roboime/SSL-Mec/README.md

# SSL-Mec
Repositório para a mecânica da SSL
