roboime/SSL-Mec/Robo 2021/SSL/Robô/Conjunto Motriz/073-rb-dfr-444.pdf

## RB-Dfr-444

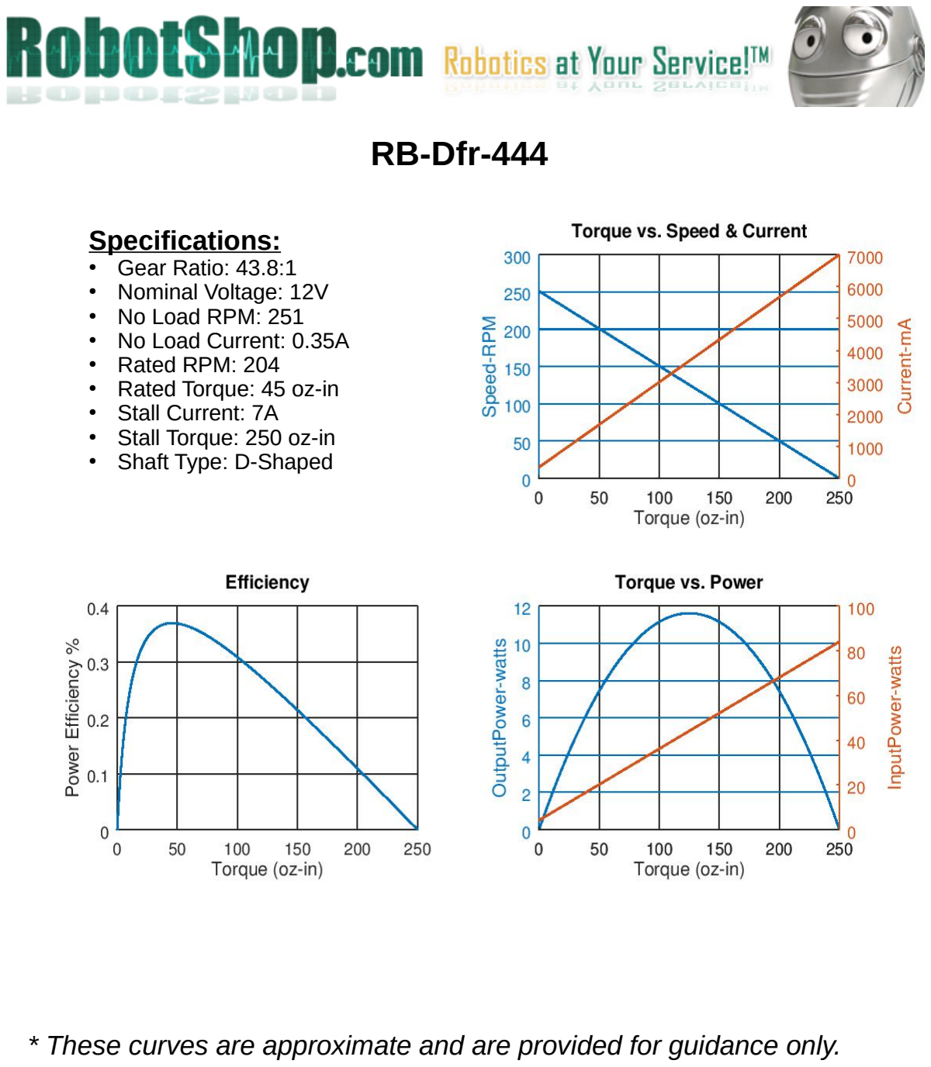
[picture p1: page 1]

* These curves are approximate and are provided for guidance only.

### Specifications:

- Gear Ratio: 43.8:1
- Nominal Voltage: 12V
- No Load RPM: 251
- No Load Current: 0.35A
- Rated RPM: 204
- Rated Torque: 45 oz-in
- Stall Current: 7A
- Stall Torque: 250 oz-in
- Shaft Type: D-Shaped
