roboime/SSL-Mec/Robo 2021/Patrono.pdf

Maria Quitéria de Jesus (27 de julho de 1792 – 21 de agosto de 1853) foi a primeira mulher a fazer parte do Exército Brasileiro. Considerada a heroína da I (https://brasilescola.uol.com.br/historiab/independencia-brasil.htm)ndependência, (https://brasilescola.uol.com.br/historiab/independencia-brasil.htm) a baiana fingiu ser homem para poder entrar nas Forças Armadas.
A jovem Maria Quitéria juntou-se às tropas que lutavam contra os portugueses em 1822. Ela utilizou o nome de seu cunhado, ficando conhecida como soldado Medeiros, já que somente homens faziam parte do Exército.

Semanas depois de entrar para o Exército, Maria Quitéria teve sua identidade revelada. No entanto, o major Silva e Castro não permitiu que ela saísse das tropas, já que era importante para a luta contra os portugueses por sua facilidade com o manejo de armas e sua disciplina em batalha.

Maria Quitéria tornou-se símbolo da emancipação feminina e exemplo para mulheres de todo o país.

A heroína da Independência foi condecorada patrona do Quadro Complementar de Oficiais do Exército Brasileiro. Em 1953, no aniversário de 100 anos de sua morte, o governo brasileiro decretou que seu retrato estivesse presente em todos as repartições e unidades do Exército.
