roboime/SSL-Mec/Robo 2021/SSL/Diversos/apostila-aco-inoxestampagem-28-728.jpg

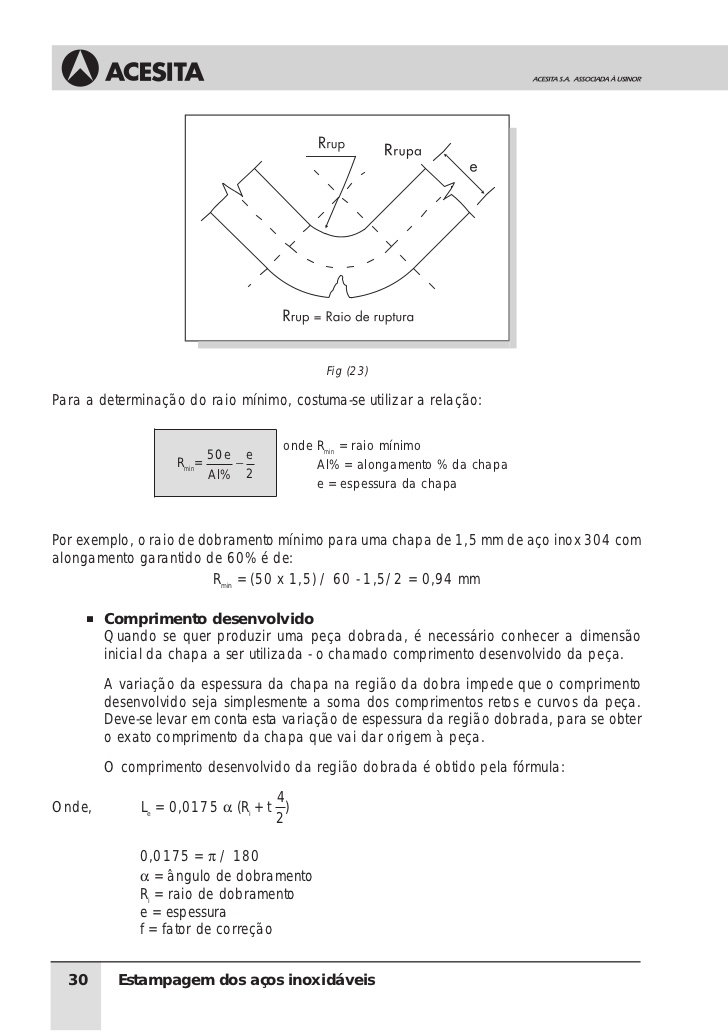
Robo 2021/SSL/Diversos/apostila-aco-inoxestampagem-28-728.jpg
