roboime/SSL-Mec/Project_2024/Sistema de chute/Acionador Chute Rasteiro.SLDASM

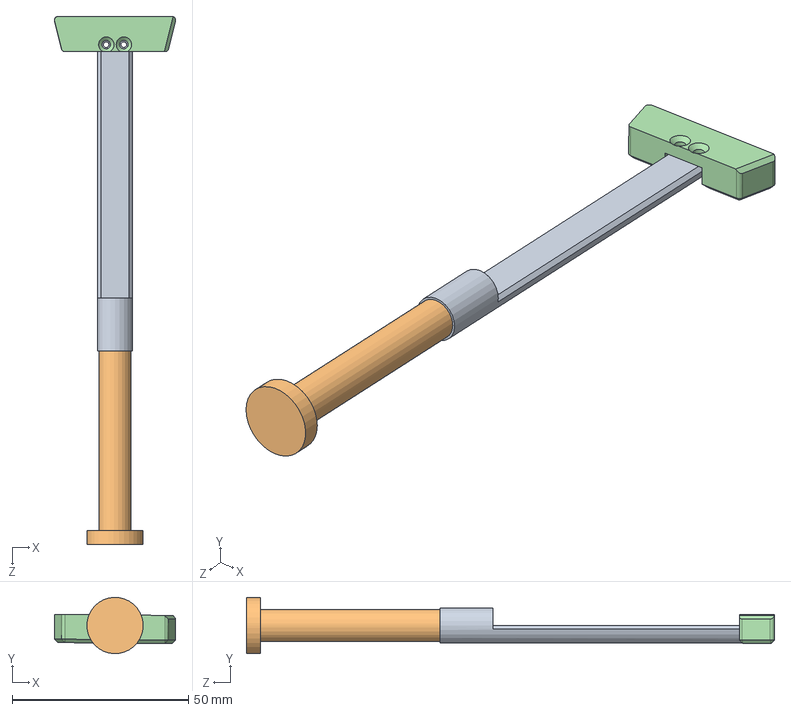
[picture p3: CAD file, 2024-02-03]
Project_2024/Sistema de chute/Acionador Chute Rasteiro.SLDASM
34.5 x 16.0 x 150.0 mm
Intermediário Chute-Alto
Pistão Chute Alto
Representação Eixo do Chute
Chute Rasteiro
