roboime/SSL-Mec/Project_2024/Sistema de chute/Driblador/Motor Driblador.SLDASM

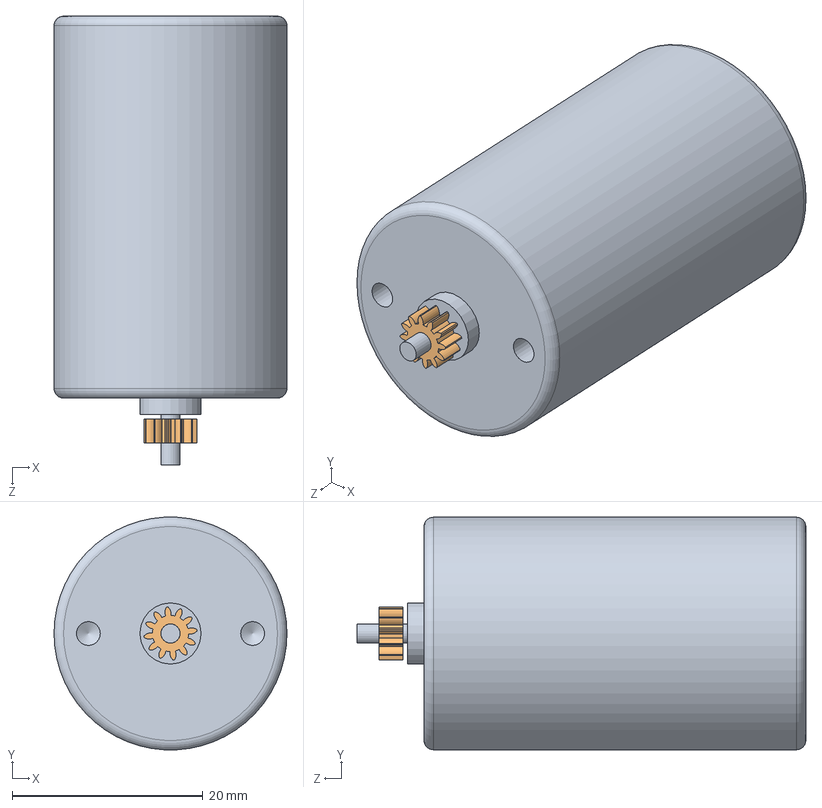
[picture p4: CAD file, 2024-02-03]
Project_2024/Sistema de chute/Driblador/Motor Driblador.SLDASM
24.4 x 24.4 x 47.0 mm
Mockup motor do driblador
Metric - Spur gear 0.4M 12T 20PA 2.5FW ---S12N75H50L2N
