roboime/SSL-Mec/Robo 2021/SSL/Robô/Conjunto Motriz/Conjunto Omni/45 mm/Montagem das peças a serem usinadas.SLDASM

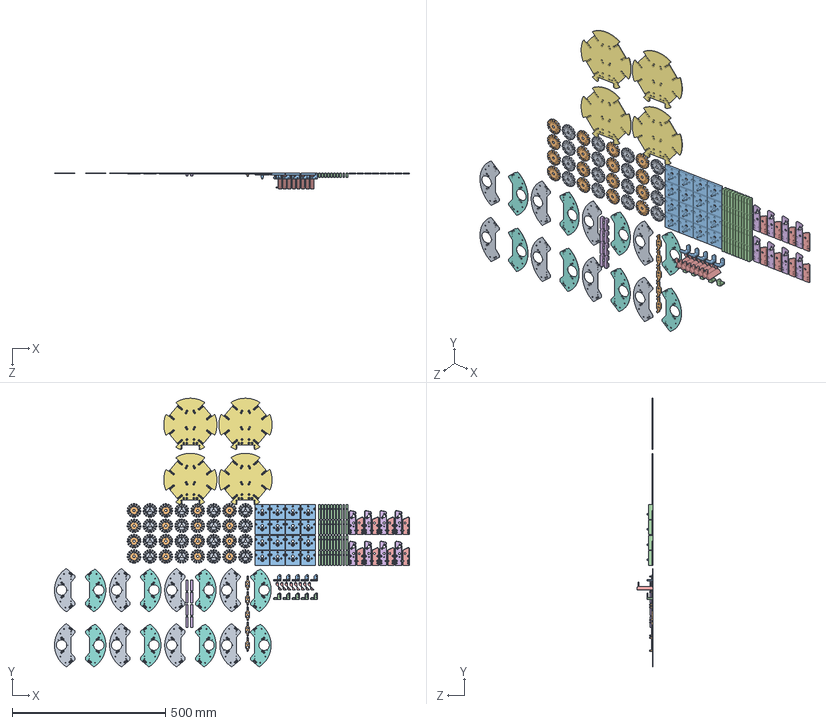
[picture p5: CAD file, 2021-10-12]
Robo 2021/SSL/Robô/Conjunto Motriz/Conjunto Omni/45 mm/Montagem das peças a serem usinadas.SLDASM
1159.9 x 877.7 x 53.0 mm
Corpo Interno x 16
Corpo Externo x 16
Suporte da roda x 16
Suporte Estrutura Aluminio x 40
Suporte esquerdo driblador x 8
Suporte direito driblador x 8
Assoalho x 4
2 Andar - Direito x 8
2 Andar - Esquerdo x 8
Apoio engrenagem x 5
Suporte Chute-Alto Esquerdo x 5
Suporte Chute-Alto Direito x 5
Chip - Chute Alto x 8
Chute rasteiro novo x 8
