roboime/SSL-Mec/Robo 2021/SSL/Robô/Conjunto Motriz/Motor e Suporte/Suporte montado.SLDASM

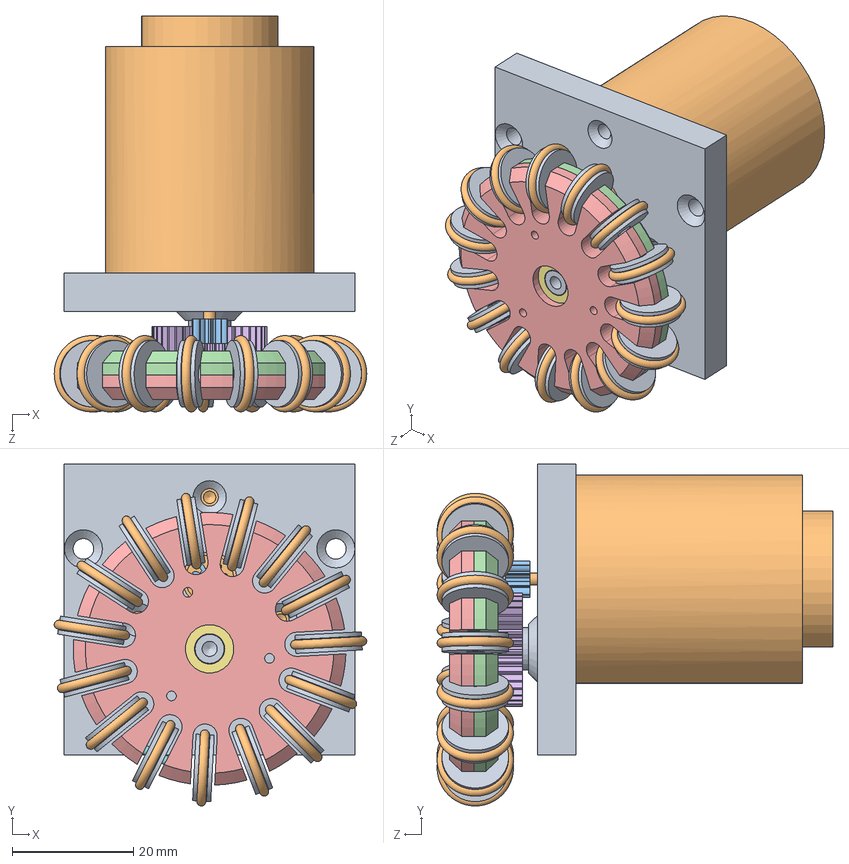
[picture p6: CAD file, 2021-10-12]
Robo 2021/SSL/Robô/Conjunto Motriz/Motor e Suporte/Suporte montado.SLDASM
51.6 x 56.4 x 65.3 mm
Suporte da roda
Mockup Motor
Metric - Spur gear 0.5M 10T 20PA 3,5FW
Corpo Interno
Corpo Externo
Metric - Spur gear 0.5M 36T 20PA
5x9x4
Arame
Rodilha x 15
O-Ring 10x7x1,5 mm x 15
