roboime/SSL-Mec/Robo 2021/SSL/Robô/engrenagens a Imprimir.SLDASM

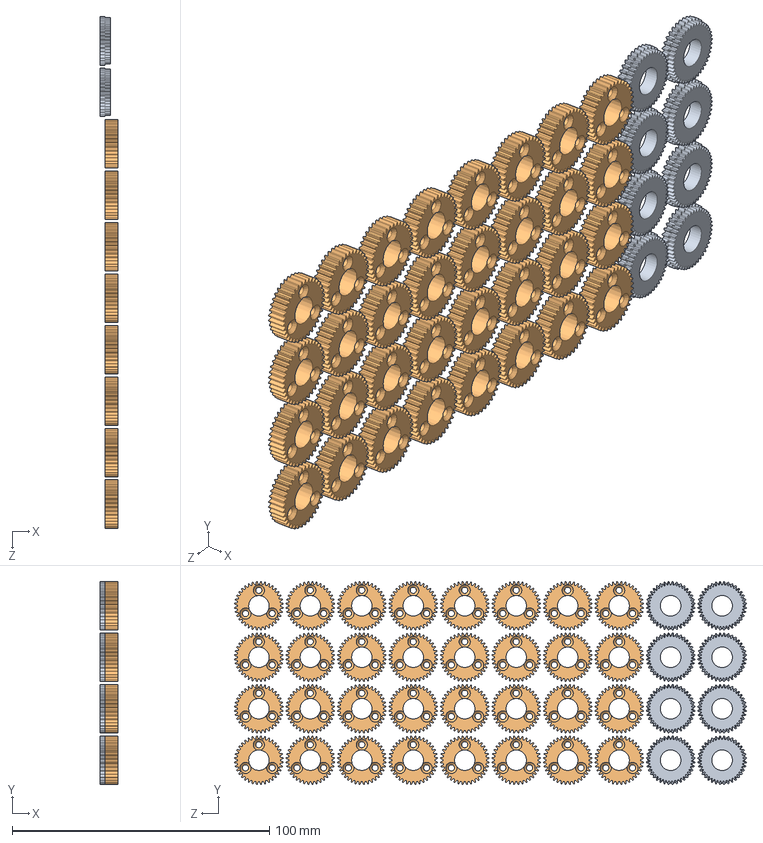
[picture p7: CAD file, 2021-10-12]
Robo 2021/SSL/Robô/engrenagens a Imprimir.SLDASM
7.00 x 79.0 x 199.0 mm
engrengens x 8
Metric - Spur gear 0.5M 36T 20PA x 32
