roboime/SSL-Mec/Robo 2021/SSL/Robô/Montagens/Montagem Segundo Andar- Esquerdo.SLDASM

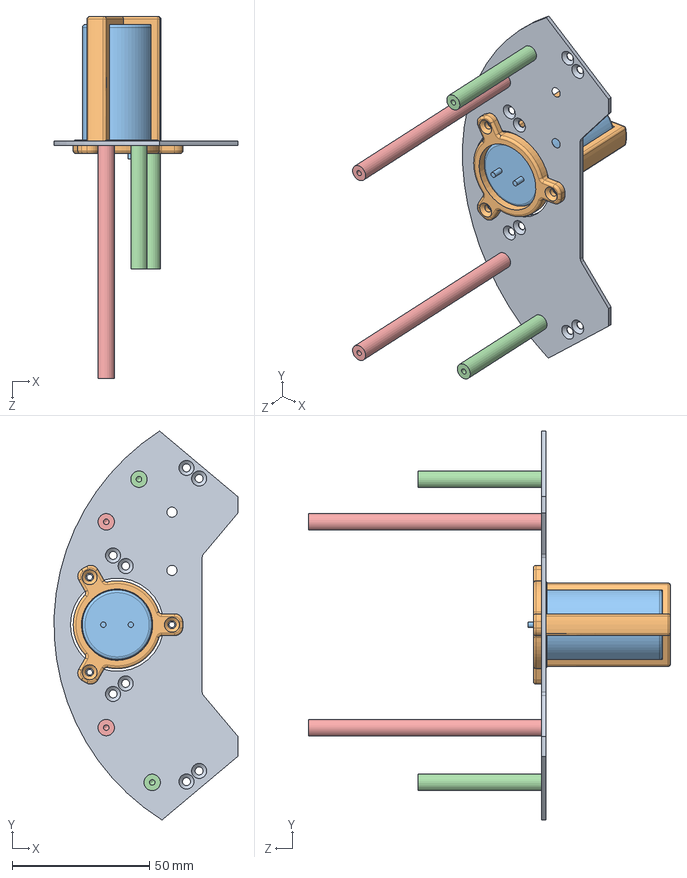
[picture p8: CAD file, 2021-10-12]
Robo 2021/SSL/Robô/Montagens/Montagem Segundo Andar- Esquerdo.SLDASM
66.9 x 141.8 x 132.0 mm
2 Andar - Esquerdo
Suporte do Capacitor
Mockup Capacitor
Suporte ELO x 2
Suporte Tampa x 2
