roboime/SSL-Mec/Robo 2021/SSL/Robô/Suportes da ELO/Mockup Mainboard.SLDPRT

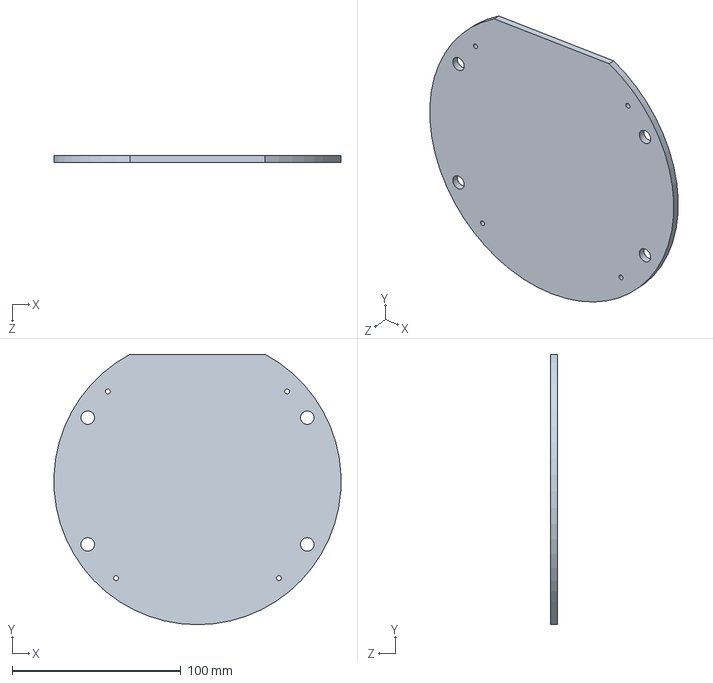
[picture p9: CAD file, 2021-10-04]
Robo 2021/SSL/Robô/Suportes da ELO/Mockup Mainboard.SLDPRT
169.8 x 160.0 x 4.00 mm
