roboime/SSL-Mec/Project_2024/Sistema de chute/Chip Alto - Montado.SLDASM

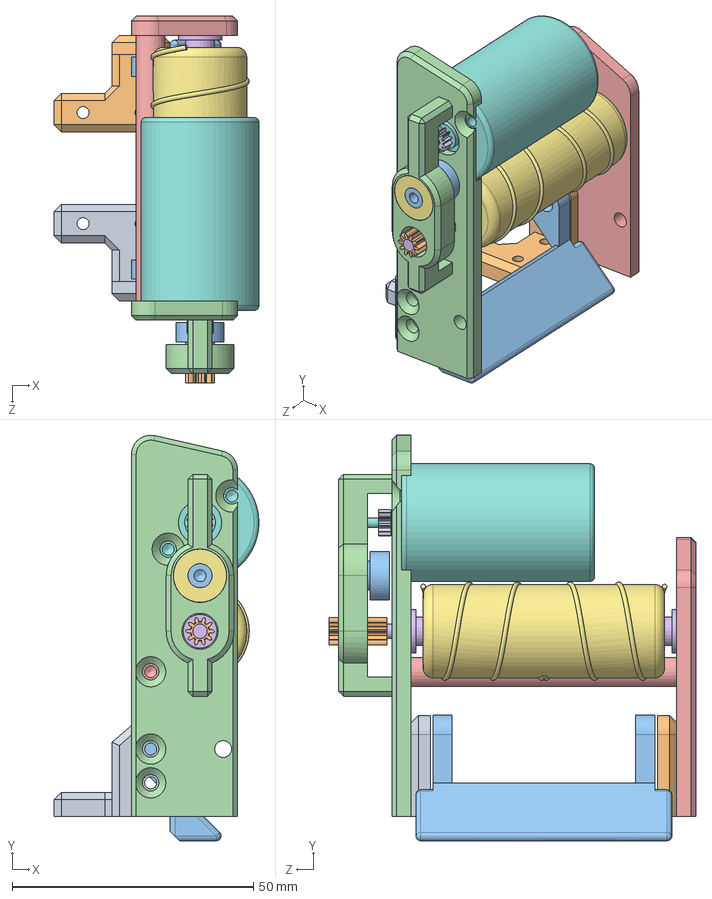
[picture p10: CAD file, 2024-02-03]
Project_2024/Sistema de chute/Chip Alto - Montado.SLDASM
42.4 x 84.0 x 76.0 mm
Suporte Chute-Alto Direito
Suporte Chute-Alto Esquerdo
Chip - Chute Alto
Suporte direito driblador
Suporte esquerdo driblador
Eixo Driblador
Rolete Driblador
Mockup motor do driblador
Metric - Spur gear 0.4M 12T 20PA 2.5FW ---S12N75H50L2N
Metric - Spur gear 0.5M 10T 20PA 12FW
Eixo engrenagem do drible
Apoio engrenagem
Estrutura transversal
Rolamento 4x9x4 x 2
5x9x4 do Chute
