roboime/SSL-Mec/Robo 2021/SSL/Diversos/Motor + Suporte + Caixa Redutora/SUPORTE+MOTOR LARC Opção B.SLDASM

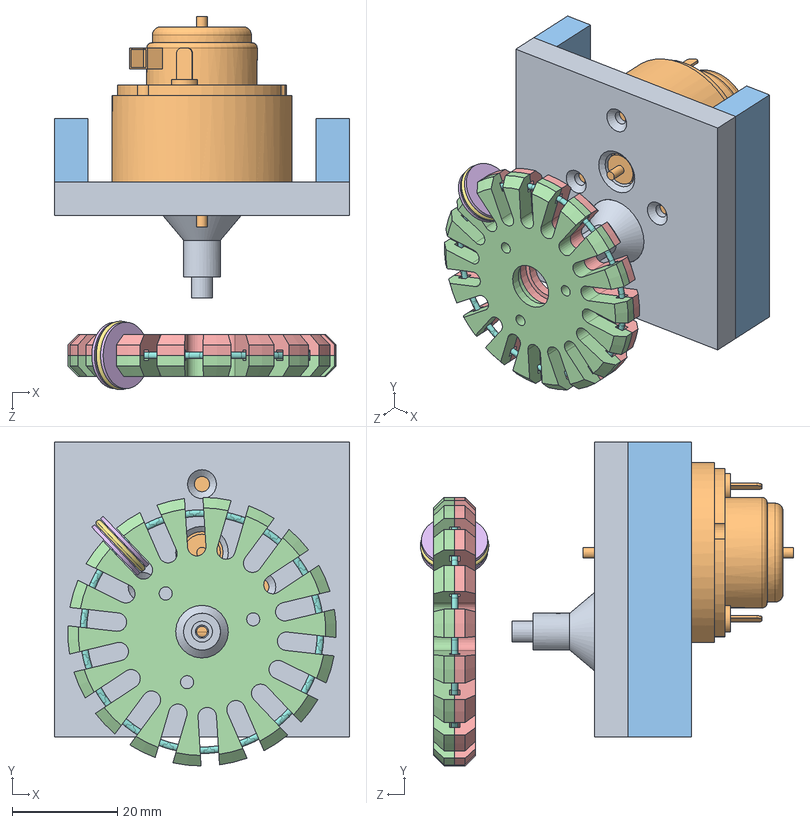
[picture p11: CAD file, 2021-10-04]
Robo 2021/SSL/Diversos/Motor + Suporte + Caixa Redutora/SUPORTE+MOTOR LARC Opção B.SLDASM
56.0 x 61.5 x 70.9 mm
SUPORTE_MOTOR LARC
Suporte Estrutura b x 2
Eixo
