roboime/SSL-Mec/Robo 2021/SSL/Diversos/Teste de posição.SLDASM

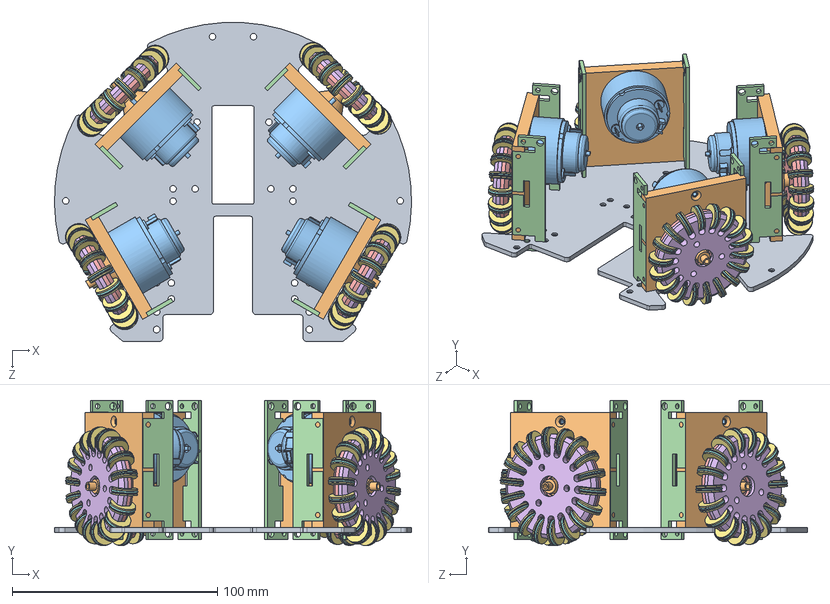
[picture p12: CAD file, 2021-10-04]
Robo 2021/SSL/Diversos/Teste de posição.SLDASM
174.0 x 70.8 x 155.4 mm
Assoalho
SUPORTE_MOTOR LARC x 4
Hsiang Neng Motor LARC x 4
Suporte Estrutura x 8
Corpo da Roda externo LARC x 4
Corpo da Roda interno LARC x 4
Rodilha LARC x 72
H-ring (meia manga) LARC x 72
Aro omni LARC x 4
