roboime/SSL-Mec/Robo 2021/SSL/Robô/Conjunto Motriz/Motor e Suporte/Motor.SLDASM

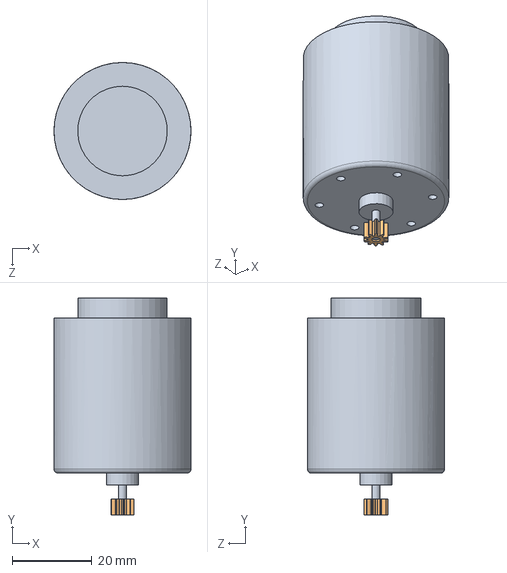
[picture p13: CAD file, 2021-10-12]
Robo 2021/SSL/Robô/Conjunto Motriz/Motor e Suporte/Motor.SLDASM
34.4 x 54.5 x 34.4 mm
Mockup Motor
Metric - Spur gear 0.5M 10T 20PA 3,5FW
