roboime/SSL-Mec/Robo 2021/SSL/Robô/Montagens/Montagem Acionadores dos Chutes.SLDASM

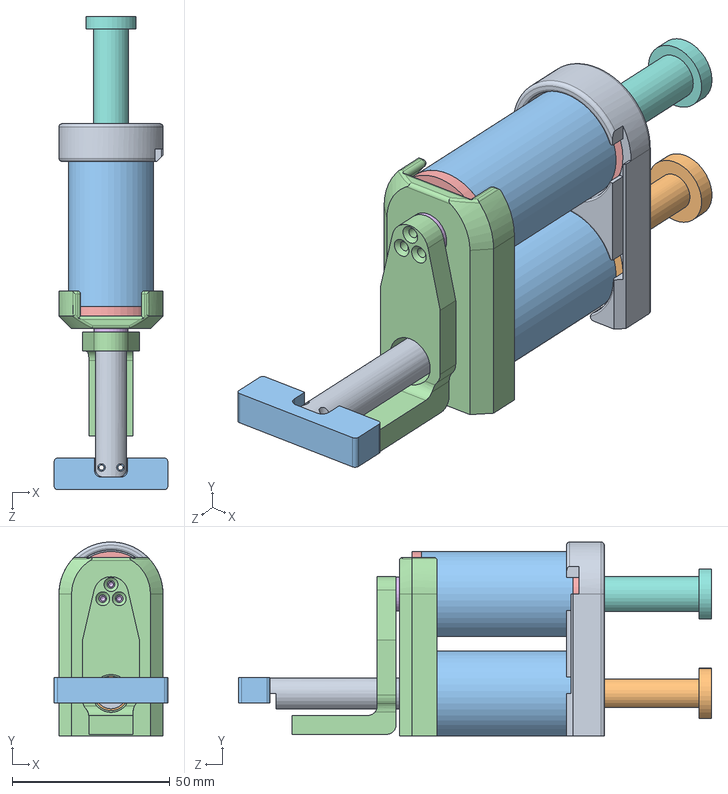
[picture p14: CAD file, 2021-10-12]
Robo 2021/SSL/Robô/Montagens/Montagem Acionadores dos Chutes.SLDASM
36.0 x 61.5 x 150.0 mm
Suporte traseiro
Carretel do Solenoide Alto
Representação Bobina de Cobre x 2
Suporte Frontal
Carretel do Solenoide
Intermediário Chute-Rasteiro
Representação Eixo do Chute x 2
Pistão
Intermediário Chute-Alto
Pistão Chute Alto
Chute rasteiro novo
Acionador Chute Alto 3
