roboime/SSL-Mec/Robo 2021/SSL/Robô/Sistema de chute/SSL-Motherboarda.step.SLDASM

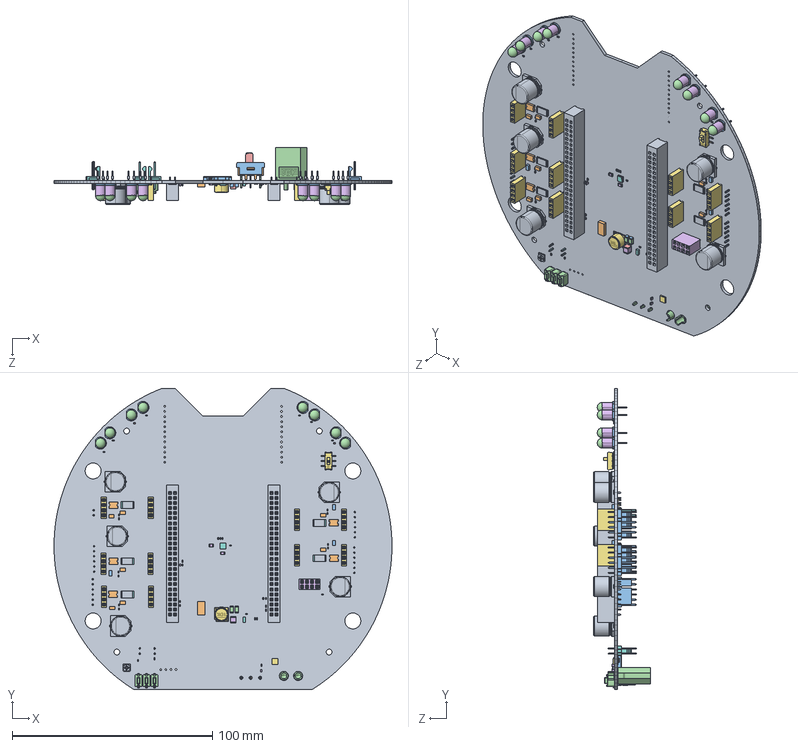
[picture p15: CAD file, 2021-10-12]
Robo 2021/SSL/Robô/Sistema de chute/SSL-Motherboarda.step.SLDASM
169.0 x 150.6 x 28.4 mm
_CS12ANW03-body.step
_CS12ANW03-top.step
_CS12ANW03-term.step
_CS12ANW03-slide.step
Extruded.step x 4
Extruded-0.step
SW3dPS-LEDd5C_Extruded3.step x 16
SW3dPS-LEDd5C_Extruded.step x 16
SW3dPS-LEDd5C_Extruded1.step x 8
SW3dPS-LEDd5C_Extruded4.step x 8
SW3dPS-LEDd5C_Sphere.step x 8
SW3dPS-LEDd5C_Extruded2.step x 8
SW3dPS-LEDd5C_Cylinder.step x 8
1.step
2.step
3.step
BOSCH_logo.step
4.step
95C04B.step x 3
Extruded-1.step x 4
Extruded-2.step x 2
Extruded-3.step x 32
Extruded-4.step x 16
BOUR-TC33X-2_2.step
Extruded-5.step x 2
Extruded-6.step x 3
Extruded-7.step x 16
Extruded-8.step x 11
Extruded-9.step x 6
js202011scqn.step
Extruded-10.step x 10
Extruded-11.step x 5
Extruded-12.step x 5
2908-05xx-xx-02.step
Extruded-13.step x 16
Extruded-14.step x 8
_____C042LFBN-RC_RGB8421504.step
_____C041LFBN-RC_RGB8421504.step x 10
SW3dPS-capg.step x 5
mf-msmf250_16x_RGB8421504.step x 5
Extruded-16.step x 4
Extruded-17.step x 2
Extruded-18.step x 2
Extruded-19.step
User_Library-Coil.step
Extruded-20.step
SFH11-P___C-D25-ST-___-M181.step x 2
Extruded-21.step
User_Library-XT60_male.step
