roboime/SSL-Mec/Robo 2021/SSL/Robô/Conjunto Motriz/Conjunto Omni/45 mm/Montagem da roda.SLDASM

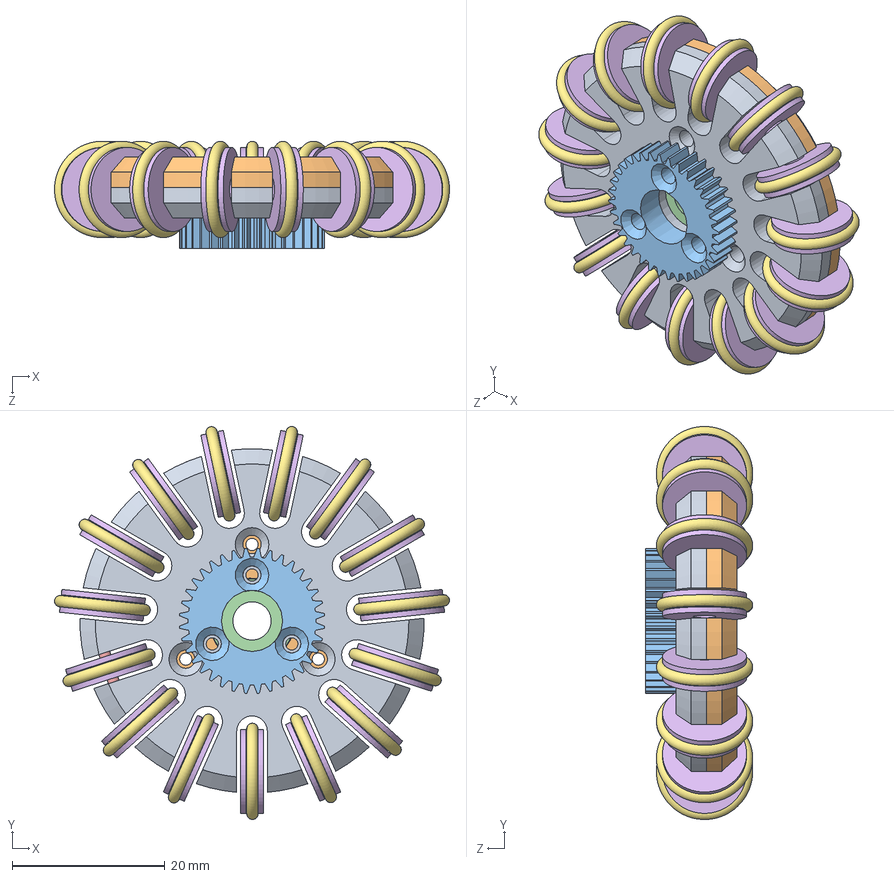
[picture p16: CAD file, 2021-10-12]
Robo 2021/SSL/Robô/Conjunto Motriz/Conjunto Omni/45 mm/Montagem da roda.SLDASM
51.6 x 51.4 x 14.0 mm
Corpo Interno
Corpo Externo
Metric - Spur gear 0.5M 36T 20PA
5x9x4
Arame
Rodilha x 15
O-Ring 10x7x1,5 mm x 15
