roboime/SSL-Mec/Robo 2021/SSL/Robô/Conjunto Motriz/Conjunto Omni/Conjunto Motriz(1).sldasm

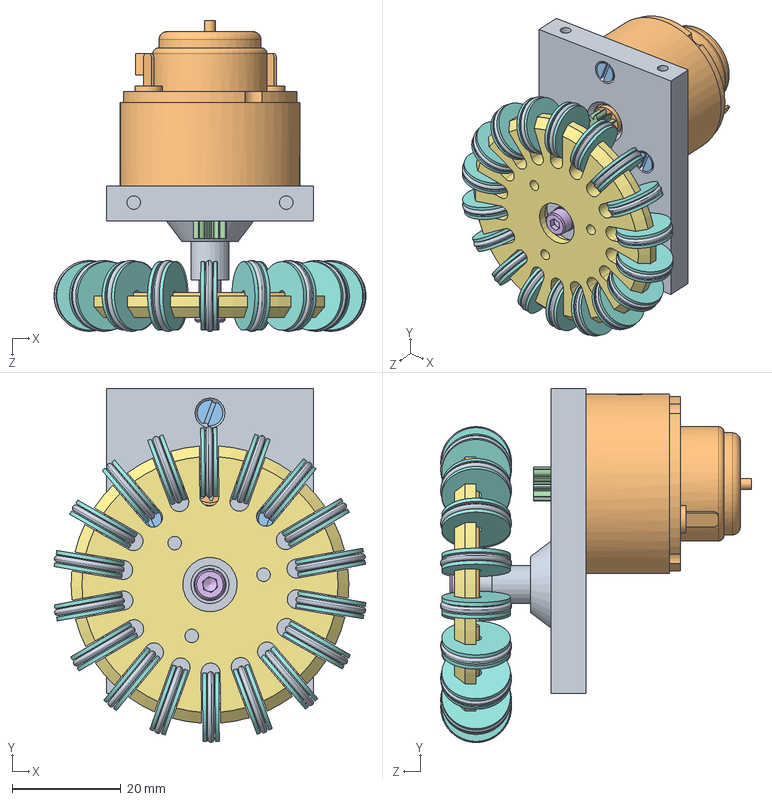
[picture p17: CAD file, 2021-10-04]
Robo 2021/SSL/Robô/Conjunto Motriz/Conjunto Omni/Conjunto Motriz(1).sldasm
57.3 x 65.0 x 57.0 mm
SUPORTE_MOTOR LARC
Hsiang Neng Motor LARC
M3x13 Escareada - Fenda x 3
Engrenagem do MotorC LARC
Arruela M3
M3x10 Cilindrica - Allien
Corpo da Roda externo LARC
Rodilha LARC x 18
H-ring (meia manga) LARC x 18
Aro omni LARC
