roboime/SSL-Mec/Robo 2021/SSL/Robô/Conjunto Motriz/Conjunto Omni/Rodilha Com O-Ring/Rodilha Com O Ring.SLDASM

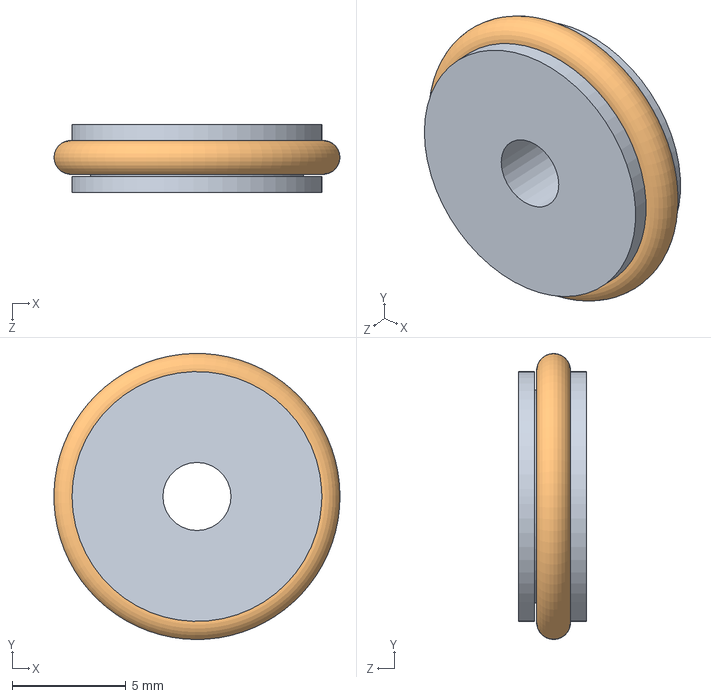
[picture p18: CAD file, 2021-10-04]
Robo 2021/SSL/Robô/Conjunto Motriz/Conjunto Omni/Rodilha Com O-Ring/Rodilha Com O Ring.SLDASM
12.6 x 12.6 x 3.00 mm
Rodilha
O-Ring 10x7x1,5 mm
