roboime/SSL-Mec/Robo 2021/SSL/Robô/Conjunto Motriz/Motor e Suporte/Motor/Mockup Motor.SLDASM

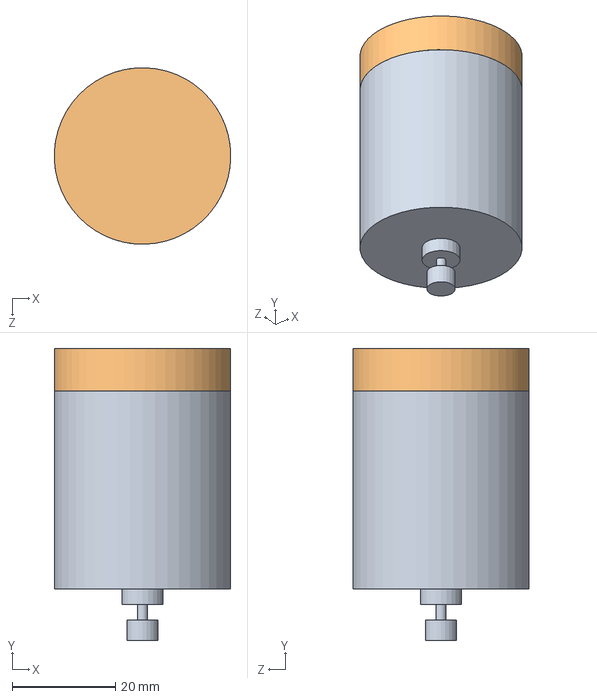
[picture p19: CAD file, 2021-10-04]
Robo 2021/SSL/Robô/Conjunto Motriz/Motor e Suporte/Motor/Mockup Motor.SLDASM
34.2 x 56.5 x 34.2 mm
motor
Tampa preta motor
