roboime/SSL-Mec/Robo 2021/SSL/Robô/Montagens/Montagem Motriz 1.SLDASM

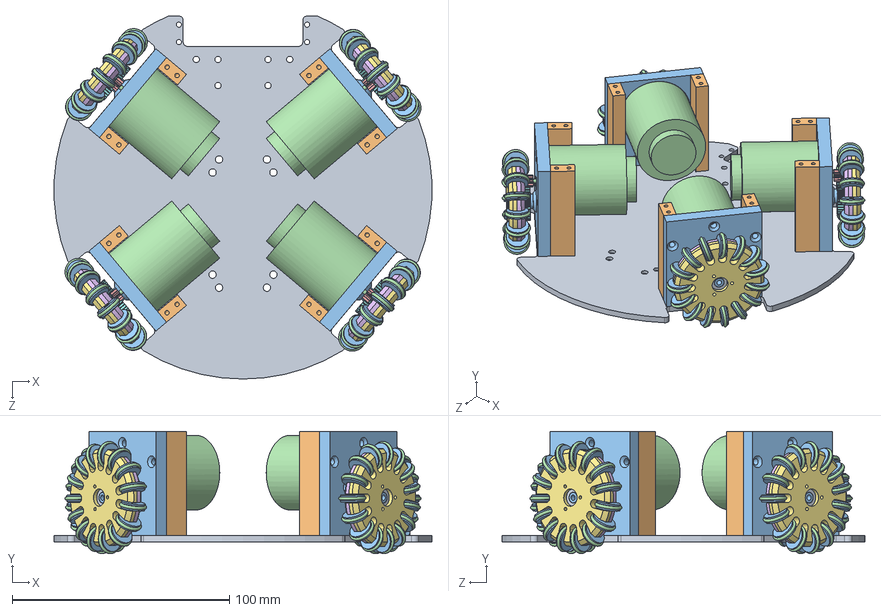
[picture p20: CAD file, 2021-10-12]
Robo 2021/SSL/Robô/Montagens/Montagem Motriz 1.SLDASM
173.7 x 56.3 x 167.0 mm
Assoalho
Suporte Estrutura Aluminio x 8
Suporte da roda x 4
Mockup Motor x 4
Metric - Spur gear 0.5M 10T 20PA 3,5FW x 4
Corpo Interno x 4
Corpo Externo x 4
Metric - Spur gear 0.5M 36T 20PA x 4
5x9x4 x 4
Arame x 4
Rodilha x 60
O-Ring 10x7x1,5 mm x 60
