roboime/SSL-Mec/Project_2024/Sistema de chute/Acionador Chute Alto 2.SLDASM

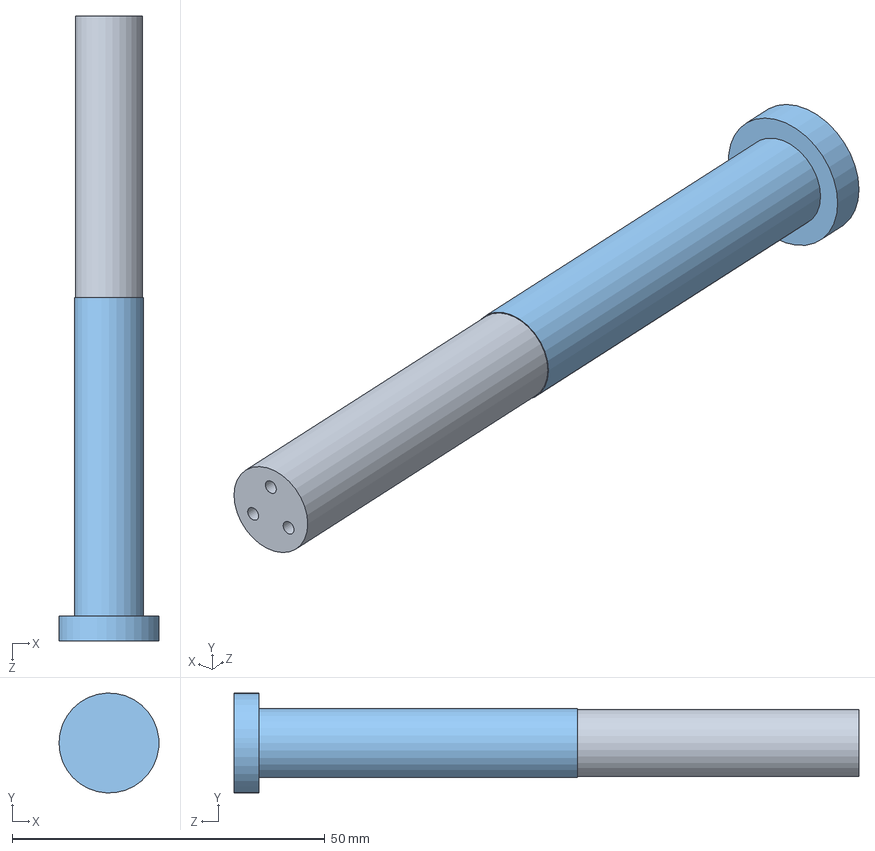
[picture p21: CAD file, 2024-02-03]
Project_2024/Sistema de chute/Acionador Chute Alto 2.SLDASM
16.0 x 16.0 x 100.0 mm
Intermediário Chute-Rasteiro
Representação Eixo do Chute
Pistão
