roboime/SSL-Mec/Robo 2021/SSL/Diversos/Teste de posição 2.SLDASM

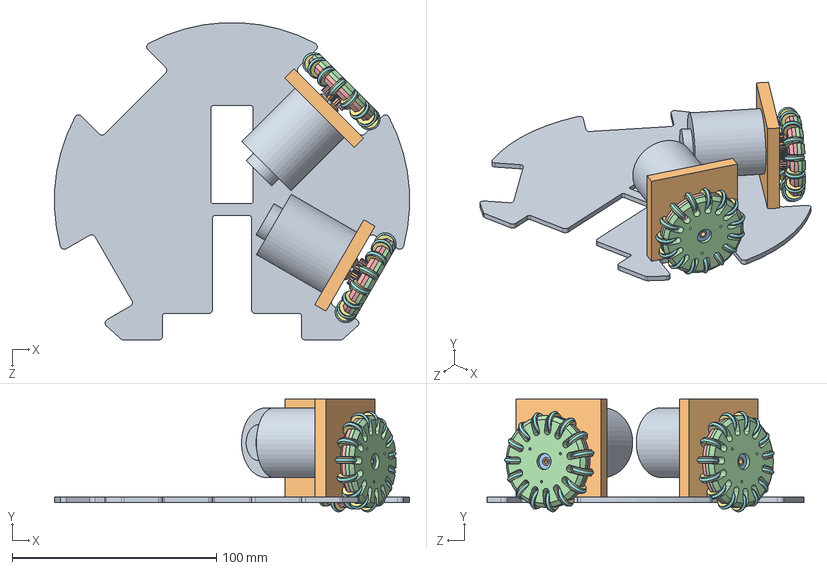
[picture p22: CAD file, 2021-10-04]
Robo 2021/SSL/Diversos/Teste de posição 2.SLDASM
173.8 x 55.2 x 155.4 mm
Assoalho - Copia
Suporte da roda x 2
Rep Rolamento 4x9x4mm x 2
Corpo Externo de 30 x 2
Interna de 30 dentes x 2
Aro de Rodilha x 2
Rodilha x 30
O-Ring 10,5x7,5x1,5 mm x 30
Mockup Motor x 2
Engrenagem do Motor x 2
