roboime/SSL-Mec/Robo 2021/SSL/Robô/Conjunto Motriz/Conjunto Omni/45 mm/Montagem das peças a serem usinadas - torno.SLDASM

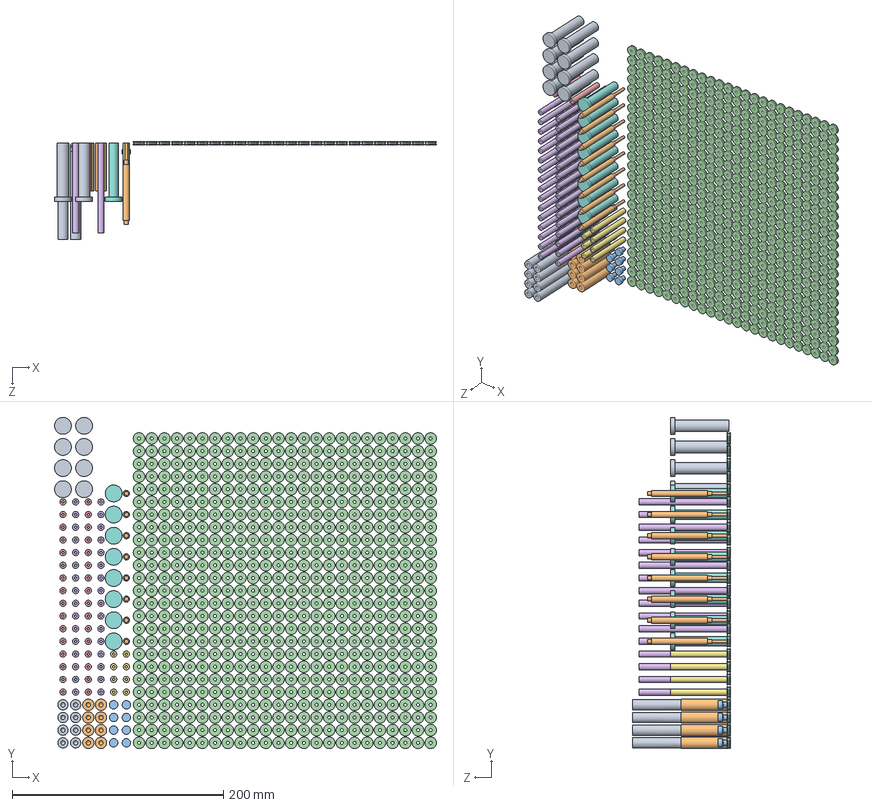
[picture p23: CAD file, 2021-10-12]
Robo 2021/SSL/Robô/Conjunto Motriz/Conjunto Omni/45 mm/Montagem das peças a serem usinadas - torno.SLDASM
361.5 x 313.5 x 92.5 mm
Intermediário Chute-Alto x 8
Intermediário Chute-Rasteiro x 8
Eixo engrenagem do drible x 8
Rodilha x 600
Suporte ELO x 32
Suporte Tampa x 32
Estrutura transversal x 8
Pistão Chute Alto x 8
Pistão x 8
Eixo Driblador x 8
