roboime/SSL-Mec/Robo 2021/SSL/Robô/Suportes da ELO/Suporte com Capacitor.SLDASM

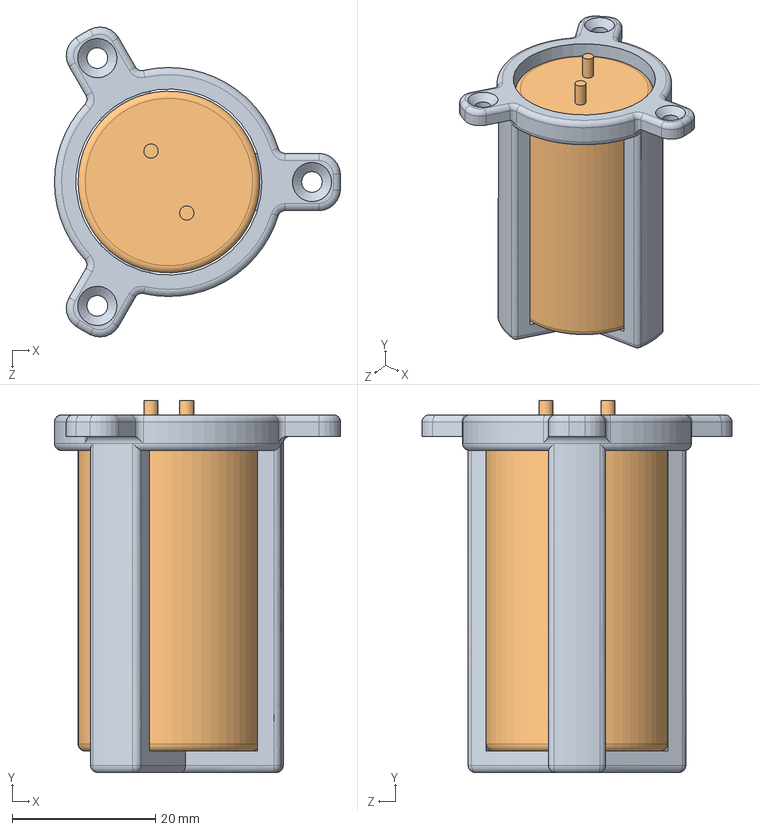
[picture p24: CAD file, 2021-10-04]
Robo 2021/SSL/Robô/Suportes da ELO/Suporte com Capacitor.SLDASM
40.0 x 52.0 x 43.3 mm
Suporte do Capacitor
Mockup Capacitor
