roboime/SSL-Mec/Robo 2021/SSL/Diversos/Motor + Suporte + Caixa Redutora/SUPORTE+MOTOR LARC.SLDASM

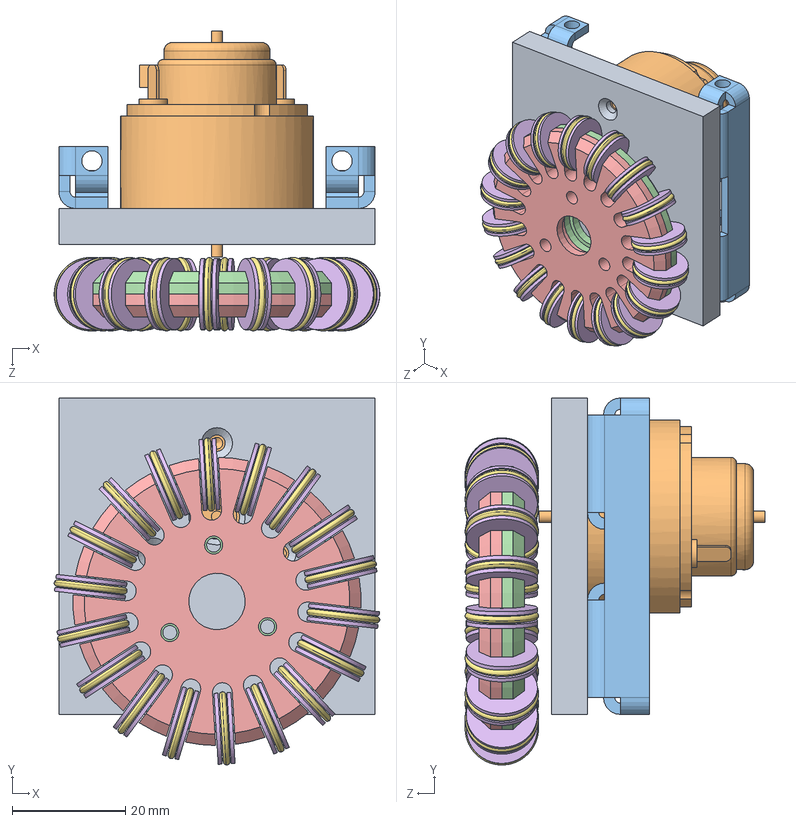
[picture p25: CAD file, 2021-10-04]
Robo 2021/SSL/Diversos/Motor + Suporte + Caixa Redutora/SUPORTE+MOTOR LARC.SLDASM
57.6 x 64.9 x 53.1 mm
SUPORTE_MOTOR LARC
Hsiang Neng Motor LARC
Suporte Estrutura x 2
Corpo da Roda externo LARC
Corpo da Roda interno LARC
Rodilha LARC x 18
H-ring (meia manga) LARC x 18
Aro omni LARC
