roboime/SSL-Mec/Robo 2021/SSL/Robô/Montagens/Montagem 2 Andar.SLDASM

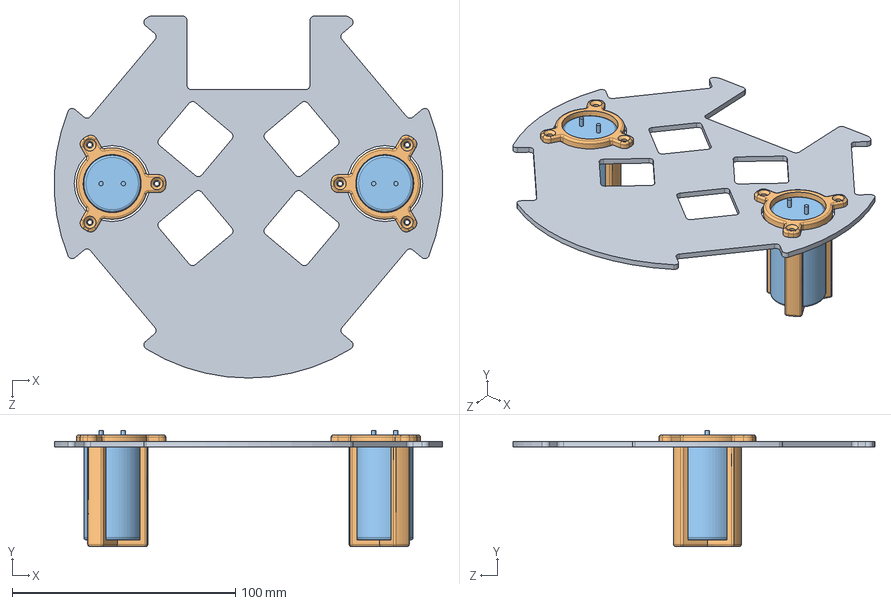
[picture p26: CAD file, 2021-10-04]
Robo 2021/SSL/Robô/Montagens/Montagem 2 Andar.SLDASM
173.7 x 52.0 x 162.0 mm
2 Andar
Suporte do Capacitor x 2
Mockup Capacitor x 2
