roboime/SSL-Mec/Robo 2021/SSL/Robô/Sistema de chute/Driblador/engrengens.SLDASM

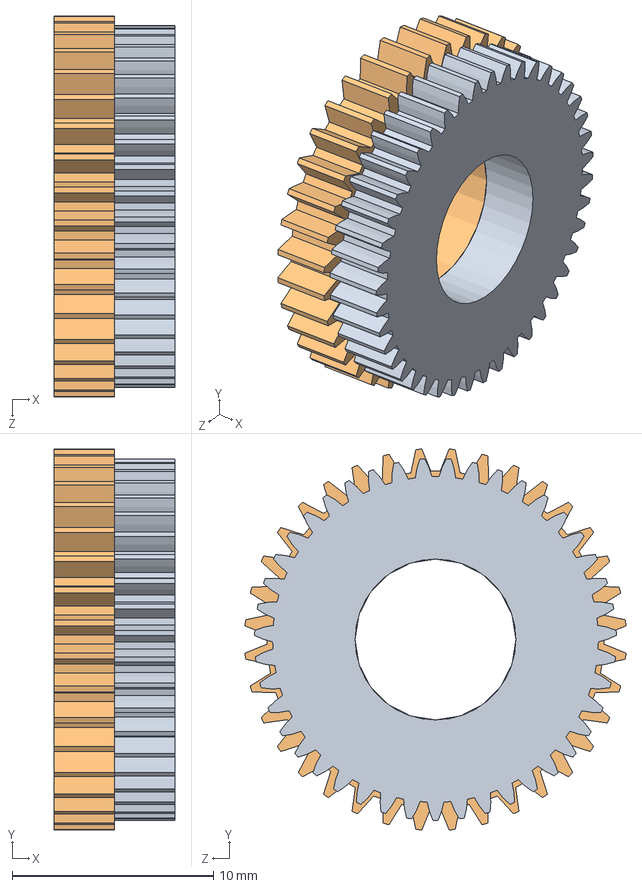
[picture p27: CAD file, 2021-10-12]
Robo 2021/SSL/Robô/Sistema de chute/Driblador/engrengens.SLDASM
6.00 x 19.0 x 19.0 mm
Metric - Spur gear 0.4M 43T 20PA 3FW ---S43N75H50L8N
Metric - Spur gear 0.5M 36T 20PA
