roboime/SSL-Mec/Project_2024/Sistema de chute/Suporte com solenoides.SLDASM

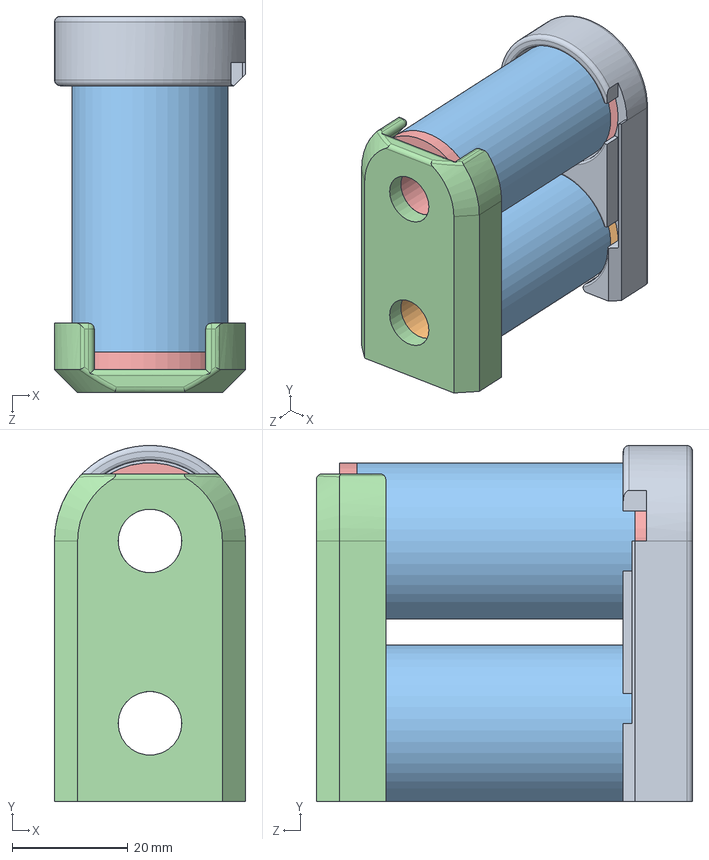
[picture p28: CAD file, 2021-10-04]
Project_2024/Sistema de chute/Suporte com solenoides.SLDASM
33.0 x 61.5 x 65.0 mm
Suporte traseiro
Carretel do Solenoide Alto
Representação Bobina de Cobre x 2
Suporte Frontal
Carretel do Solenoide
