roboime/SSL-Mec/Robo 2021/SSL/Robô/Conjunto Motriz/Conjunto Omni/45 mm/Montagem da Roda 30 dentes.SLDASM

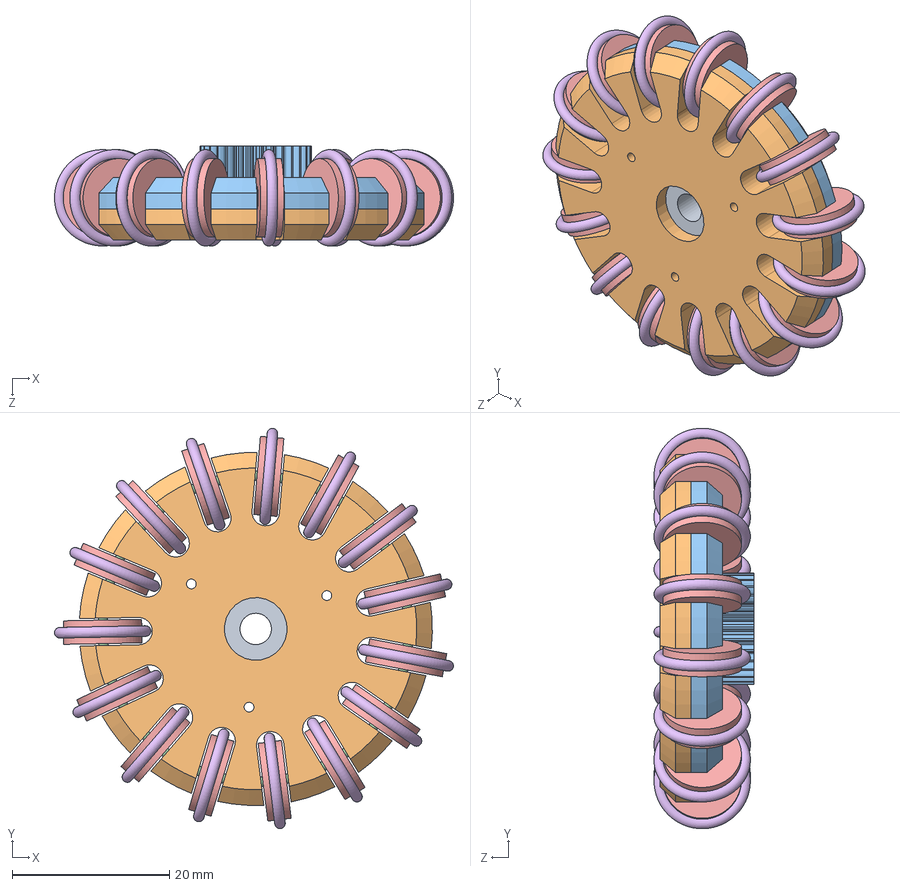
[picture p29: CAD file, 2021-10-04]
Robo 2021/SSL/Robô/Conjunto Motriz/Conjunto Omni/45 mm/Montagem da Roda 30 dentes.SLDASM
50.8 x 51.0 x 12.7 mm
Rep Rolamento 4x9x4mm
Corpo Externo de 30
Interna de 30 dentes
Aro de Rodilha
Rodilha x 15
O-Ring 10x7x1,5 mm x 15
