roboime/SSL-Mec/Project_2024/Sistema de chute/Representação Solenoide com Bobina.SLDASM

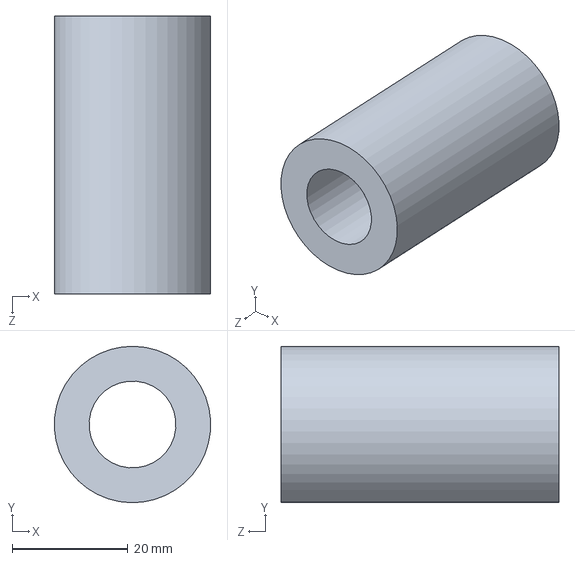
[picture p30: CAD file, 2021-10-04]
Project_2024/Sistema de chute/Representação Solenoide com Bobina.SLDASM
27.0 x 27.0 x 48.0 mm
