roboime/SSL-Mec/Project_2024/Sistema de chute/driblador.SLDASM

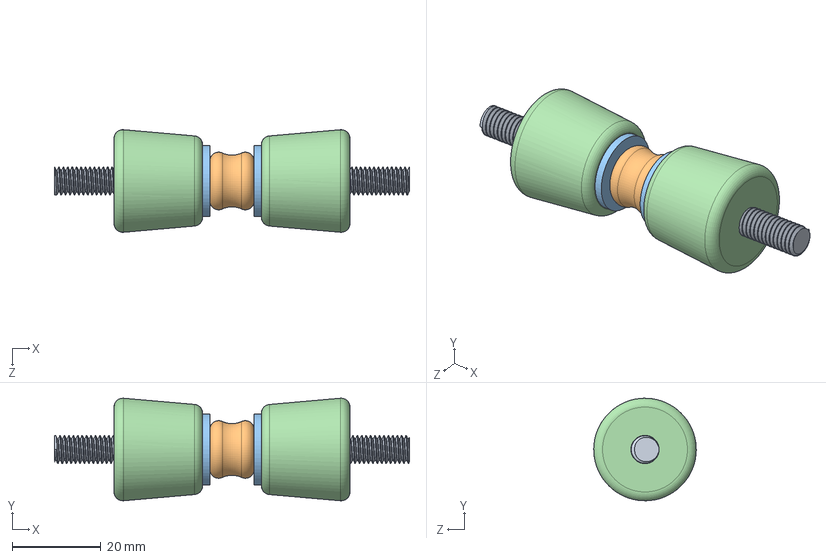
[picture p31: CAD file, 2021-10-04]
Project_2024/Sistema de chute/driblador.SLDASM
80.0 x 23.1 x 23.1 mm
eixo
polia
plain washer 10669 type nl_iso x 2
rolete x 2
