roboime/SSL-Mec/Project_2024/Peças e Montagens/Roda.SLDASM

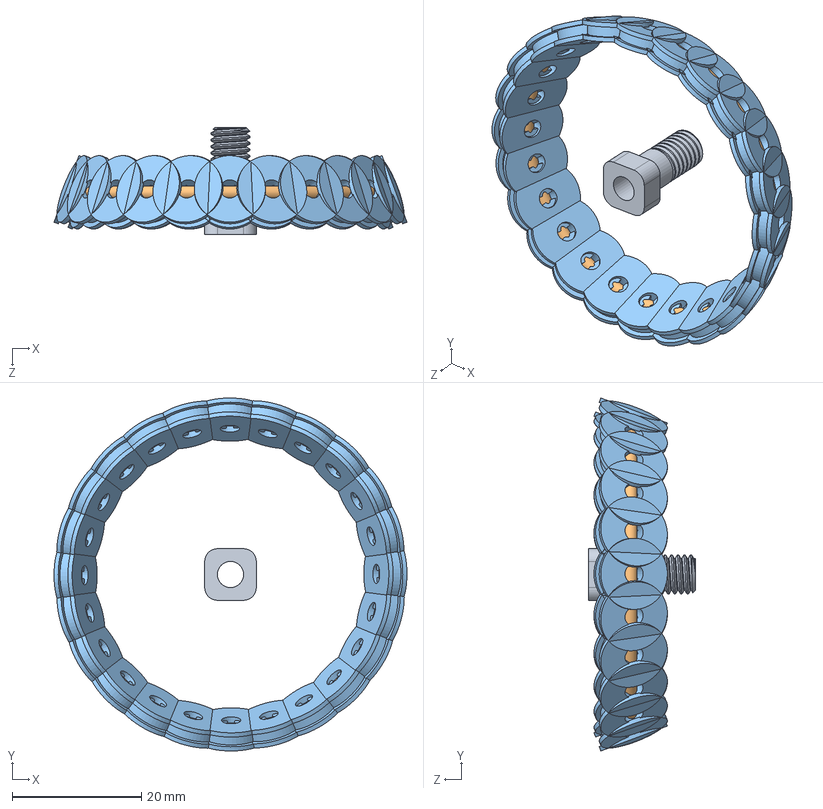
[picture p32: CAD file, 2024-02-03]
Project_2024/Peças e Montagens/Roda.SLDASM
54.6 x 54.6 x 16.5 mm
Rodilha x 24
Eixo da rodilha x 24
Transmissor de torque da roda
