roboime/SSL-Mec/Project_2024/Peças e Montagens/Roda explodida.SLDASM

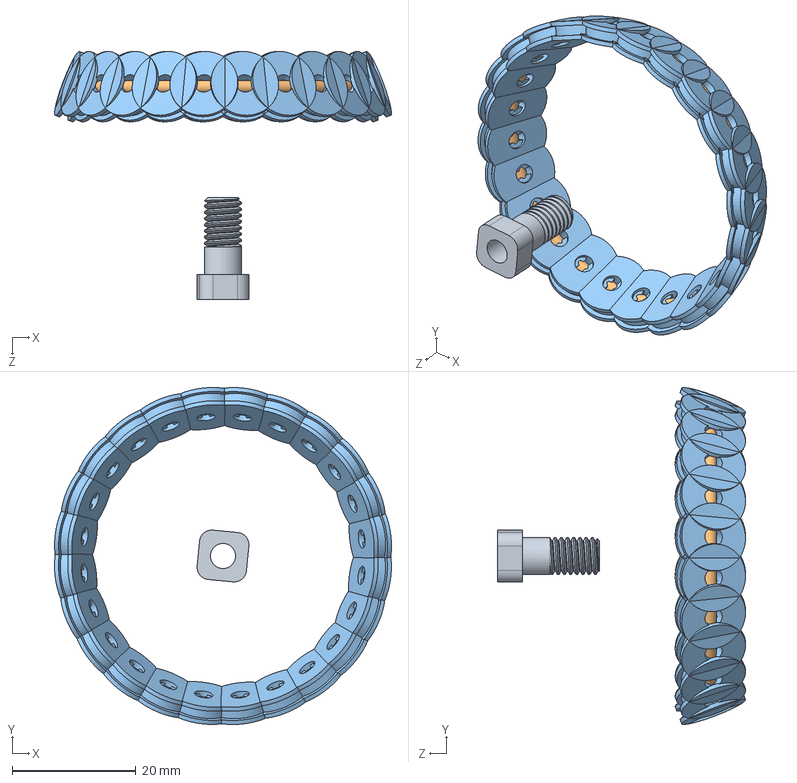
[picture p33: CAD file, 2024-02-03]
Project_2024/Peças e Montagens/Roda explodida.SLDASM
54.4 x 54.4 x 40.0 mm
Rodilha x 24
Eixo da rodilha x 24
Transmissor de torque da roda
