roboime/SSL-Mec/Project_2024/Arquivos .STEP para Usinagem/Pistão chute rasteiro.SLDPRT

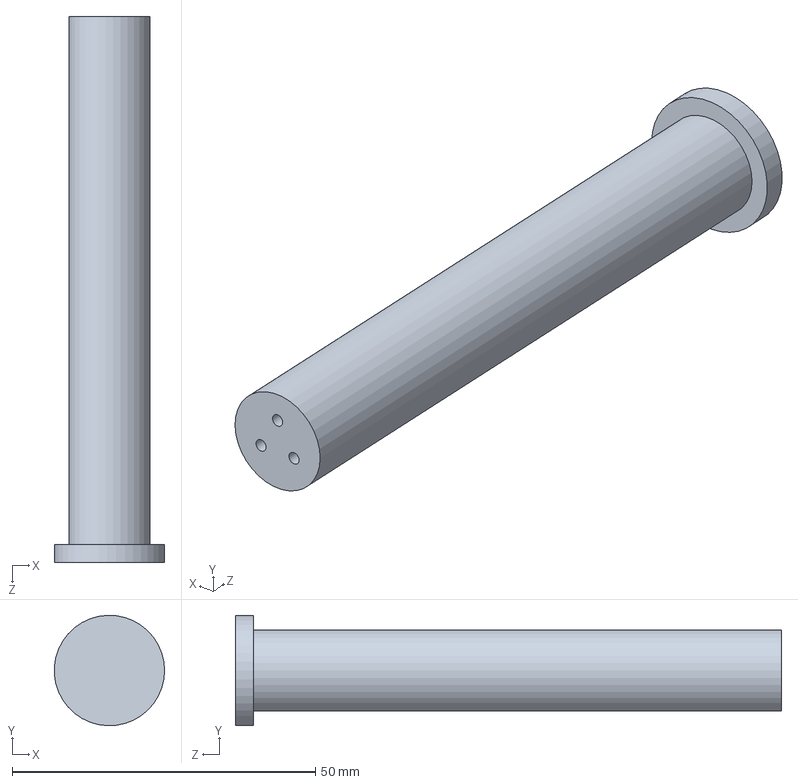
[picture p34: CAD file, 2024-02-03]
Project_2024/Arquivos .STEP para Usinagem/Pistão chute rasteiro.SLDPRT
18.2 x 18.2 x 90.0 mm
