roboime/SSL-Mec/Project_2024/Peças .stl/Suporte chute alto esquerdo.STL

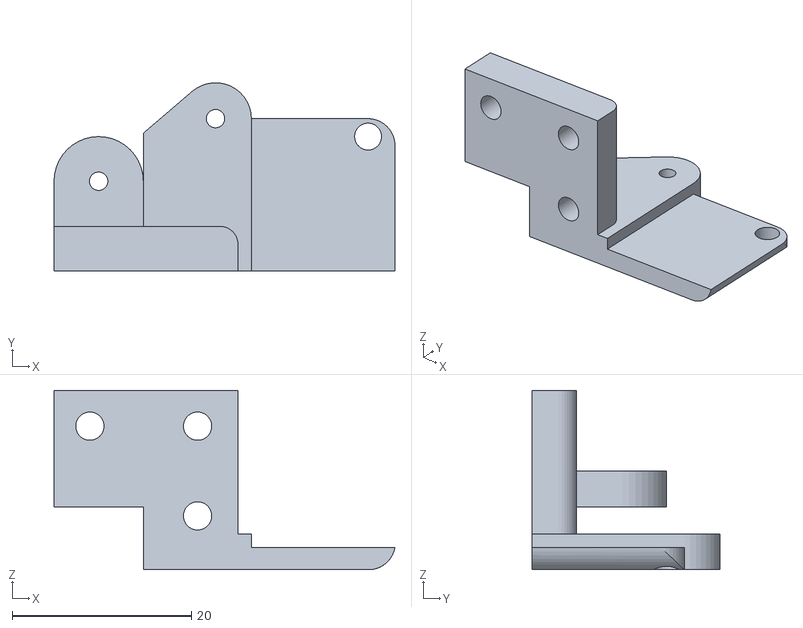
[picture p35: CAD file, 2024-02-03]
Project_2024/Peças .stl/Suporte chute alto esquerdo.STL
38.0 x 21.0 x 20.0
