roboime/SSL-Mec/Project_2024/Peças e Montagens/Suporte Chip Chute Alto Direito.SLDPRT

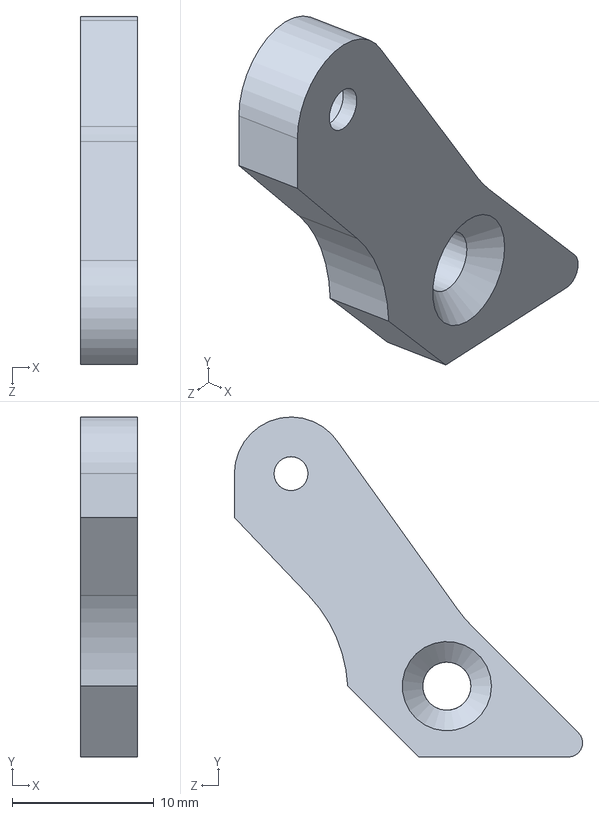
[picture p36: CAD file, 2024-02-03]
Project_2024/Peças e Montagens/Suporte Chip Chute Alto Direito.SLDPRT
4.00 x 24.0 x 24.6 mm
