roboime/SSL-Mec/Robo 2021/SSL/Diversos/Motor + Suporte + Caixa Redutora/Engrenagem do MotorC LARC.SLDPRT

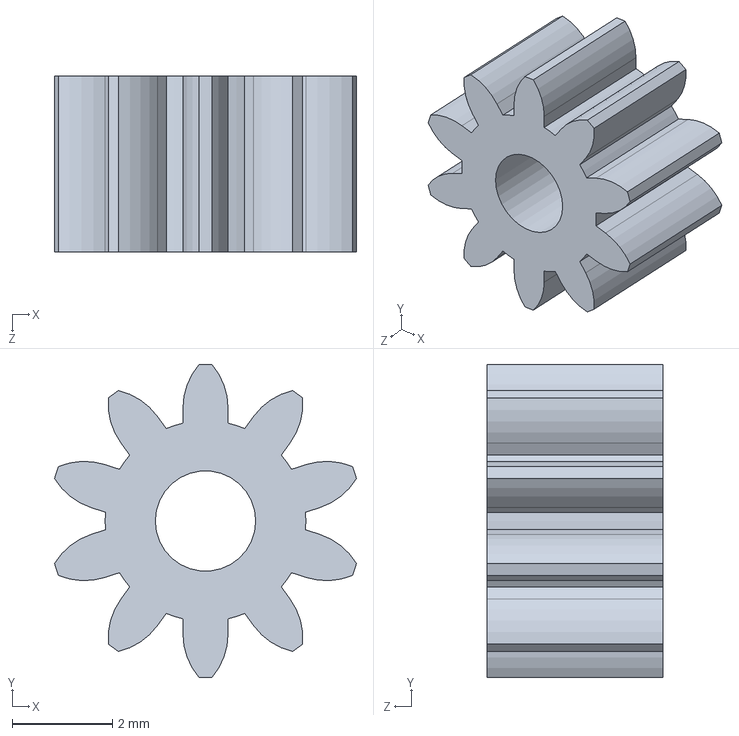
[picture p37: CAD file, 2021-10-04]
Robo 2021/SSL/Diversos/Motor + Suporte + Caixa Redutora/Engrenagem do MotorC LARC.SLDPRT
6.02 x 6.24 x 3.50 mm
