roboime/SSL-Mec/Robo 2021/SSL/Diversos/Sistema de chute Antigo/Espaçador Drible1.4mm.sldprt

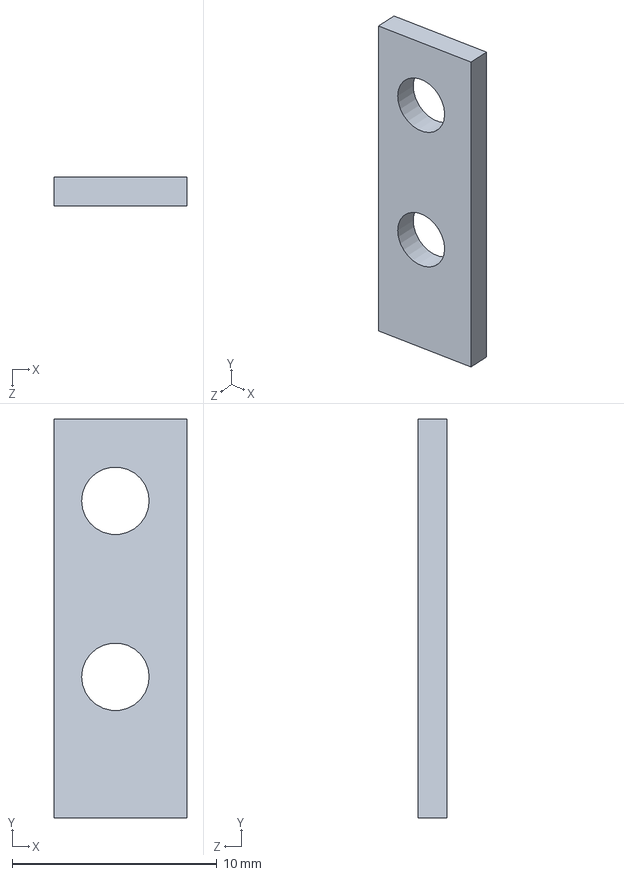
[picture p38: CAD file, 2021-10-04]
Robo 2021/SSL/Diversos/Sistema de chute Antigo/Espaçador Drible1.4mm.sldprt
6.50 x 19.5 x 1.40 mm
