roboime/SSL-Mec/Robo 2021/SSL/Robô/Carenagem/Frontal.SLDPRT

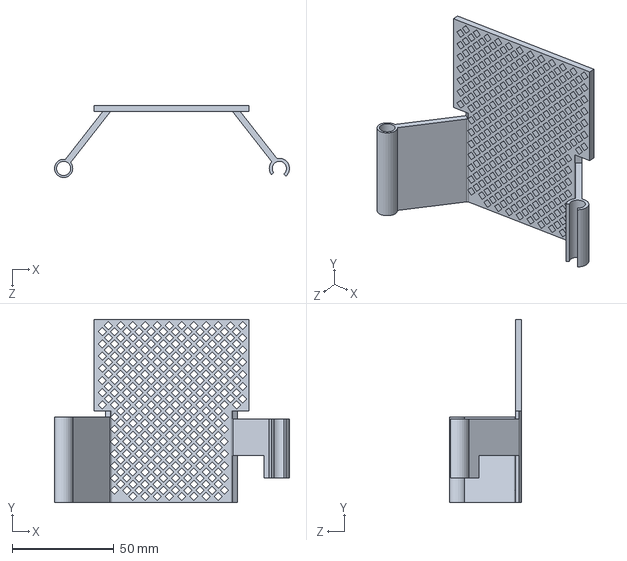
[picture p39: CAD file, 2021-10-04]
Robo 2021/SSL/Robô/Carenagem/Frontal.SLDPRT
115.5 x 90.0 x 35.5 mm
