roboime/SSL-Mec/Robo 2021/SSL/Robô/Conjunto Motriz/Conjunto Omni/Espaçador da Engrenagem.SLDPRT

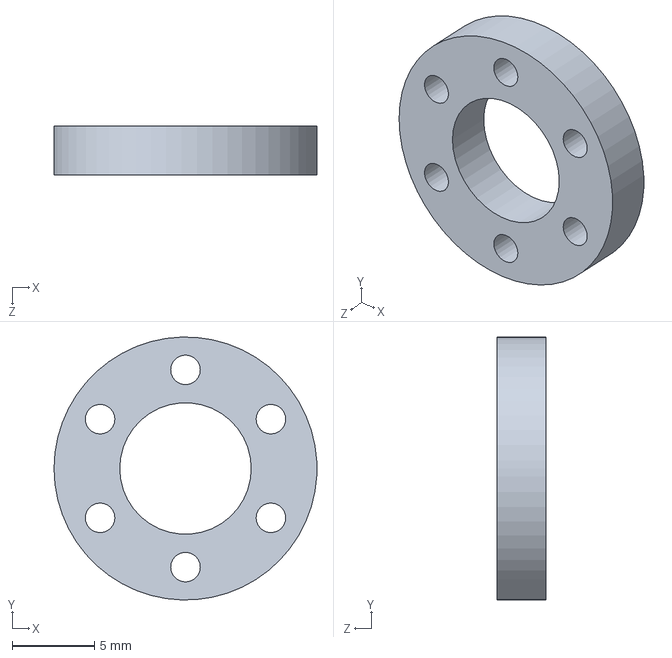
[picture p40: CAD file, 2021-10-04]
Robo 2021/SSL/Robô/Conjunto Motriz/Conjunto Omni/Espaçador da Engrenagem.SLDPRT
16.0 x 16.0 x 3.00 mm
