roboime/SSL-Mec/Robo 2021/SSL/Robô/Conjunto Motriz/Conjunto Omni/Rodilha Com O-Ring/Rodilha.SLDPRT

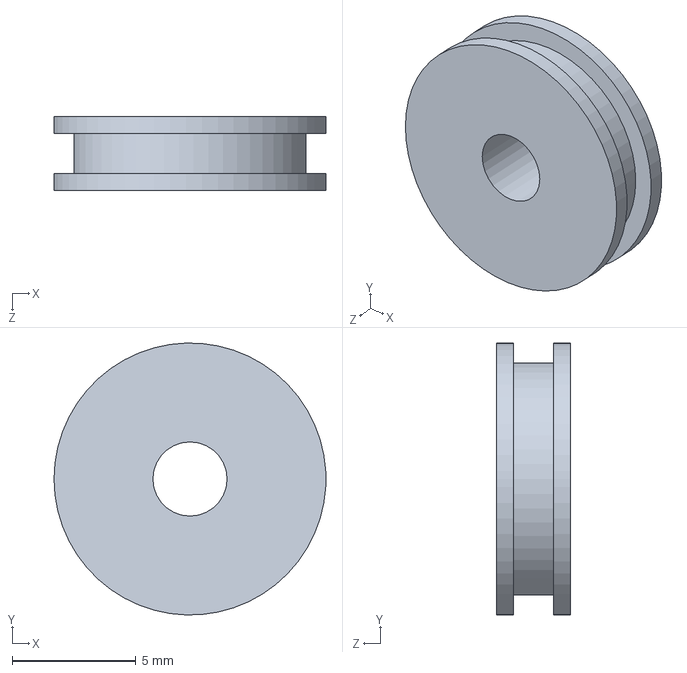
[picture p41: CAD file, 2021-10-04]
Robo 2021/SSL/Robô/Conjunto Motriz/Conjunto Omni/Rodilha Com O-Ring/Rodilha.SLDPRT
11.0 x 11.0 x 3.00 mm
