roboime/SSL-Mec/Robo 2021/SSL/Robô/Conjunto Motriz/Motor e Suporte/Motor/Tampa preta motor.SLDPRT

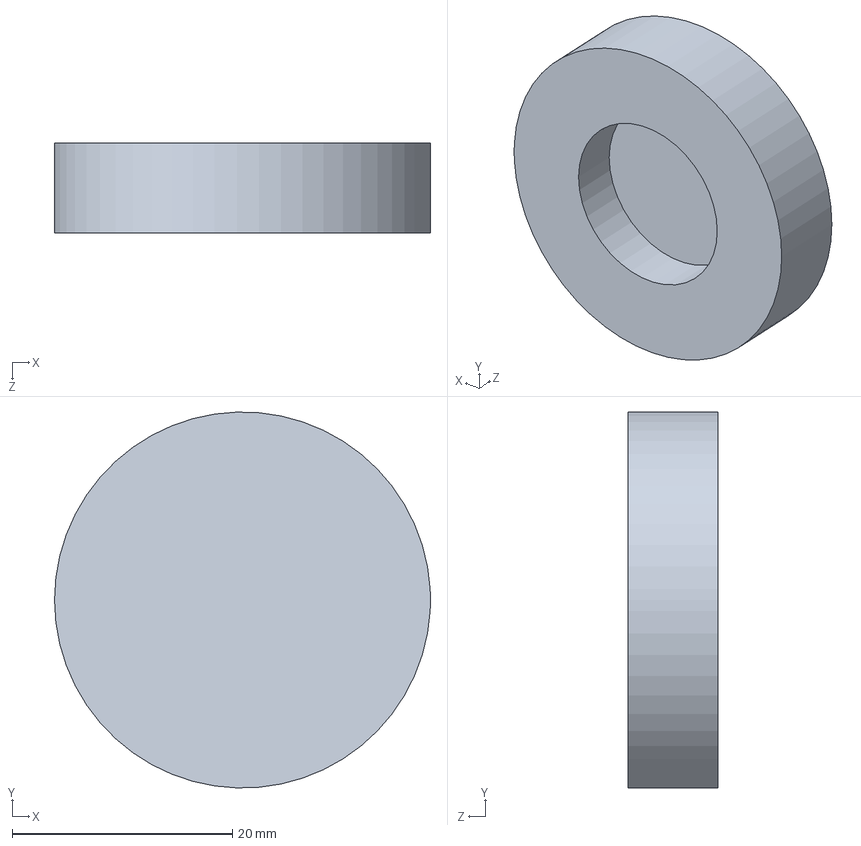
[picture p42: CAD file, 2021-10-04]
Robo 2021/SSL/Robô/Conjunto Motriz/Motor e Suporte/Motor/Tampa preta motor.SLDPRT
34.2 x 34.1 x 8.20 mm
