roboime/SSL-Mec/Robo 2021/SSL/Robô/Elétricos/Mockup Capacitor.SLDPRT

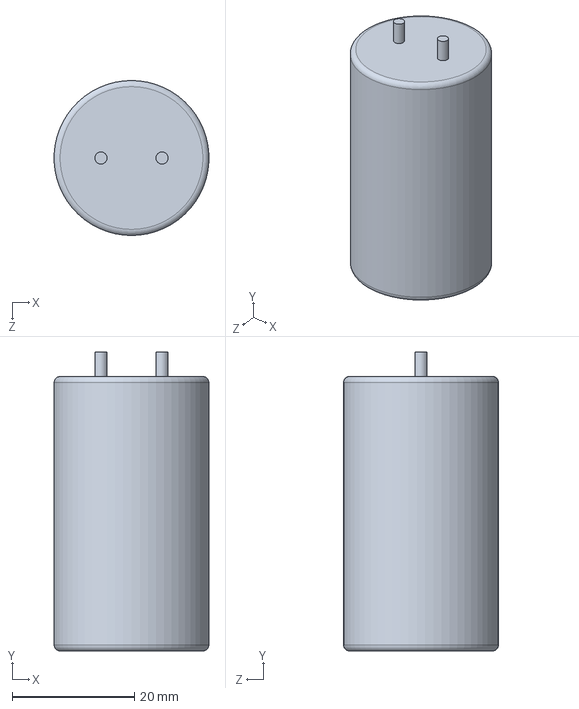
[picture p43: CAD file, 2021-10-04]
Robo 2021/SSL/Robô/Elétricos/Mockup Capacitor.SLDPRT
25.4 x 49.0 x 25.4 mm
