roboime/SSL-Mec/Robo 2021/SSL/Robô/Estrutura Fisica/2 Andar - Direito.SLDPRT

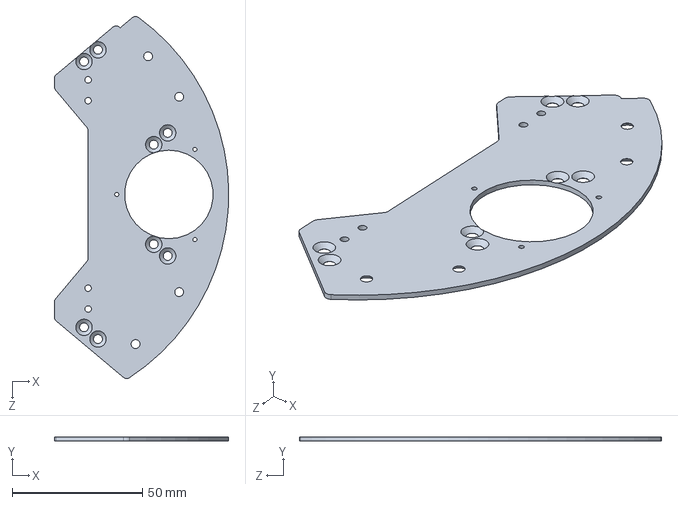
[picture p44: CAD file, 2021-10-12]
Robo 2021/SSL/Robô/Estrutura Fisica/2 Andar - Direito.SLDPRT
67.0 x 1.50 x 139.0 mm
