roboime/SSL-Mec/Robo 2021/SSL/Robô/Sistema de chute/Acionador Chute Alto 3.SLDPRT

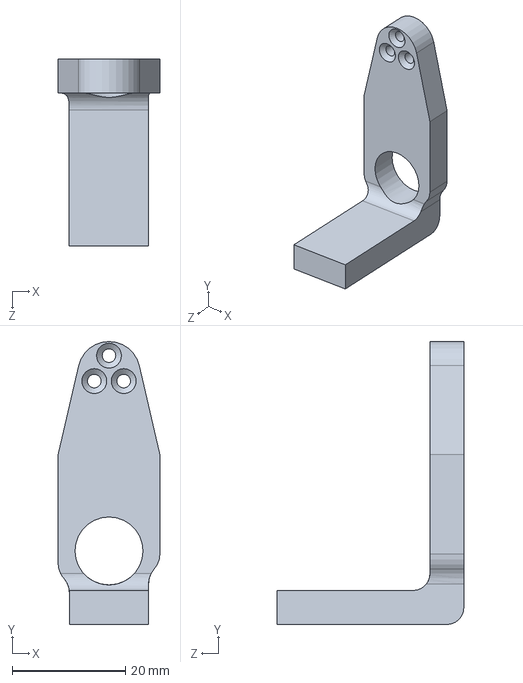
[picture p45: CAD file, 2021-10-12]
Robo 2021/SSL/Robô/Sistema de chute/Acionador Chute Alto 3.SLDPRT
18.0 x 50.0 x 33.0 mm
