roboime/SSL-Mec/Robo 2021/SSL/Robô/Sistema de chute/Driblador/Eixo Driblador.SLDPRT

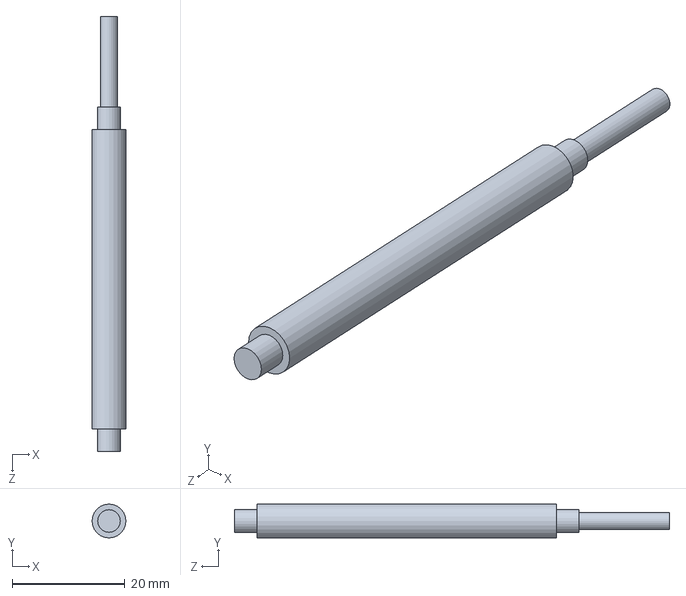
[picture p46: CAD file, 2021-10-12]
Robo 2021/SSL/Robô/Sistema de chute/Driblador/Eixo Driblador.SLDPRT
6.00 x 6.00 x 77.0 mm
