roboime/SSL-Mec/Robo 2021/SSL/Toolbox/Metric - Spur gear 0.5M 10T 20PA 3,5FW.SLDPRT

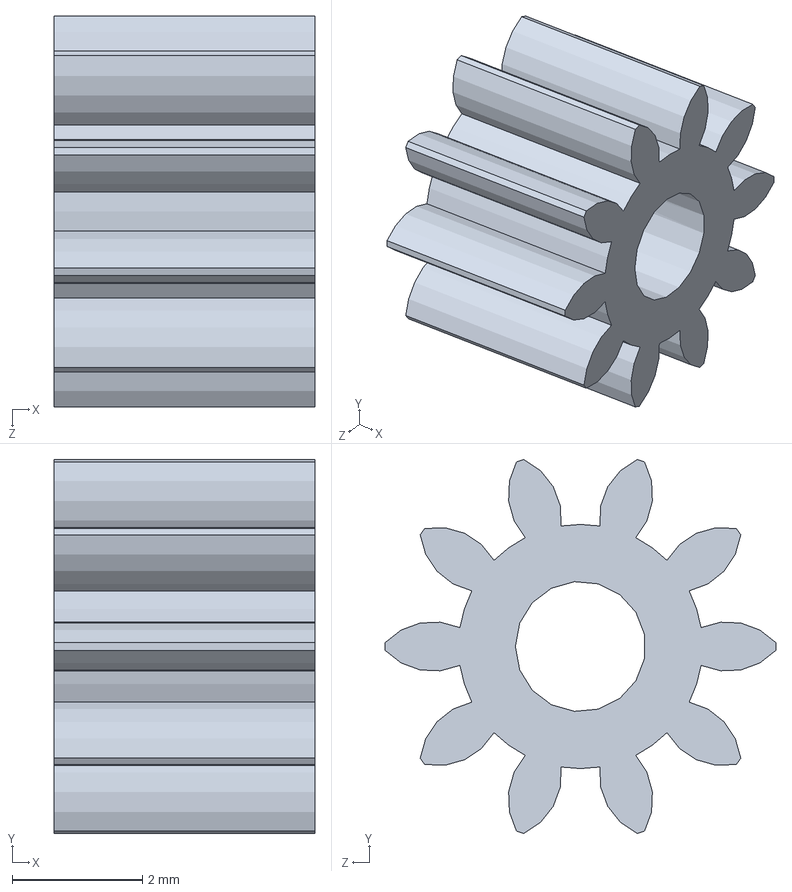
[picture p47: CAD file, 2021-10-12]
Robo 2021/SSL/Toolbox/Metric - Spur gear 0.5M 10T 20PA 3,5FW.SLDPRT
4.00 x 5.74 x 6.00 mm
