roboime/SSL-Mec/Project_2024/Arquivos .STEP para Usinagem/Transmissor de torque da roda.SLDPRT

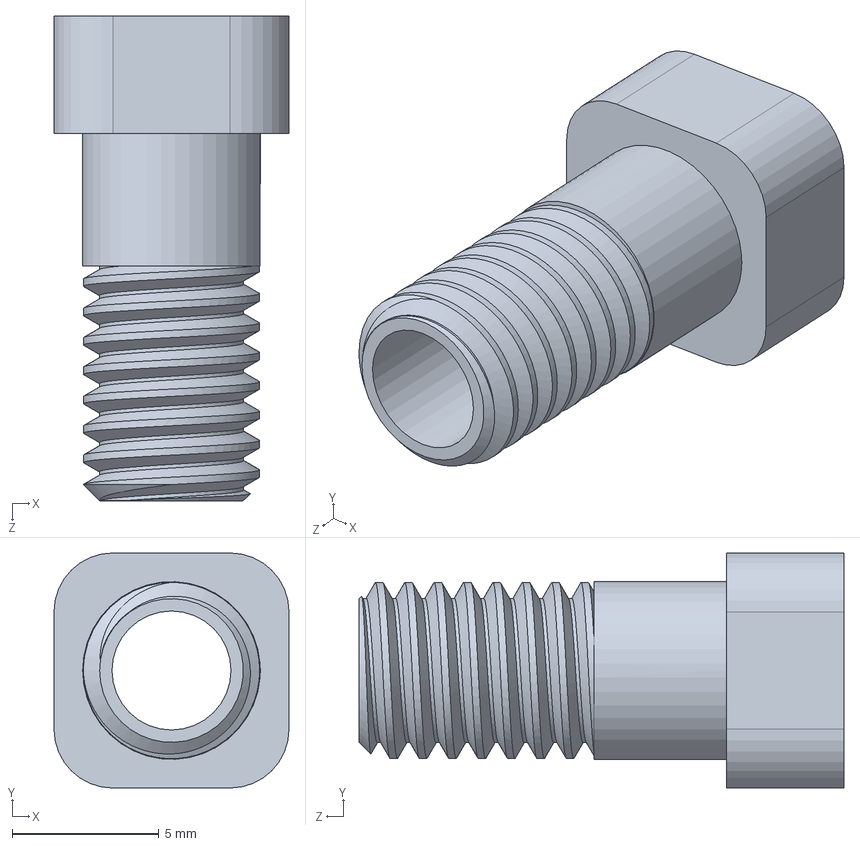
[picture p48: CAD file, 2024-02-03]
Project_2024/Arquivos .STEP para Usinagem/Transmissor de torque da roda.SLDPRT
8.00 x 8.00 x 16.5 mm
