roboime/SSL-Mec/Project_2024/Peças .stl/Carretel chute rasteiro.STL

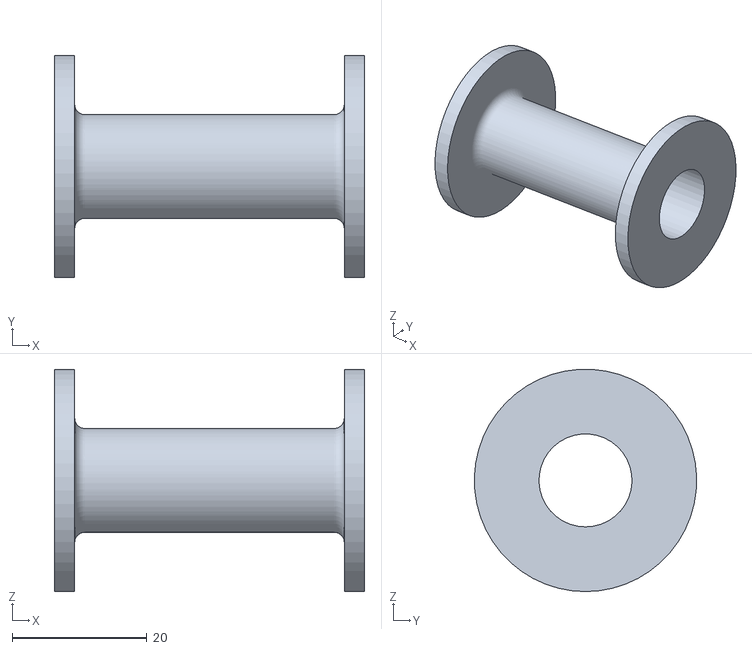
[picture p49: CAD file, 2024-02-03]
Project_2024/Peças .stl/Carretel chute rasteiro.STL
46.0 x 33.0 x 33.0
