roboime/SSL-Mec/Project_2024/Peças e Montagens/Suporte Chip Chute Alto Esquerdo.SLDPRT

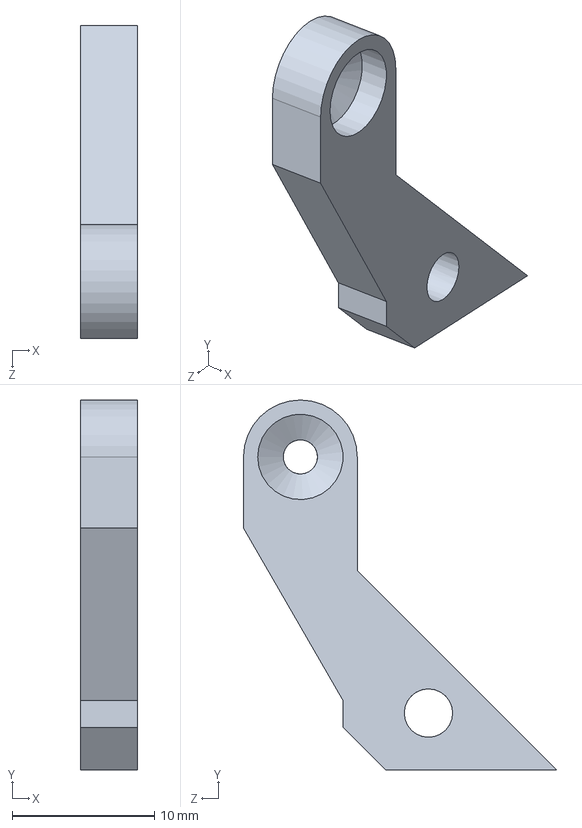
[picture p50: CAD file, 2024-02-03]
Project_2024/Peças e Montagens/Suporte Chip Chute Alto Esquerdo.SLDPRT
4.00 x 26.0 x 22.0 mm
