roboime/SSL-Mec/Project_2024/Sistema de chute/Driblador/Apoio engrenagem.SLDPRT

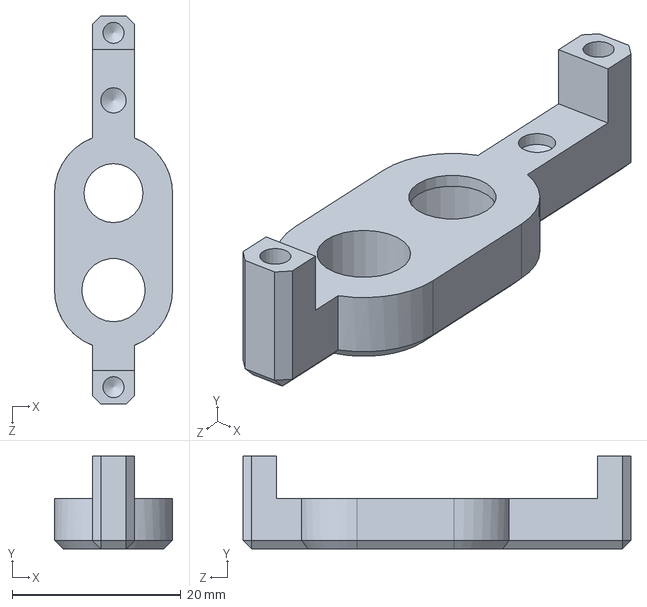
[picture p51: CAD file, 2024-02-03]
Project_2024/Sistema de chute/Driblador/Apoio engrenagem.SLDPRT
14.0 x 11.0 x 46.0 mm
