roboime/SSL-Mec/Robo 2021/SSL/Robô/Carenagem/Teste de  taamanho.SLDPRT

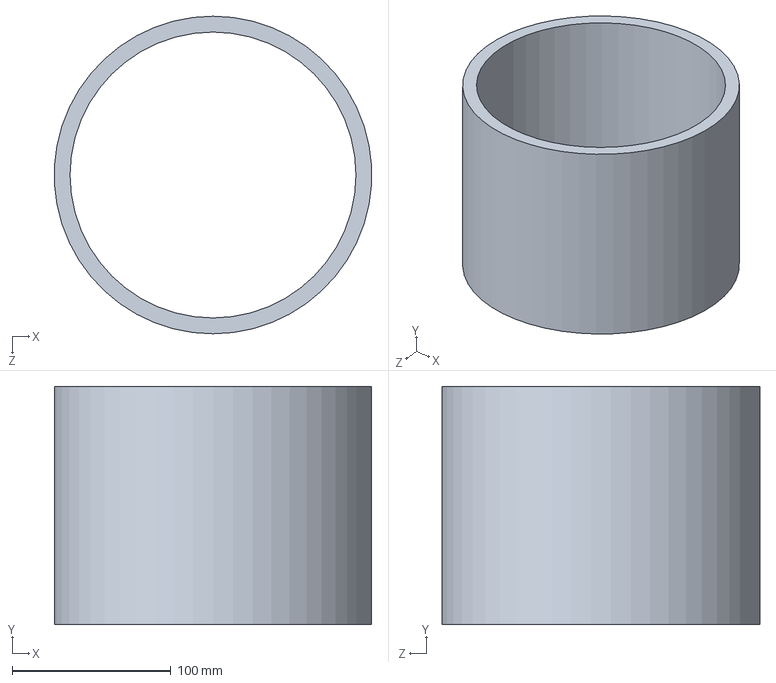
[picture p52: CAD file, 2021-10-04]
Robo 2021/SSL/Robô/Carenagem/Teste de taamanho.SLDPRT
199.6 x 150.0 x 200.0 mm
