roboime/SSL-Mec/Robo 2021/SSL/Robô/Conjunto Motriz/Conjunto Omni/45 mm/Corpo Externo.SLDPRT

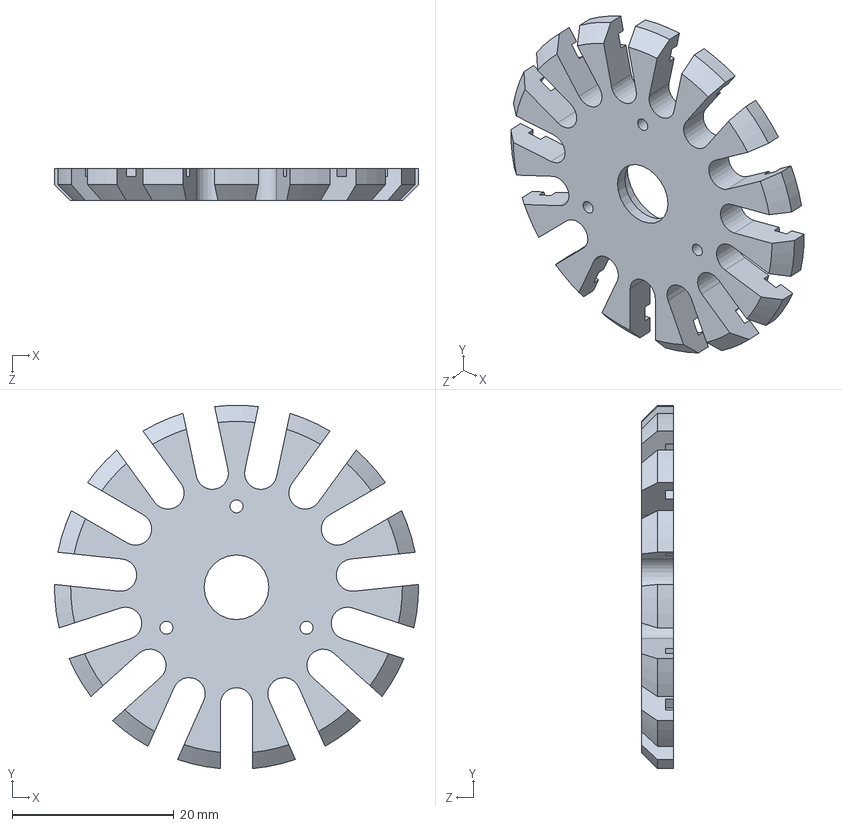
[picture p53: CAD file, 2021-10-12]
Robo 2021/SSL/Robô/Conjunto Motriz/Conjunto Omni/45 mm/Corpo Externo.SLDPRT
45.0 x 44.9 x 4.00 mm
