roboime/SSL-Mec/Robo 2021/SSL/Robô/Conjunto Motriz/Conjunto Omni/Rep Rolamento 4x9x4mm .SLDPRT

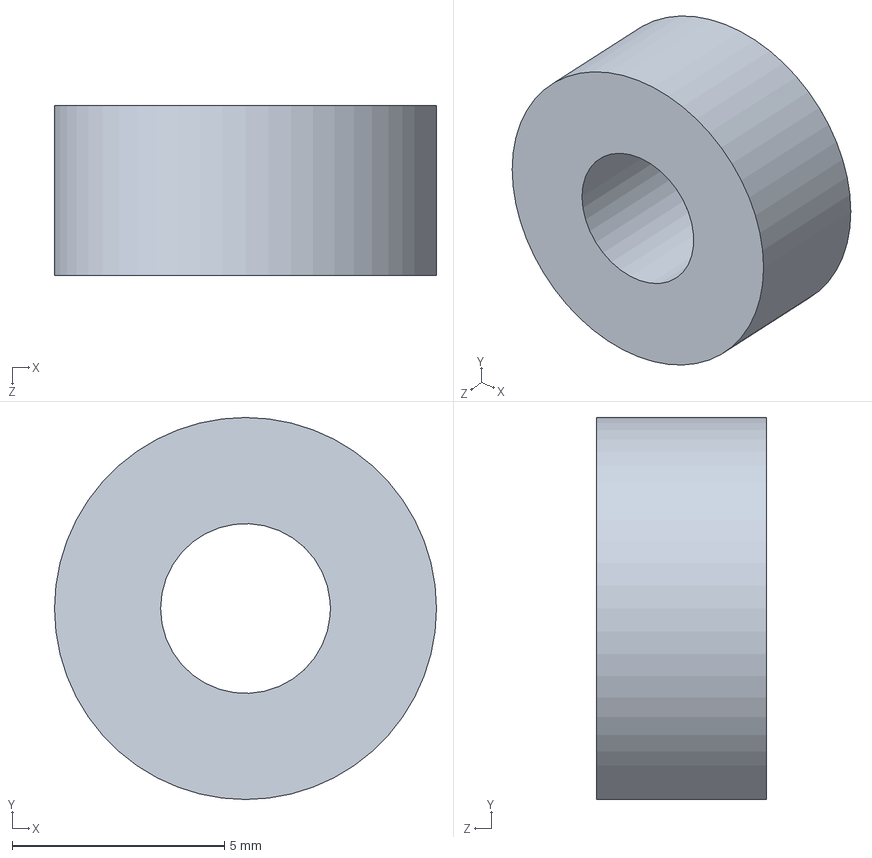
[picture p54: CAD file, 2021-10-04]
Robo 2021/SSL/Robô/Conjunto Motriz/Conjunto Omni/Rep Rolamento 4x9x4mm .SLDPRT
9.00 x 9.00 x 4.00 mm
