roboime/SSL-Mec/Robo 2021/SSL/Robô/Conjunto Motriz/Conjunto Omni/Rodilha Com O-Ring/O-Ring 10x7x1,5 mm.SLDPRT

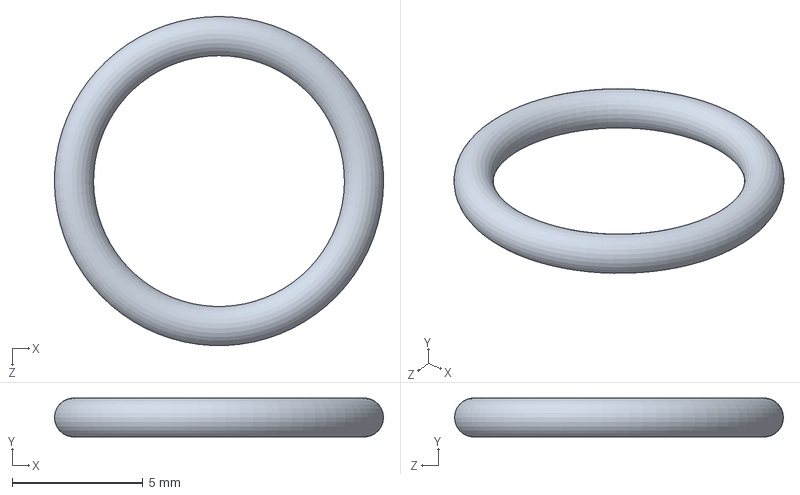
[picture p55: CAD file, 2021-10-04]
Robo 2021/SSL/Robô/Conjunto Motriz/Conjunto Omni/Rodilha Com O-Ring/O-Ring 10x7x1,5 mm.SLDPRT
12.6 x 1.49 x 12.6 mm
