roboime/SSL-Mec/Robo 2021/SSL/Robô/Conjunto Motriz/Motor e Suporte/Motor/motor.SLDPRT

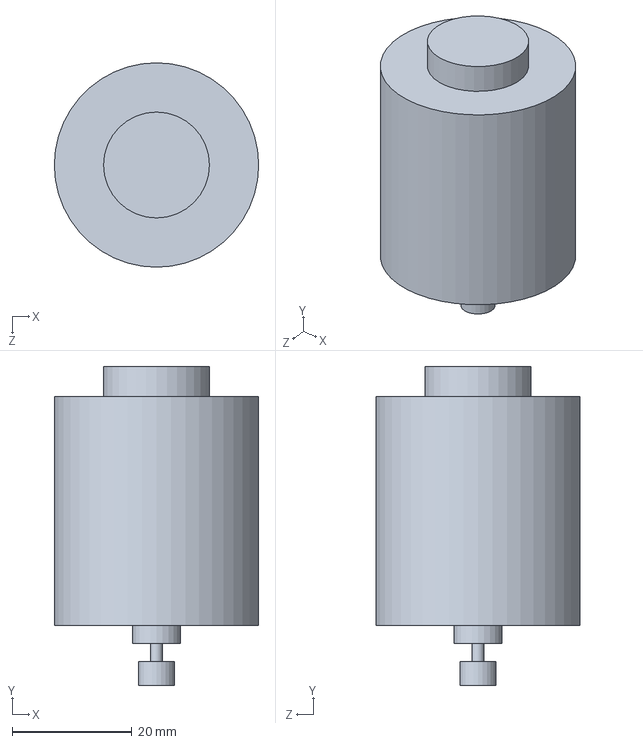
[picture p56: CAD file, 2021-10-04]
Robo 2021/SSL/Robô/Conjunto Motriz/Motor e Suporte/Motor/motor.SLDPRT
34.2 x 53.3 x 34.2 mm
