roboime/SSL-Mec/Robo 2021/SSL/Robô/Elétricos/Bateria.SLDPRT

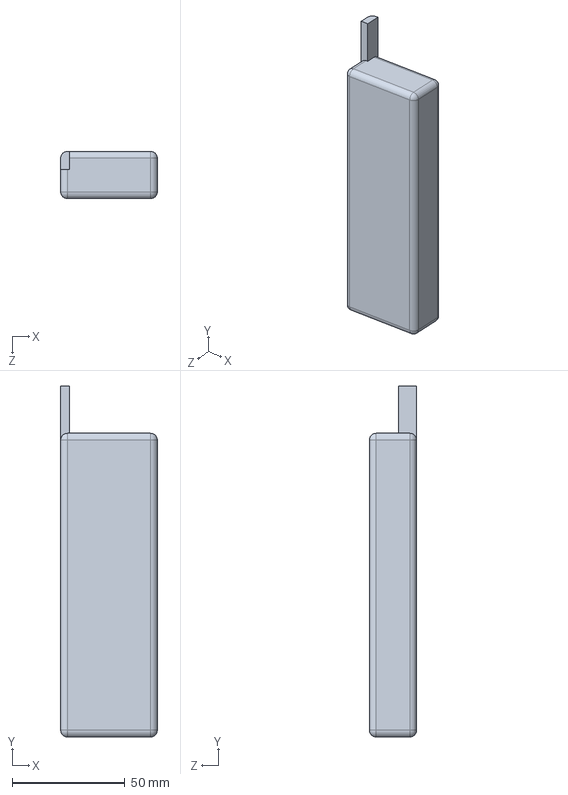
[picture p57: CAD file, 2021-10-04]
Robo 2021/SSL/Robô/Elétricos/Bateria.SLDPRT
43.0 x 156.0 x 21.0 mm
