roboime/SSL-Mec/Robo 2021/SSL/Robô/Piso.SLDPRT

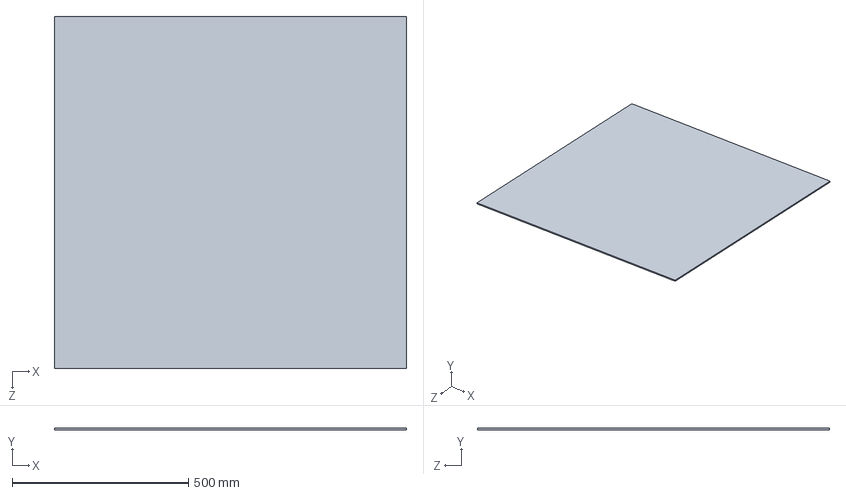
[picture p58: CAD file, 2021-10-04]
Robo 2021/SSL/Robô/Piso.SLDPRT
1000.0 x 5.00 x 1000.0 mm
