roboime/SSL-Mec/Robo 2021/SSL/Robô/Sistema de chute/Driblador/Metric - Spur gear 0.5M 36T 20PA.SLDPRT

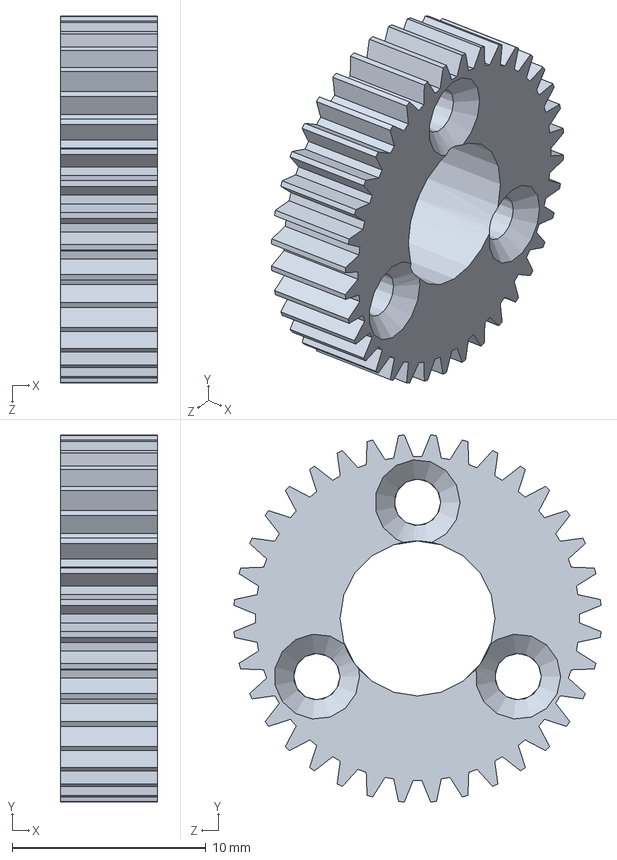
[picture p59: CAD file, 2021-10-12]
Robo 2021/SSL/Robô/Sistema de chute/Driblador/Metric - Spur gear 0.5M 36T 20PA.SLDPRT
5.00 x 19.0 x 19.0 mm
