roboime/SSL-Mec/Robo 2021/SSL/Robô/Suportes da ELO/O-Ring 8x1,5 mm.SLDPRT

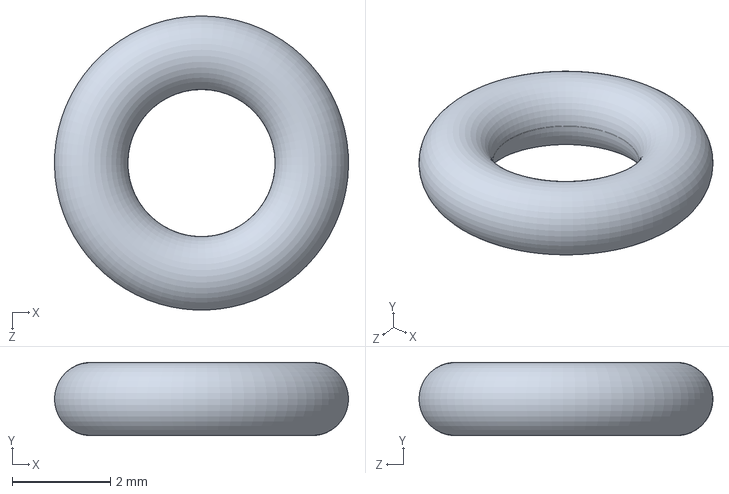
[picture p60: CAD file, 2021-10-04]
Robo 2021/SSL/Robô/Suportes da ELO/O-Ring 8x1,5 mm.SLDPRT
6.00 x 1.49 x 6.00 mm
