roboime/SSL-Mec/Robo 2021/SSL/Toolbox/Metric - Spur gear 0.5M 10T 20PA 12FW.SLDPRT

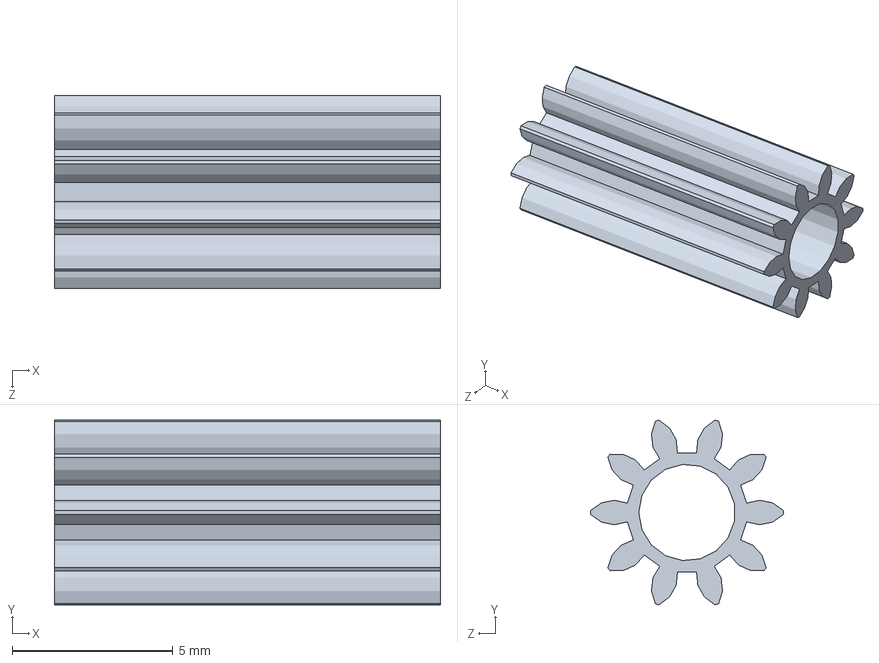
[picture p61: CAD file, 2021-10-12]
Robo 2021/SSL/Toolbox/Metric - Spur gear 0.5M 10T 20PA 12FW.SLDPRT
12.0 x 5.74 x 6.00 mm
