roboime/SSL-Mec/Project_2024/Arquivos .STEP para Usinagem/Base 2.SLDPRT

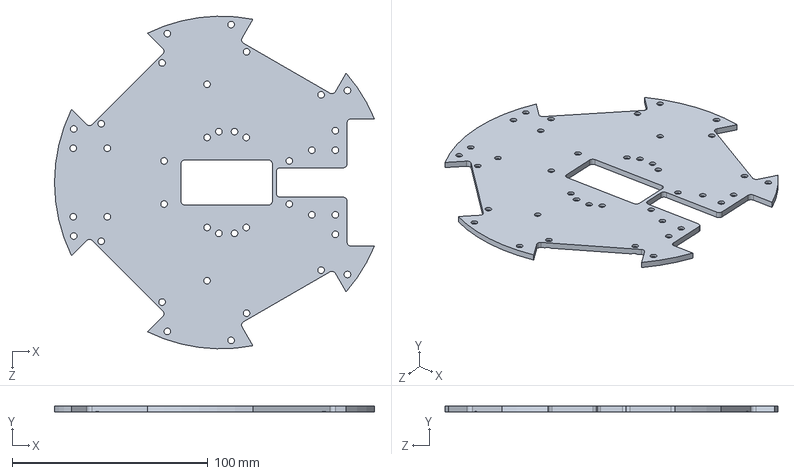
[picture p62: CAD file, 2024-02-03]
Project_2024/Arquivos .STEP para Usinagem/Base 2.SLDPRT
163.5 x 3.00 x 170.0 mm
