roboime/SSL-Mec/Project_2024/Peças .stl/Suporte capacitor.STL

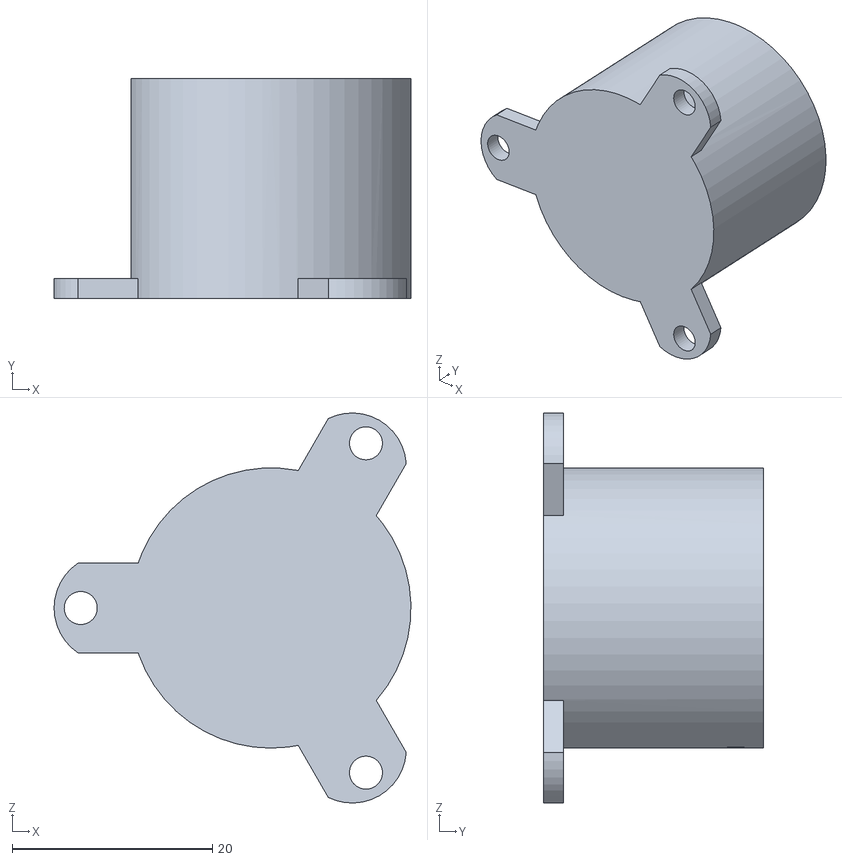
[picture p63: CAD file, 2024-02-03]
Project_2024/Peças .stl/Suporte capacitor.STL
35.7 x 22.0 x 39.0
