roboime/SSL-Mec/Project_2024/Peças e Montagens/Eixo da rodilha.SLDPRT

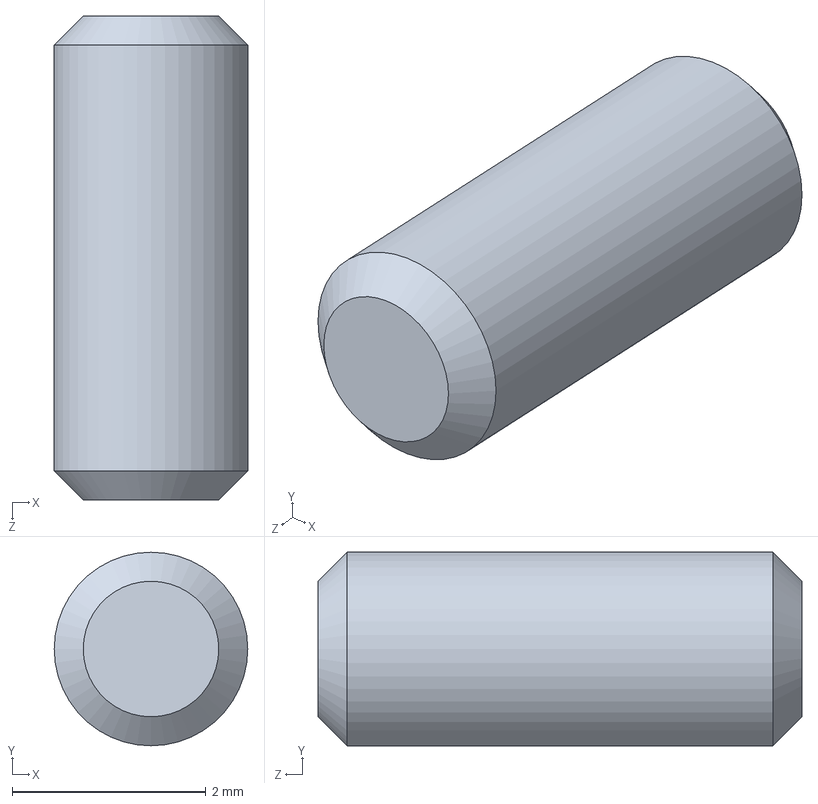
[picture p64: CAD file, 2024-02-03]
Project_2024/Peças e Montagens/Eixo da rodilha.SLDPRT
2.00 x 2.00 x 5.00 mm
