roboime/SSL-Mec/Project_2024/Sistema de chute/Driblador/Metric - Spur gear 0.4M 12T 20PA 2.5FW ---S12N75H50L2N.SLDPRT

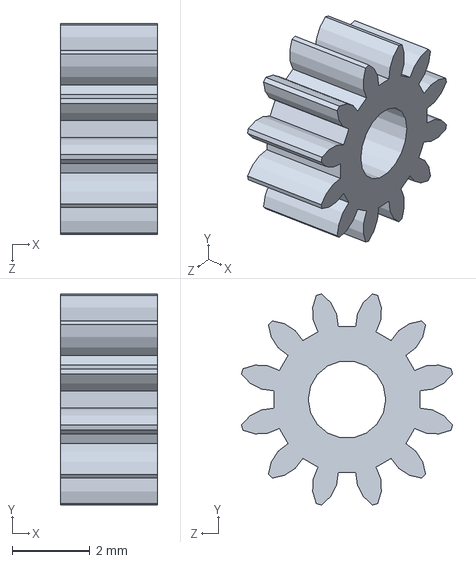
[picture p65: CAD file, 2024-02-03]
Project_2024/Sistema de chute/Driblador/Metric - Spur gear 0.4M 12T 20PA 2.5FW ---S12N75H50L2N.SLDPRT
2.50 x 5.44 x 5.44 mm
