roboime/SSL-Mec/Project_2024/Sistema de chute/Suporte direito driblador.SLDPRT

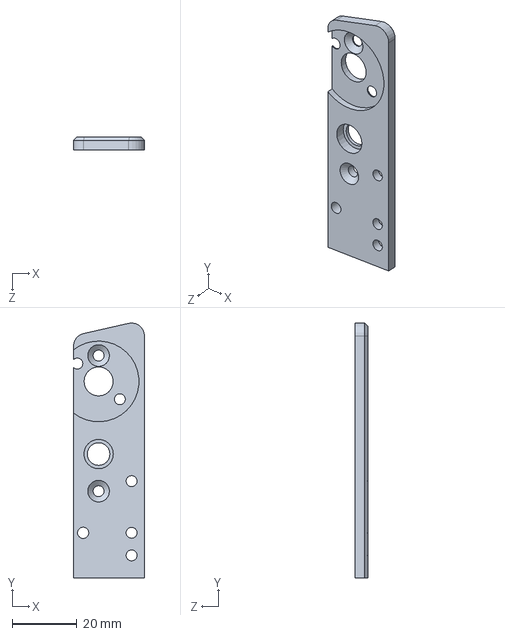
[picture p66: CAD file, 2024-02-03]
Project_2024/Sistema de chute/Suporte direito driblador.SLDPRT
22.0 x 79.0 x 4.00 mm
