roboime/SSL-Mec/Robo 2021/SSL/Diversos/Assoalho.SLDPRT

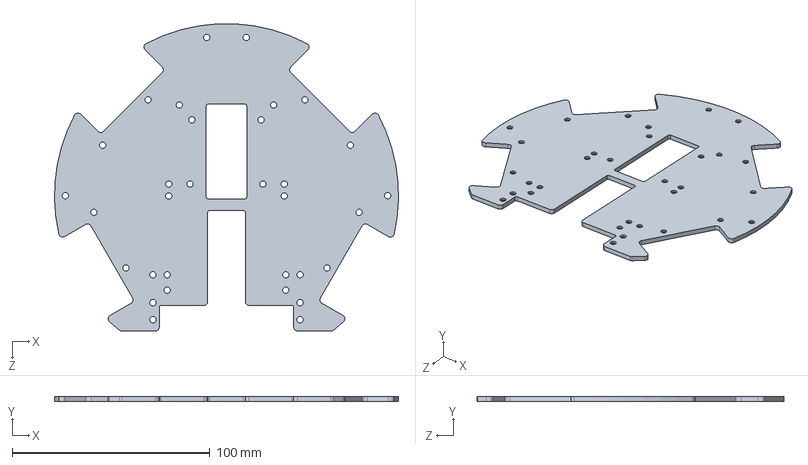
[picture p67: CAD file, 2021-10-04]
Robo 2021/SSL/Diversos/Assoalho.SLDPRT
174.0 x 2.50 x 155.4 mm
