roboime/SSL-Mec/Robo 2021/SSL/Diversos/Motor + Suporte + Caixa Redutora/Eixo.SLDPRT

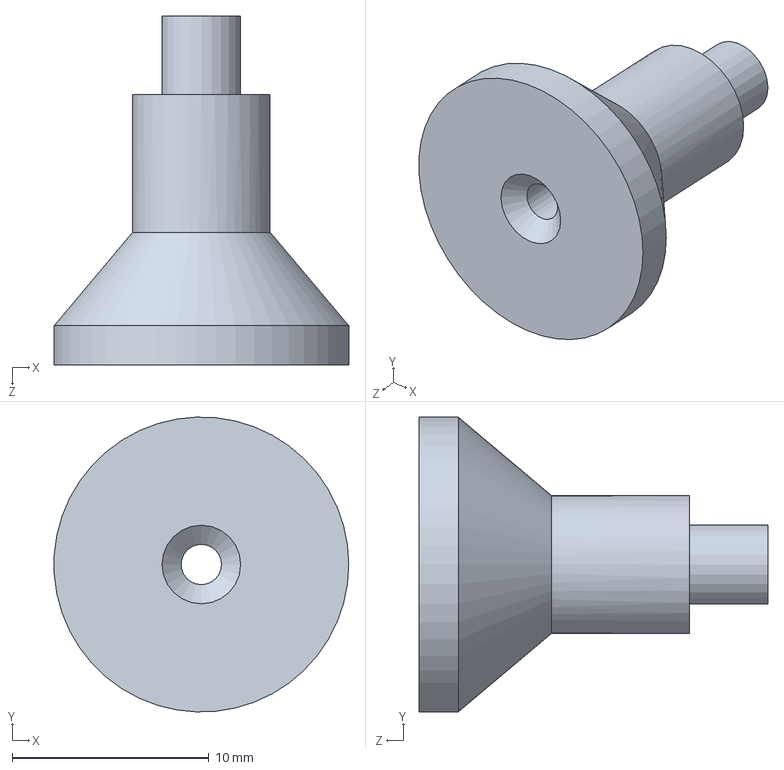
[picture p68: CAD file, 2021-10-04]
Robo 2021/SSL/Diversos/Motor + Suporte + Caixa Redutora/Eixo.SLDPRT
15.0 x 15.0 x 17.8 mm
