roboime/SSL-Mec/Robo 2021/SSL/Diversos/Sistema de chute Antigo/Solenoide11mm.STL

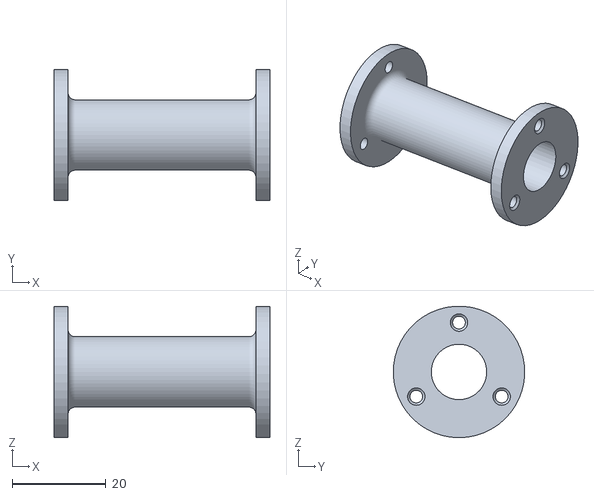
[picture p69: CAD file, 2021-10-04]
Robo 2021/SSL/Diversos/Sistema de chute Antigo/Solenoide11mm.STL
46.0 x 28.0 x 28.0
