roboime/SSL-Mec/Robo 2021/SSL/Robô/Carenagem/Carenagem.SLDPRT

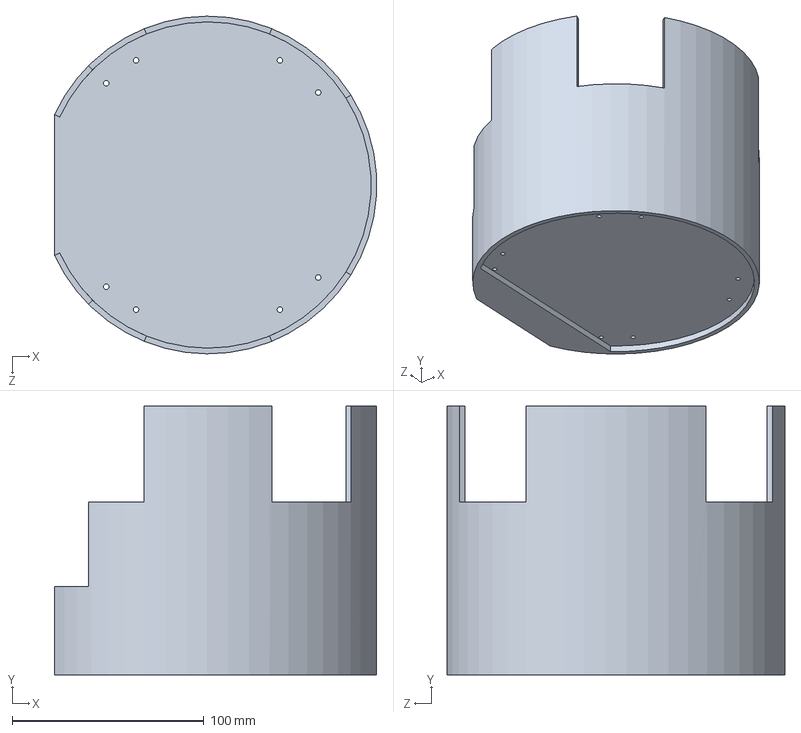
[picture p70: CAD file, 2021-10-04]
Robo 2021/SSL/Robô/Carenagem/Carenagem.SLDPRT
167.8 x 140.0 x 176.0 mm
