roboime/SSL-Mec/Robo 2021/SSL/Robô/Conjunto Motriz/Motor e Suporte/Suporte da roda.SLDPRT

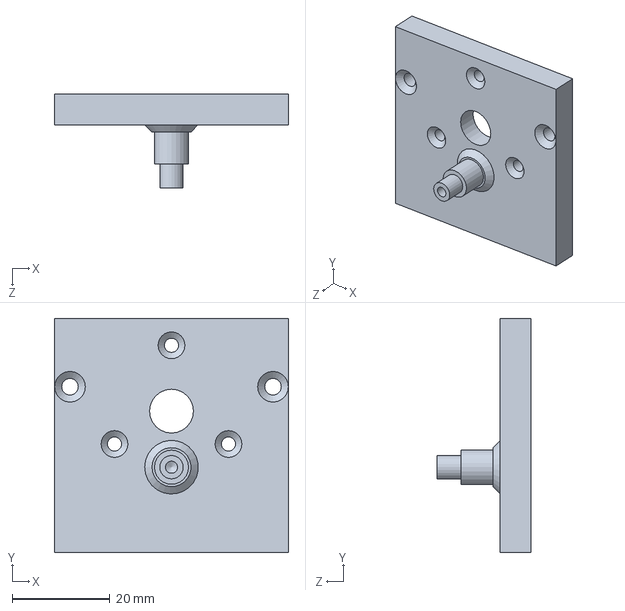
[picture p71: CAD file, 2021-10-12]
Robo 2021/SSL/Robô/Conjunto Motriz/Motor e Suporte/Suporte da roda.SLDPRT
48.0 x 48.0 x 19.4 mm
