roboime/SSL-Mec/Robo 2021/SSL/Robô/Elétricos/OLED 128x64.STP

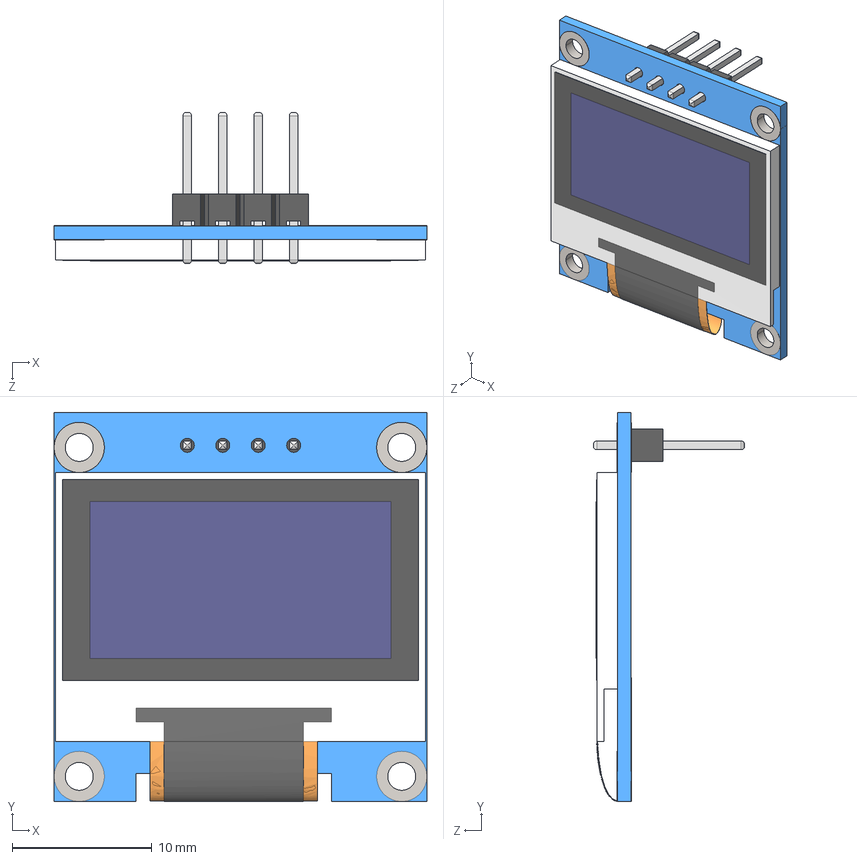
[picture p72: CAD file, 2021-10-04]
Robo 2021/SSL/Robô/Elétricos/OLED 128x64.STP
26.7 x 27.9 x 10.8 mm
