roboime/SSL-Mec/Robo 2021/SSL/Robô/Estrutura Fisica/Suporte Estrutura Aluminio.SLDPRT

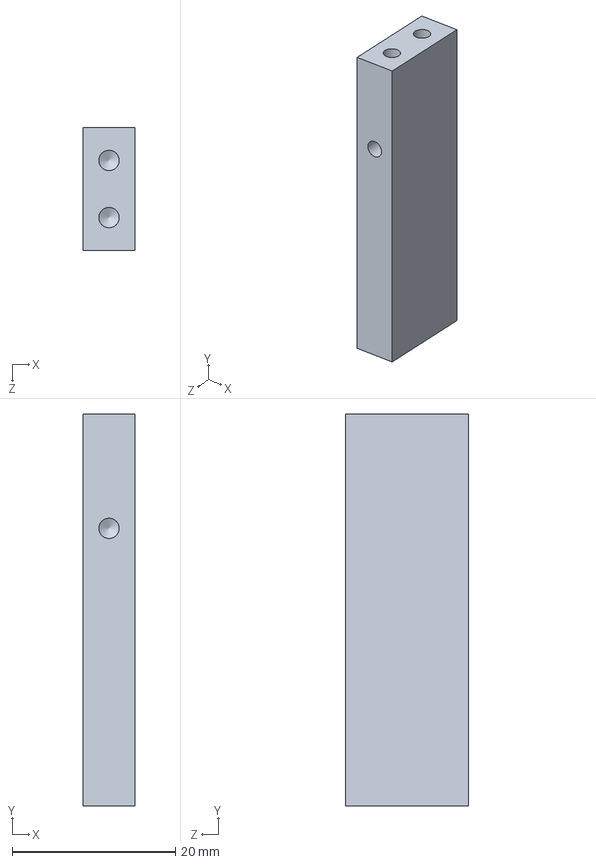
[picture p73: CAD file, 2021-10-04]
Robo 2021/SSL/Robô/Estrutura Fisica/Suporte Estrutura Aluminio.SLDPRT
6.35 x 48.0 x 15.0 mm
