roboime/SSL-Mec/Robo 2021/SSL/Robô/Sistema de chute/Chute rasteiro novo.SLDPRT

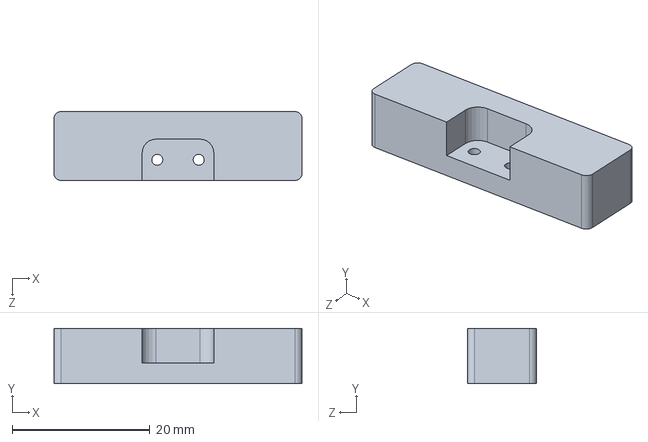
[picture p74: CAD file, 2021-10-11]
Robo 2021/SSL/Robô/Sistema de chute/Chute rasteiro novo.SLDPRT
36.0 x 8.00 x 10.0 mm
