roboime/SSL-Mec/Robo 2021/SSL/Robô/Suportes da ELO/Suporte do Capacitor.SLDPRT

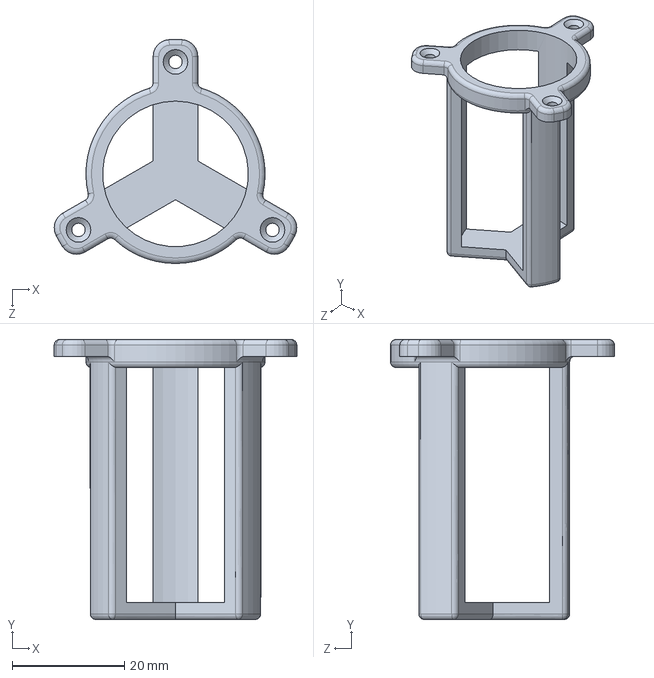
[picture p75: CAD file, 2021-10-04]
Robo 2021/SSL/Robô/Suportes da ELO/Suporte do Capacitor.SLDPRT
43.3 x 50.0 x 40.0 mm
