roboime/SSL-Mec/Robo 2021/SSL/Toolbox/Metric - Spur gear 0.5M 36T 20PA.SLDPRT

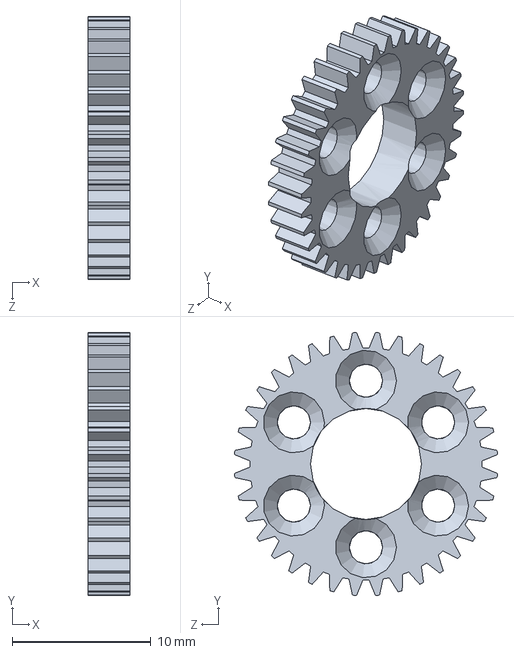
[picture p76: CAD file, 2021-10-12]
Robo 2021/SSL/Toolbox/Metric - Spur gear 0.5M 36T 20PA.SLDPRT
3.00 x 19.0 x 19.0 mm
