roboime/SSL-Mec/Project_2024/Arquivos .STEP para Usinagem/Intermediario do acionador rasteiro.SLDPRT

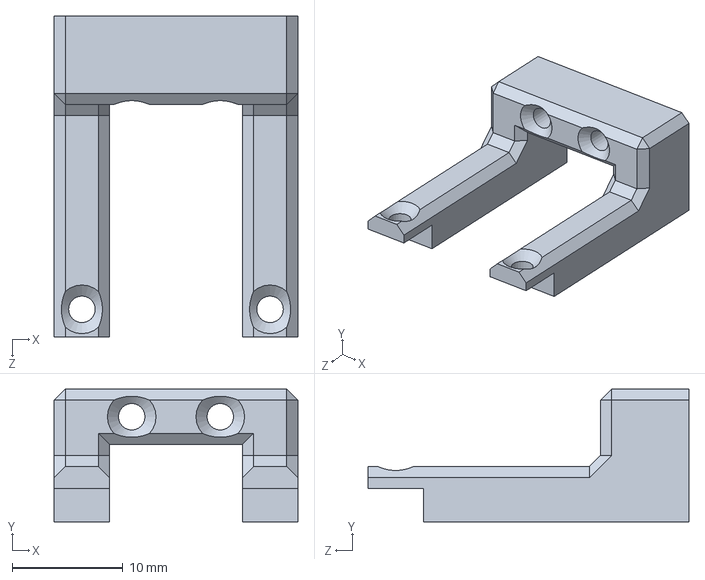
[picture p77: CAD file, 2024-02-03]
Project_2024/Arquivos .STEP para Usinagem/Intermediario do acionador rasteiro.SLDPRT
22.0 x 12.0 x 29.0 mm
