roboime/SSL-Mec/Project_2024/Peças .stl/Pistão chute rasteiro.STL

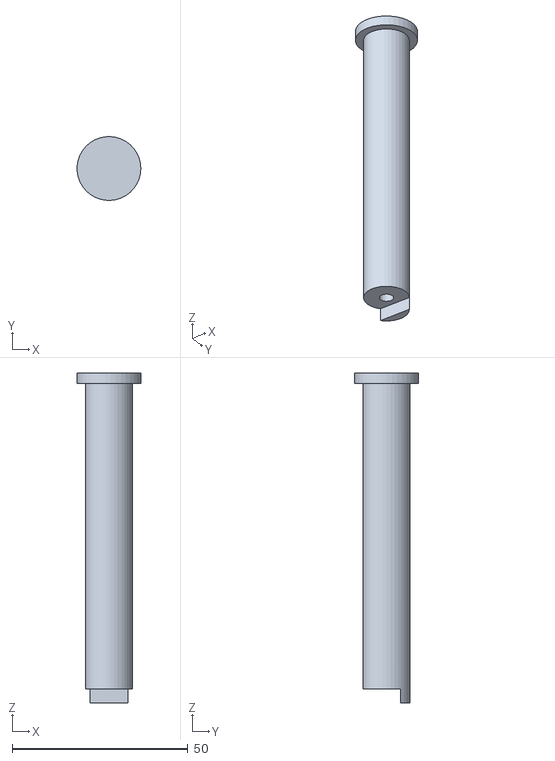
[picture p78: CAD file, 2024-02-03]
Project_2024/Peças .stl/Pistão chute rasteiro.STL
18.2 x 18.2 x 94.0
