roboime/SSL-Mec/Project_2024/Peças e Montagens/Suporte capacitor.SLDPRT

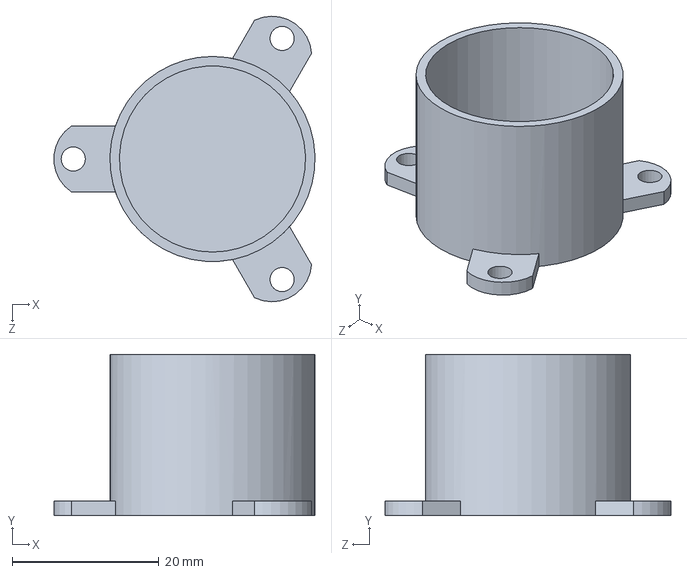
[picture p79: CAD file, 2024-02-03]
Project_2024/Peças e Montagens/Suporte capacitor.SLDPRT
35.6 x 22.0 x 39.0 mm
