roboime/SSL-Mec/Project_2024/Sistema de chute/Driblador/Eixo engrenagem do drible.SLDPRT

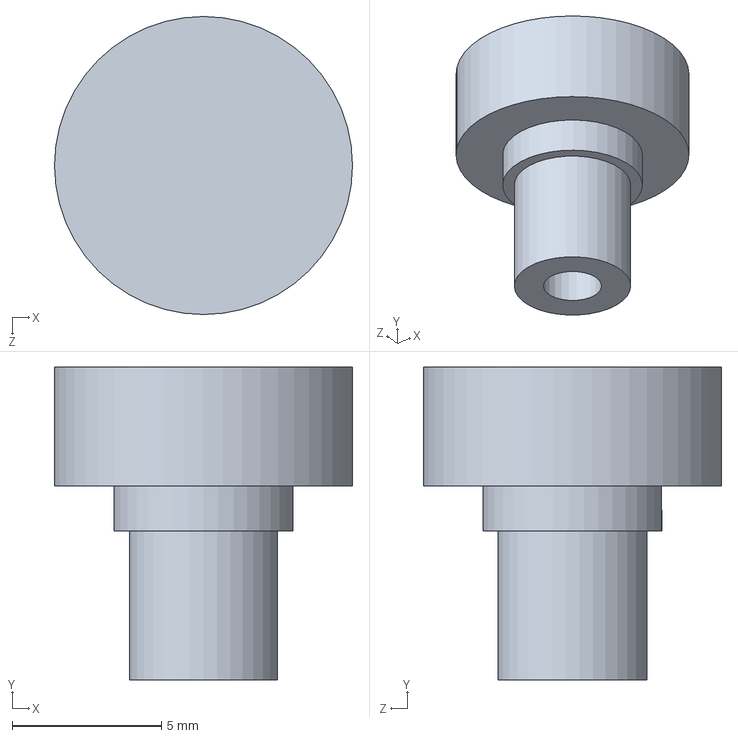
[picture p80: CAD file, 2024-02-03]
Project_2024/Sistema de chute/Driblador/Eixo engrenagem do drible.SLDPRT
10.0 x 10.5 x 10.0 mm
