roboime/SSL-Mec/Robo 2021/SSL/Diversos/Motor + Suporte + Caixa Redutora/Hsiang Neng Motor LARC.SLDPRT

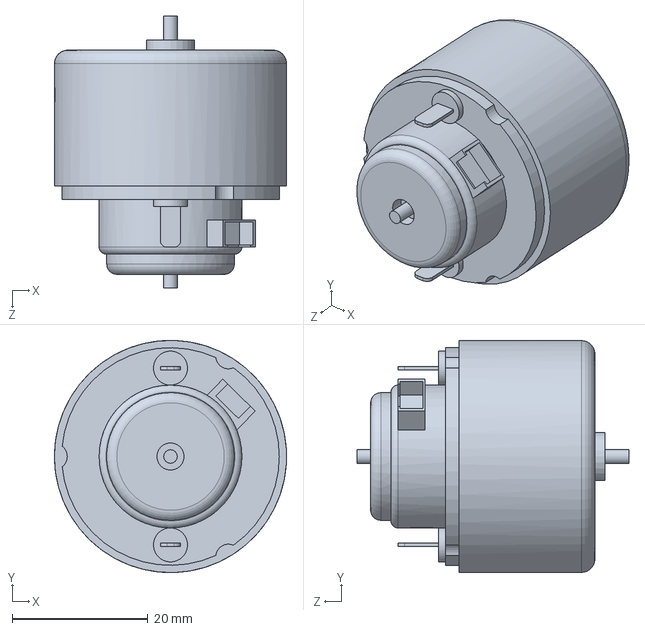
[picture p81: CAD file, 2021-10-04]
Robo 2021/SSL/Diversos/Motor + Suporte + Caixa Redutora/Hsiang Neng Motor LARC.SLDPRT
34.2 x 34.1 x 40.0 mm
