roboime/SSL-Mec/Robo 2021/SSL/Diversos/Sistema de chute Antigo/Mola Conica.SLDPRT

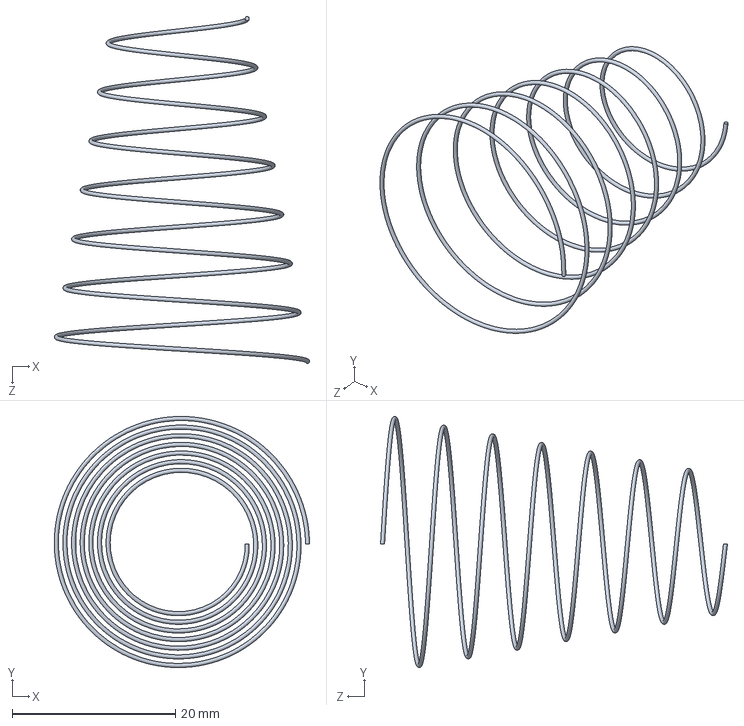
[picture p82: CAD file, 2021-10-04]
Robo 2021/SSL/Diversos/Sistema de chute Antigo/Mola Conica.SLDPRT
31.3 x 30.8 x 42.5 mm
