roboime/SSL-Mec/Robo 2021/SSL/Robô/Conjunto Motriz/Conjunto Omni/Aro omni.SLDPRT

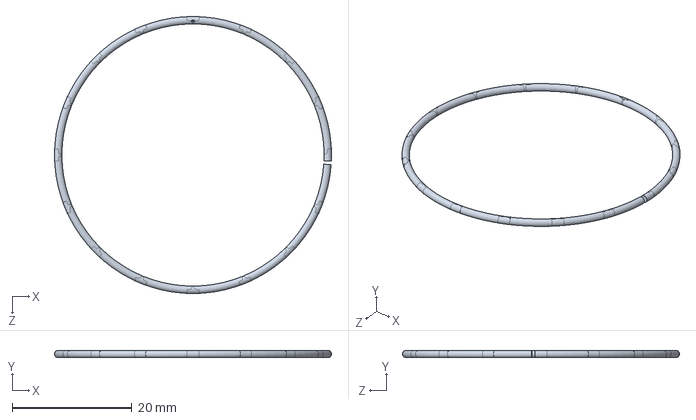
[picture p83: CAD file, 2021-10-04]
Robo 2021/SSL/Robô/Conjunto Motriz/Conjunto Omni/Aro omni.SLDPRT
46.2 x 1.24 x 46.2 mm
