roboime/SSL-Mec/Robo 2021/SSL/Robô/Conjunto Motriz/Motor e Suporte/Mockup Motor.SLDPRT

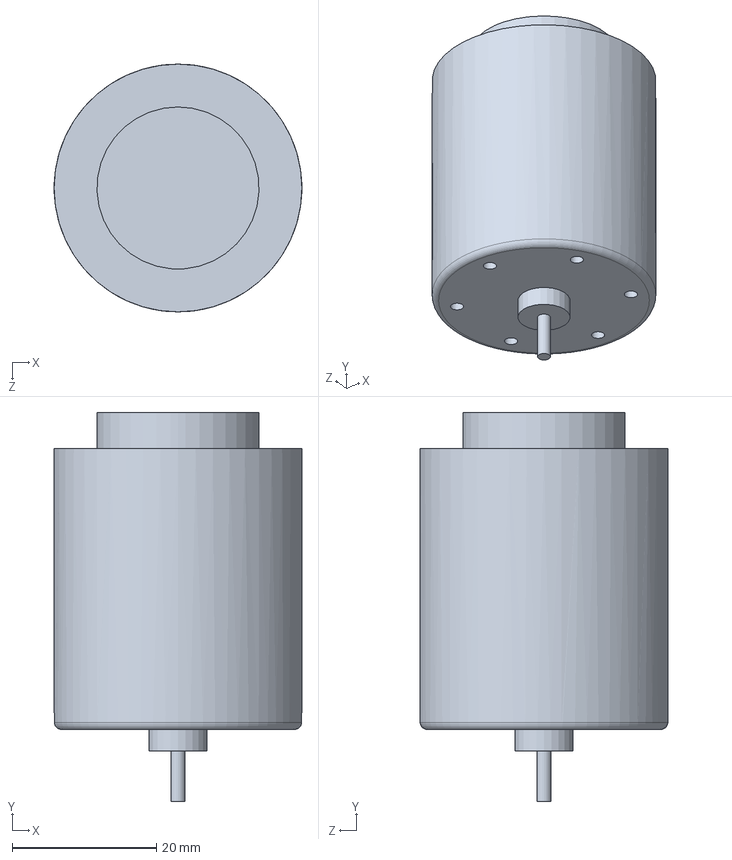
[picture p84: CAD file, 2021-10-04]
Robo 2021/SSL/Robô/Conjunto Motriz/Motor e Suporte/Mockup Motor.SLDPRT
34.4 x 54.0 x 34.4 mm
