roboime/SSL-Mec/Robo 2021/SSL/Robô/Elétricos/Suporte Bateria Esquerda.SLDPRT

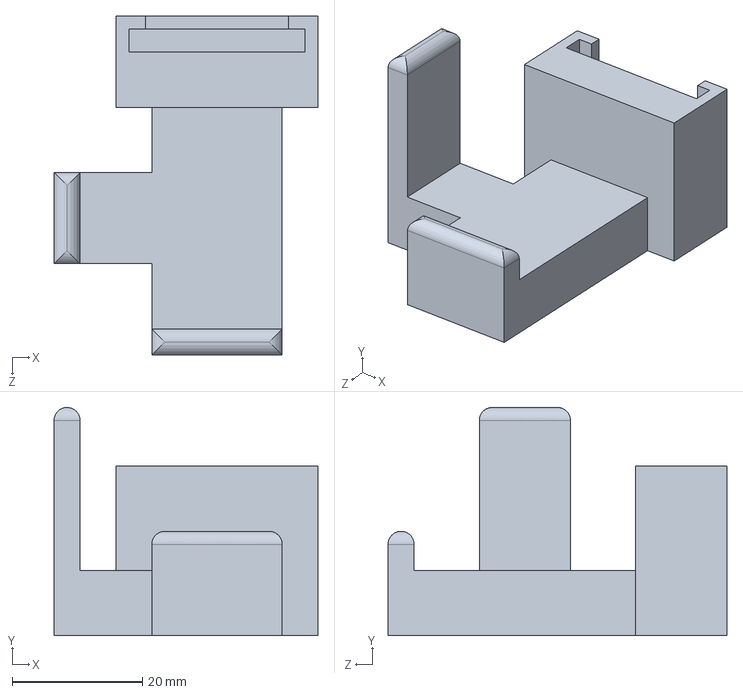
[picture p85: CAD file, 2021-10-04]
Robo 2021/SSL/Robô/Elétricos/Suporte Bateria Esquerda.SLDPRT
40.5 x 35.0 x 52.0 mm
