roboime/SSL-Mec/Robo 2021/SSL/Robô/Estrutura Fisica/Suporte Tampa.SLDPRT

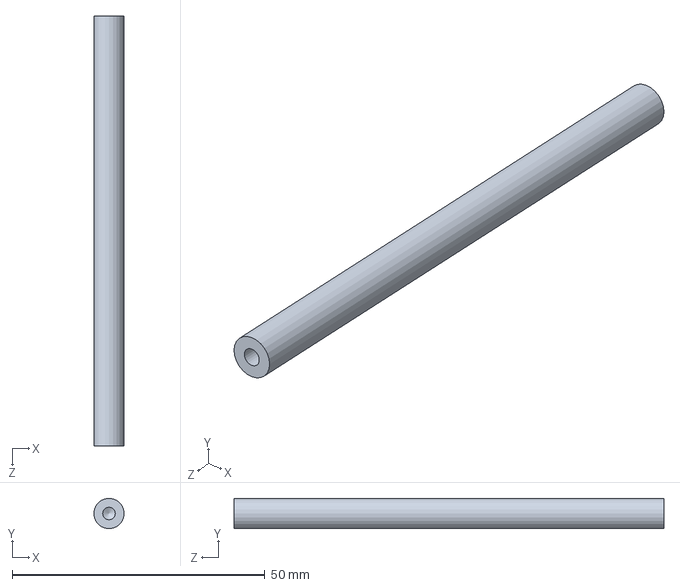
[picture p86: CAD file, 2021-10-04]
Robo 2021/SSL/Robô/Estrutura Fisica/Suporte Tampa.SLDPRT
6.00 x 6.00 x 85.0 mm
