roboime/SSL-Mec/Robo 2021/SSL/Toolbox/Metric - Spur gear 0.4M 43T 20PA 3FW ---S43N75H50L8N.SLDPRT

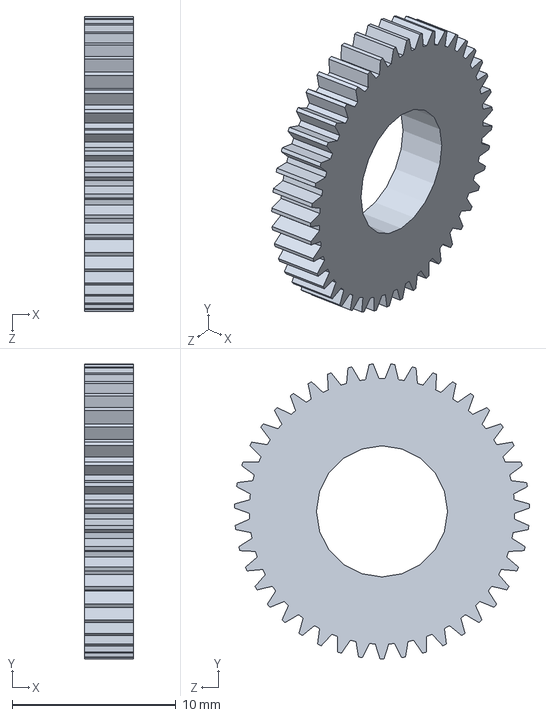
[picture p87: CAD file, 2021-10-04]
Robo 2021/SSL/Toolbox/Metric - Spur gear 0.4M 43T 20PA 3FW ---S43N75H50L8N.SLDPRT
3.00 x 18.0 x 18.0 mm
