roboime/SSL-Mec/Project_2024/Arquivos .STEP para Usinagem/Haste andar de baixo.SLDPRT

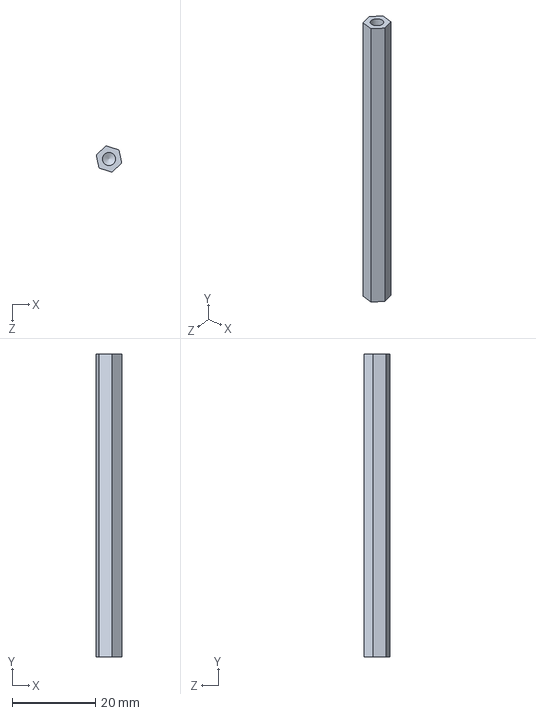
[picture p88: CAD file, 2024-02-03]
Project_2024/Arquivos .STEP para Usinagem/Haste andar de baixo.SLDPRT
6.18 x 73.0 x 6.36 mm
