roboime/SSL-Mec/Project_2024/Peças .stl/Suporte traseiro chute 2.STL

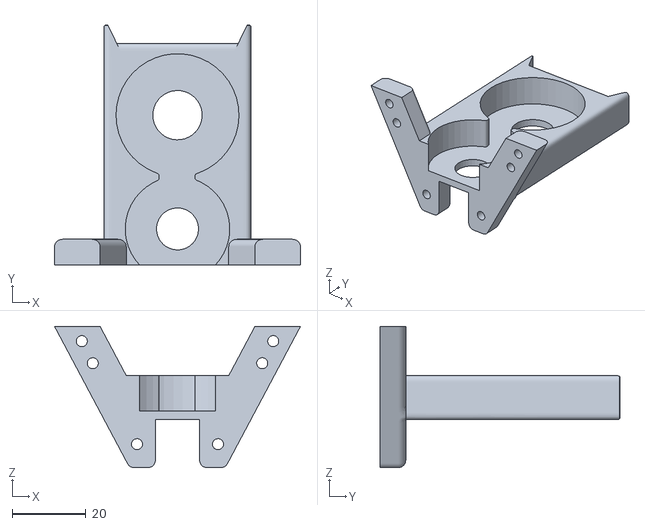
[picture p89: CAD file, 2024-02-03]
Project_2024/Peças .stl/Suporte traseiro chute 2.STL
66.8 x 65.2 x 38.4
