roboime/SSL-Mec/Project_2024/Peças e Montagens/Base 2.SLDPRT

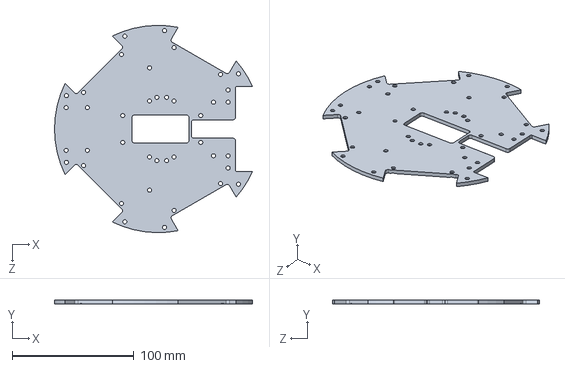
[picture p90: CAD file, 2024-02-03]
Project_2024/Peças e Montagens/Base 2.SLDPRT
162.5 x 3.00 x 170.0 mm
