roboime/SSL-Mec/Project_2024/Sistema de chute/Driblador/Mockup motor do driblador.SLDPRT

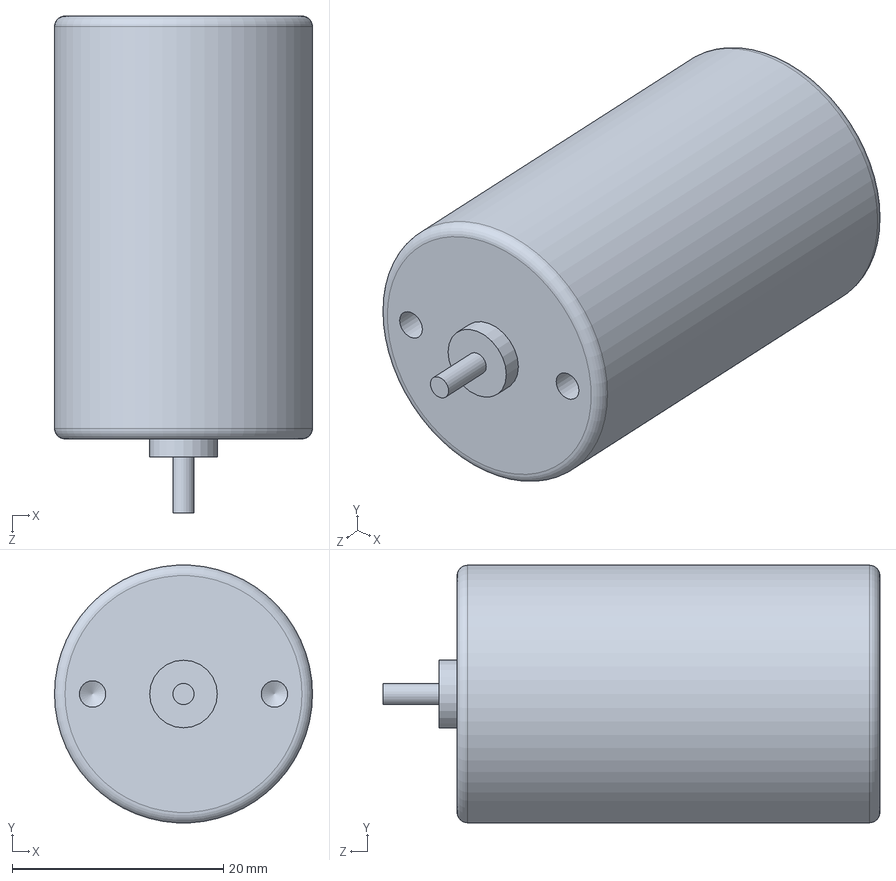
[picture p91: CAD file, 2021-10-04]
Project_2024/Sistema de chute/Driblador/Mockup motor do driblador.SLDPRT
24.4 x 24.4 x 47.0 mm
