roboime/SSL-Mec/Project_2024/Sistema de chute/Intermediário Chute-Rasteiro.SLDPRT

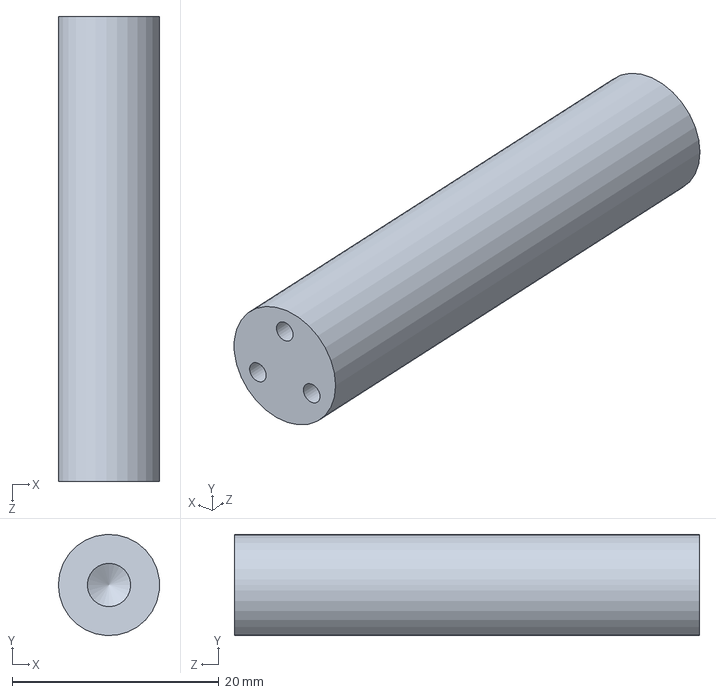
[picture p92: CAD file, 2024-02-03]
Project_2024/Sistema de chute/Intermediário Chute-Rasteiro.SLDPRT
9.80 x 9.79 x 45.0 mm
