roboime/SSL-Mec/Robo 2021/SSL/Diversos/Sistema de chute Antigo/Eixo CHUTE alto1.SLDPRT

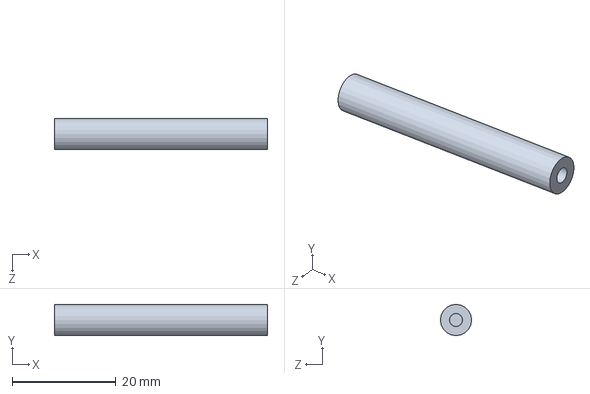
[picture p93: CAD file, 2021-10-04]
Robo 2021/SSL/Diversos/Sistema de chute Antigo/Eixo CHUTE alto1.SLDPRT
41.0 x 6.00 x 6.00 mm
