roboime/SSL-Mec/Robo 2021/SSL/Robô/Elétricos/Mockup Bateria.SLDPRT

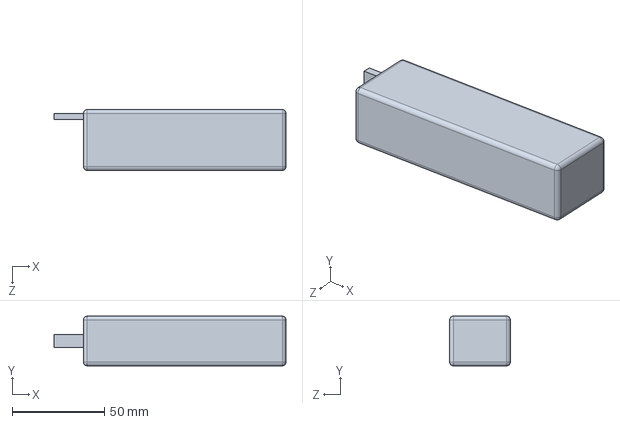
[picture p94: CAD file, 2021-10-04]
Robo 2021/SSL/Robô/Elétricos/Mockup Bateria.SLDPRT
126.0 x 27.0 x 33.0 mm
