roboime/SSL-Mec/Robo 2021/SSL/Robô/Estrutura Fisica/Suporte ELO.SLDPRT

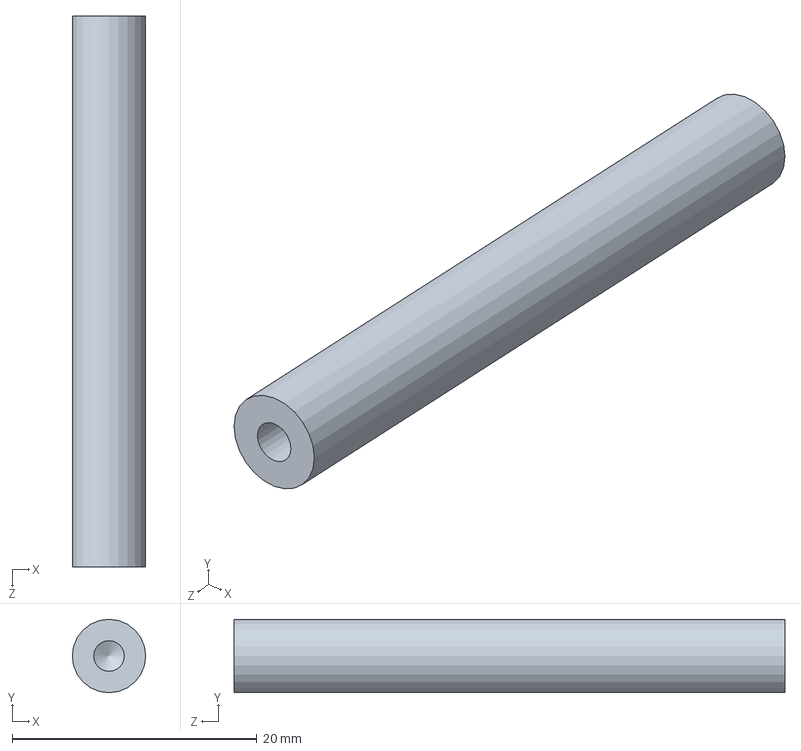
[picture p95: CAD file, 2021-10-04]
Robo 2021/SSL/Robô/Estrutura Fisica/Suporte ELO.SLDPRT
6.00 x 6.00 x 45.0 mm
