roboime/SSL-Mec/Robo 2021/SSL/Toolbox/Metric - Spur gear 0.5M 20T 20PA.SLDPRT

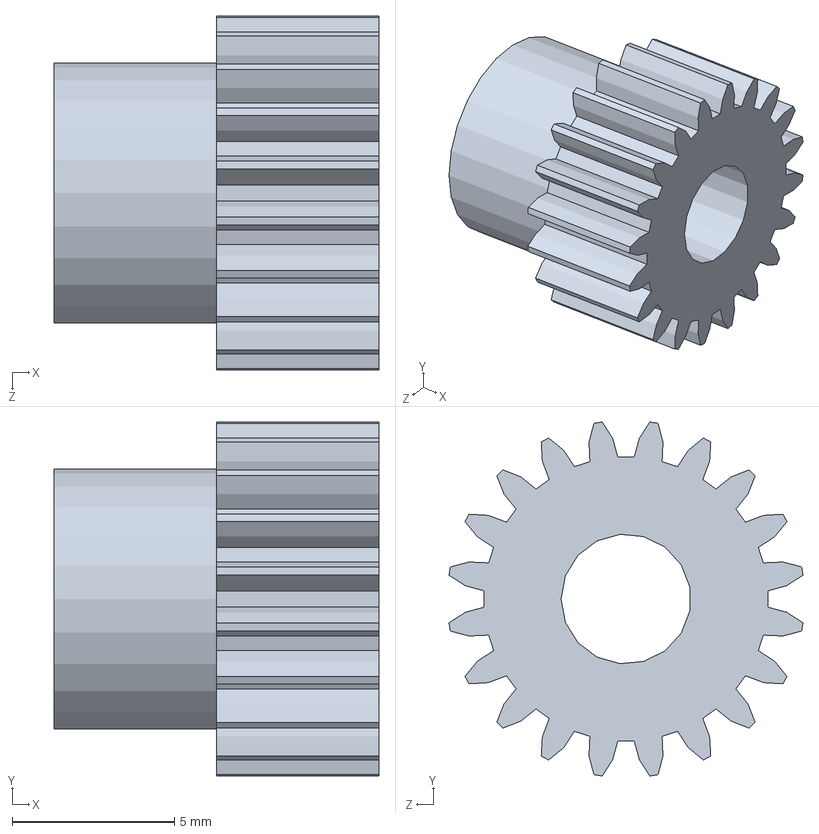
[picture p96: CAD file, 2021-10-04]
Robo 2021/SSL/Toolbox/Metric - Spur gear 0.5M 20T 20PA.SLDPRT
10.0 x 10.9 x 10.9 mm
