roboime/SSL-Mec/Project_2024/Arquivos .STEP para Usinagem/Chute rasteiro.SLDPRT

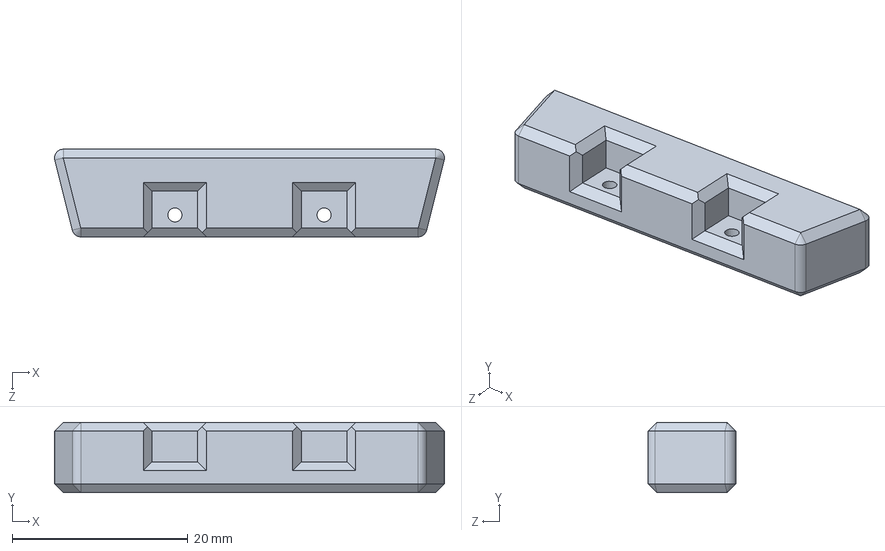
[picture p97: CAD file, 2024-02-03]
Project_2024/Arquivos .STEP para Usinagem/Chute rasteiro.SLDPRT
44.4 x 8.00 x 10.0 mm
