roboime/SSL-Mec/Project_2024/Peças e Montagens/150.SLDPRT

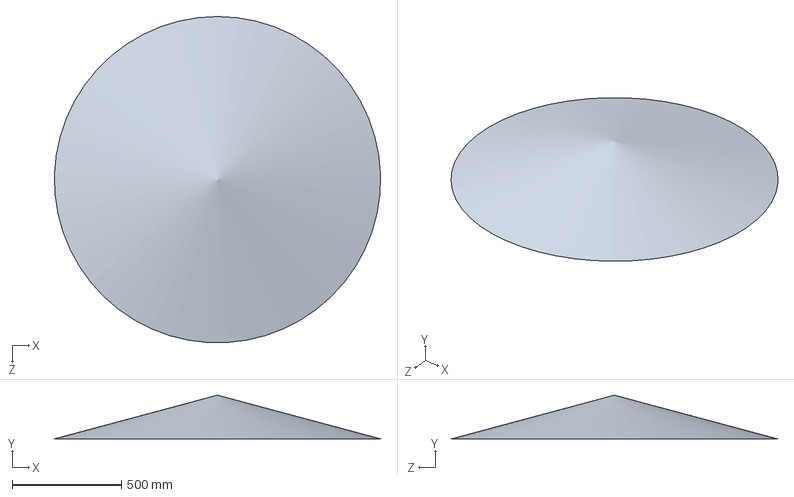
[picture p98: CAD file, 2024-02-03]
Project_2024/Peças e Montagens/150.SLDPRT
1492.2 x 200.0 x 1491.5 mm
