roboime/SSL-Mec/Project_2024/Sistema de chute/Acionador Chute Alto novo.SLDPRT

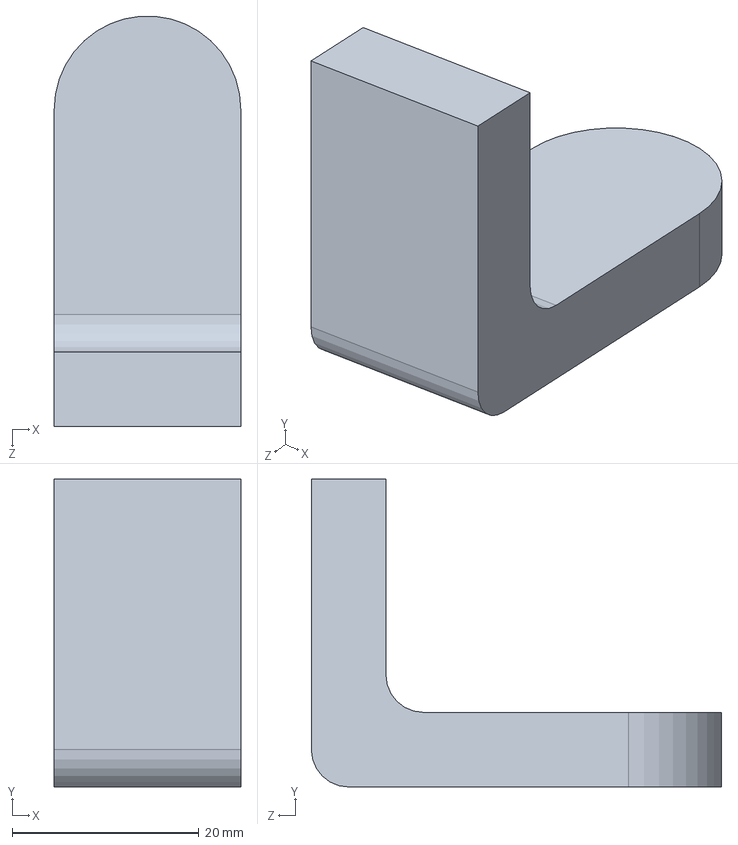
[picture p99: CAD file, 2024-02-03]
Project_2024/Sistema de chute/Acionador Chute Alto novo.SLDPRT
20.0 x 33.0 x 44.0 mm
