roboime/SSL-Mec/Robo 2021/SSL/Diversos/Motor + Suporte + Caixa Redutora/Eixo da Roda.SLDPRT

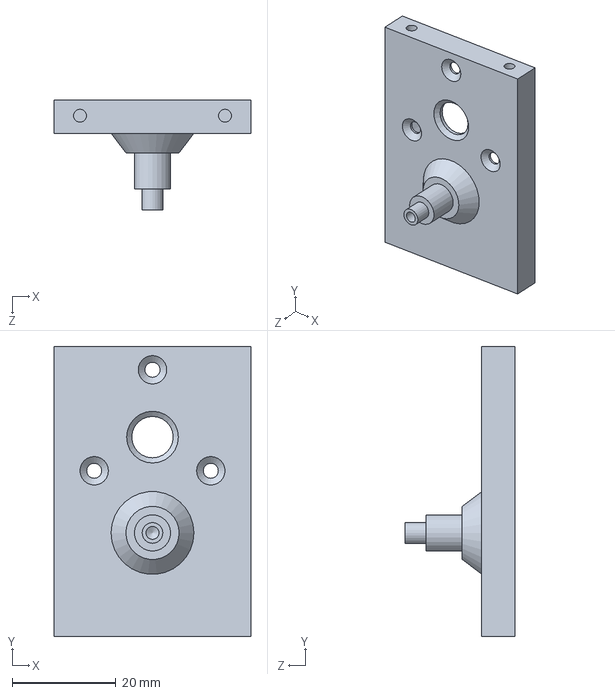
[picture p100: CAD file, 2021-10-04]
Robo 2021/SSL/Diversos/Motor + Suporte + Caixa Redutora/Eixo da Roda.SLDPRT
38.0 x 56.0 x 21.2 mm
