roboime/SSL-Mec/Robo 2021/SSL/Diversos/Sistema de chute Antigo/Carrete_solenoide_2018.SLDPRT

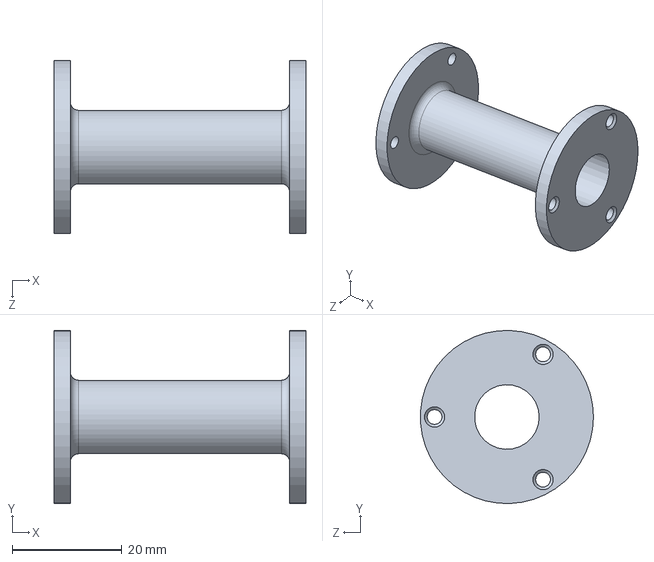
[picture p101: CAD file, 2021-10-04]
Robo 2021/SSL/Diversos/Sistema de chute Antigo/Carrete_solenoide_2018.SLDPRT
46.0 x 31.6 x 31.6 mm
