roboime/SSL-Mec/Robo 2021/SSL/Robô/Conjunto Motriz/Conjunto Omni/45 mm/5x9x4.SLDPRT

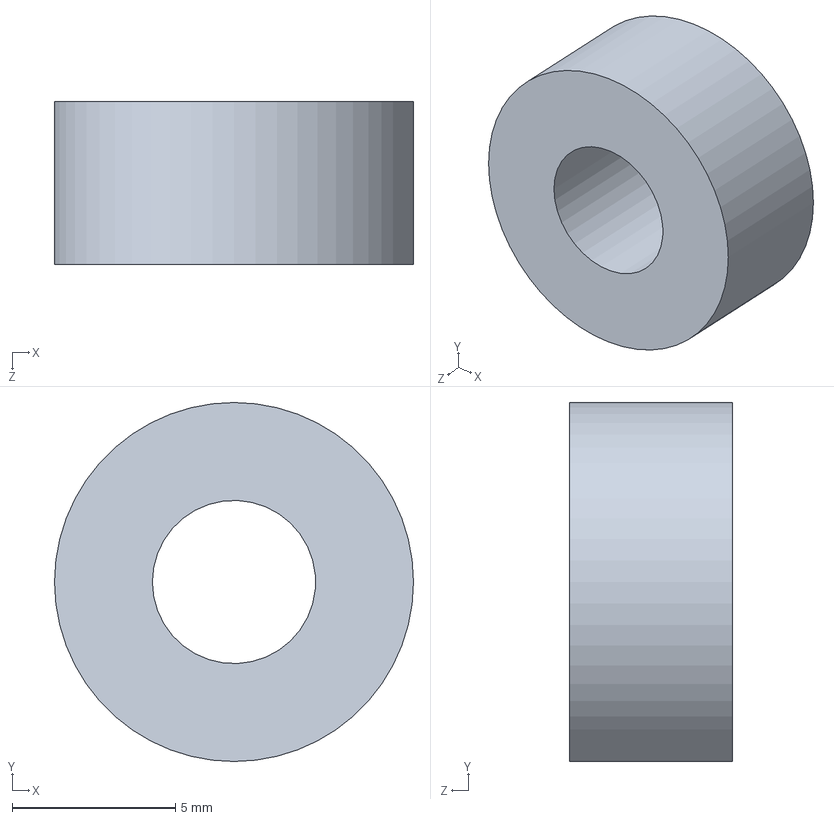
[picture p102: CAD file, 2021-10-04]
Robo 2021/SSL/Robô/Conjunto Motriz/Conjunto Omni/45 mm/5x9x4.SLDPRT
11.0 x 11.0 x 5.00 mm
