roboime/SSL-Mec/Robo 2021/SSL/Robô/Conjunto Motriz/Motor e Suporte/Engrenagem do Motor.SLDPRT

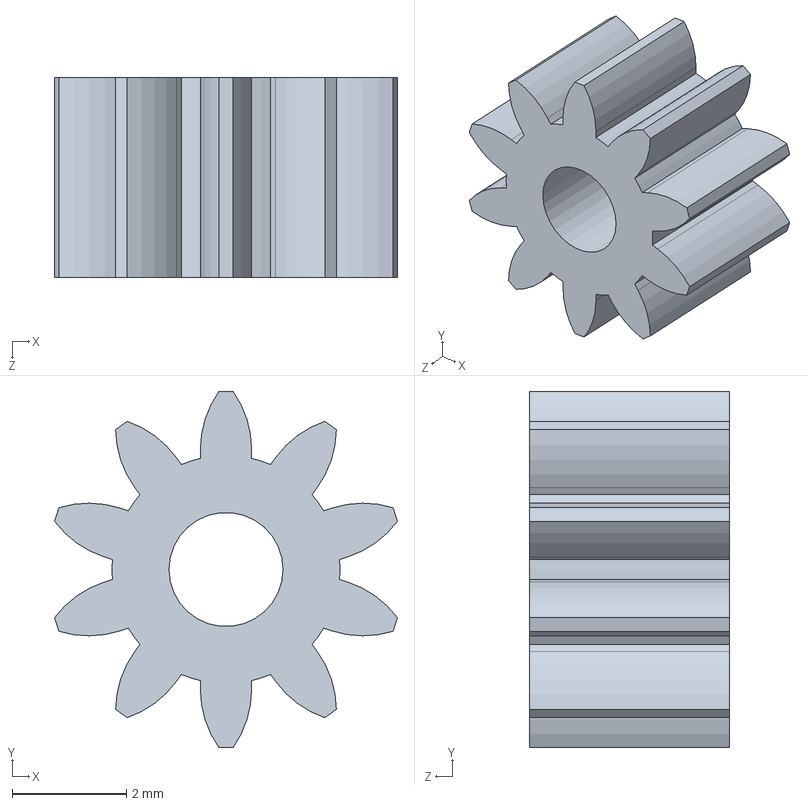
[picture p103: CAD file, 2021-10-04]
Robo 2021/SSL/Robô/Conjunto Motriz/Motor e Suporte/Engrenagem do Motor.SLDPRT
6.02 x 6.24 x 3.50 mm
