roboime/SSL-Mec/Robo 2021/SSL/Robô/Elétricos/Suporte de Bateria Direito.SLDPRT

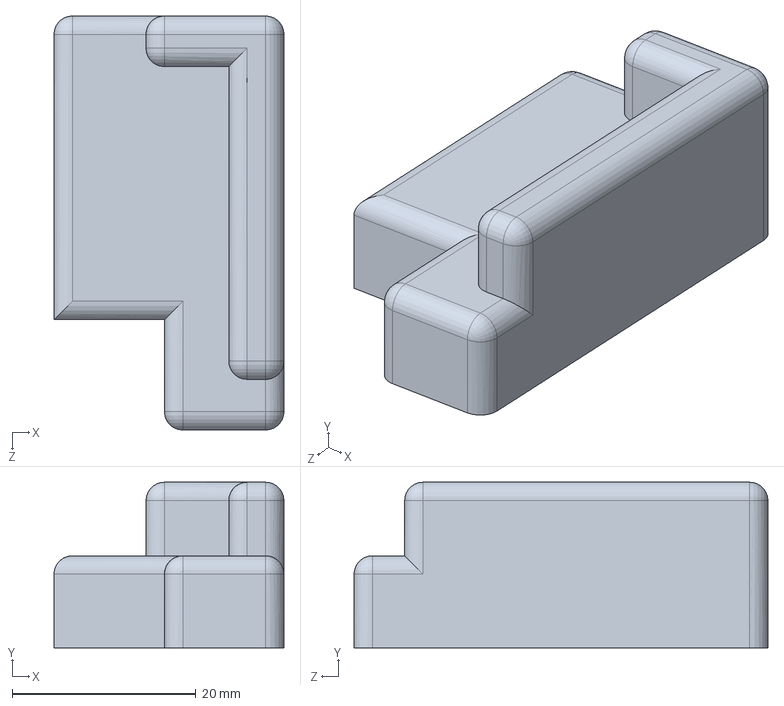
[picture p104: CAD file, 2021-10-04]
Robo 2021/SSL/Robô/Elétricos/Suporte de Bateria Direito.SLDPRT
25.0 x 18.0 x 45.0 mm
