roboime/SSL-Mec/Robo 2021/SSL/Robô/Estrutura Fisica/Amortecedor Carenagem.SLDPRT

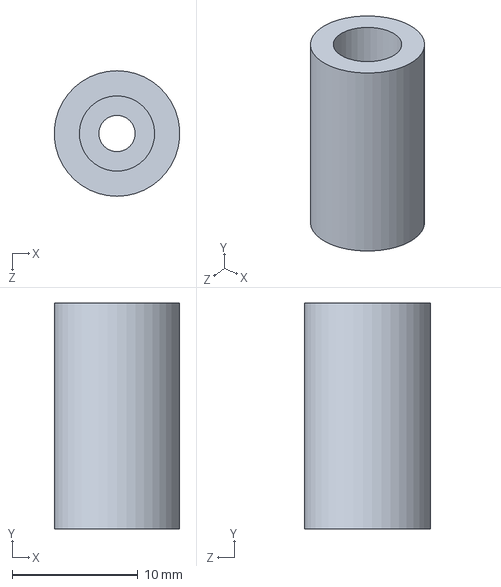
[picture p105: CAD file, 2021-10-04]
Robo 2021/SSL/Robô/Estrutura Fisica/Amortecedor Carenagem.SLDPRT
9.97 x 18.0 x 10.0 mm
