roboime/SSL-Mec/Robo 2021/SSL/Robô/Montagens/Bola.SLDPRT

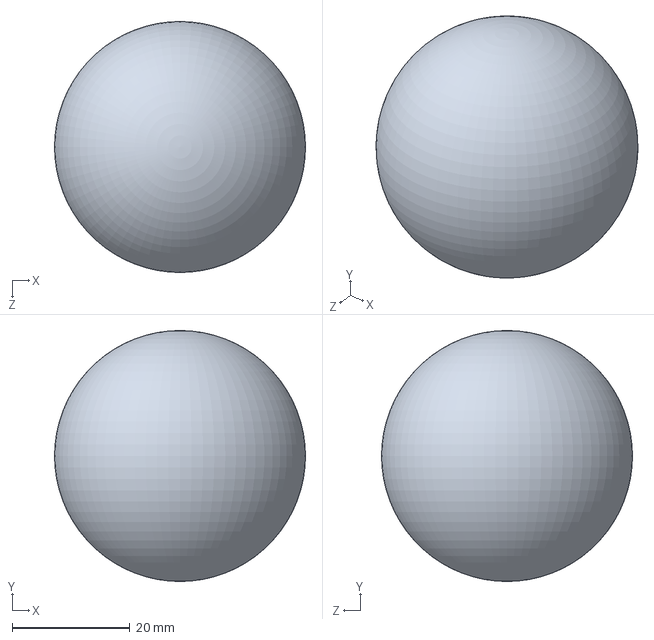
[picture p106: CAD file, 2021-10-04]
Robo 2021/SSL/Robô/Montagens/Bola.SLDPRT
42.6 x 42.6 x 42.6 mm
