roboime/SSL-Mec/Robo 2021/SSL/Robô/Sistema de chute/Driblador/Eixo engrenagem do drible.SLDPRT

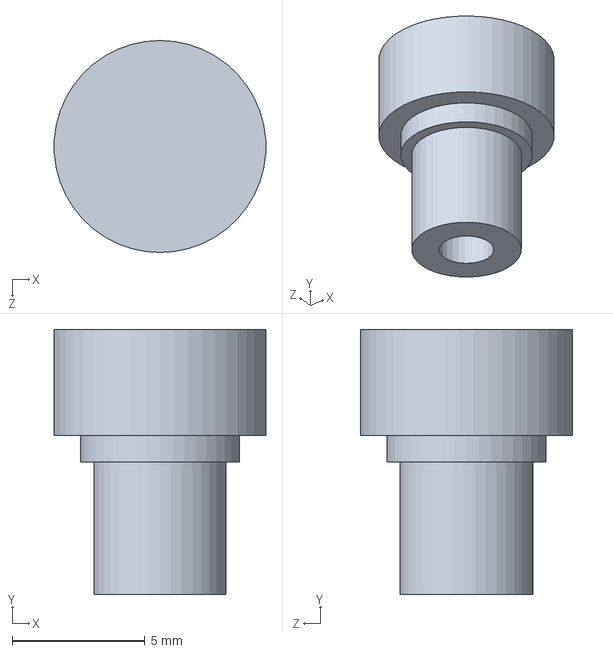
[picture p107: CAD file, 2021-10-12]
Robo 2021/SSL/Robô/Sistema de chute/Driblador/Eixo engrenagem do drible.SLDPRT
7.98 x 10.0 x 8.00 mm
