roboime/SSL-Mec/Robo 2021/SSL/Toolbox/Metric - Spur gear 0.5M 50T 20PA 3FW.SLDPRT

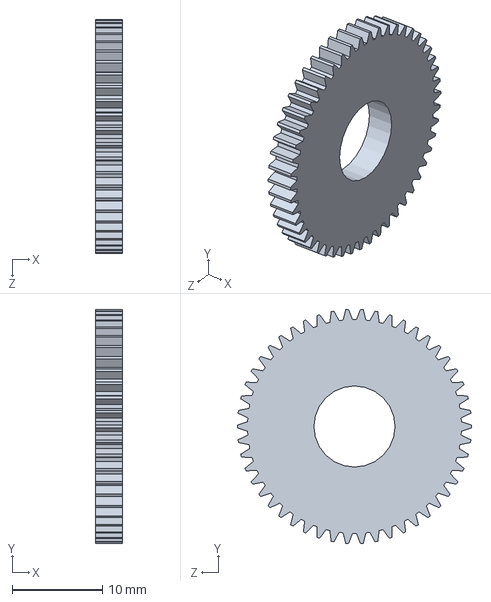
[picture p108: CAD file, 2021-10-04]
Robo 2021/SSL/Toolbox/Metric - Spur gear 0.5M 50T 20PA 3FW.SLDPRT
3.00 x 26.0 x 26.0 mm
