roboime/SSL-Mec/Project_2024/Arquivos .STEP para Usinagem/Chip chute alto.SLDPRT

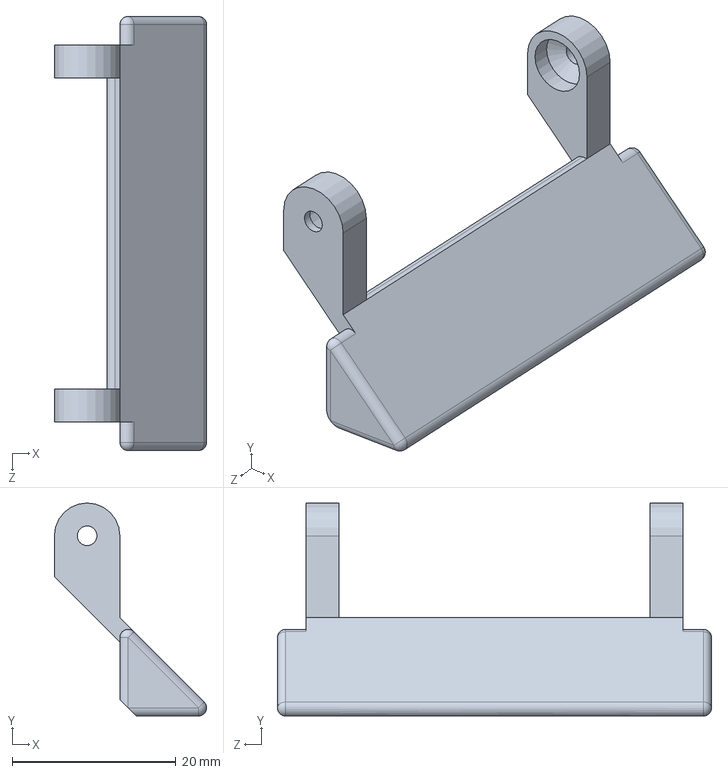
[picture p109: CAD file, 2024-02-03]
Project_2024/Arquivos .STEP para Usinagem/Chip chute alto.SLDPRT
18.6 x 26.0 x 53.0 mm
