roboime/SSL-Mec/Project_2024/Sistema de chute/Chip - Chute Alto.SLDPRT

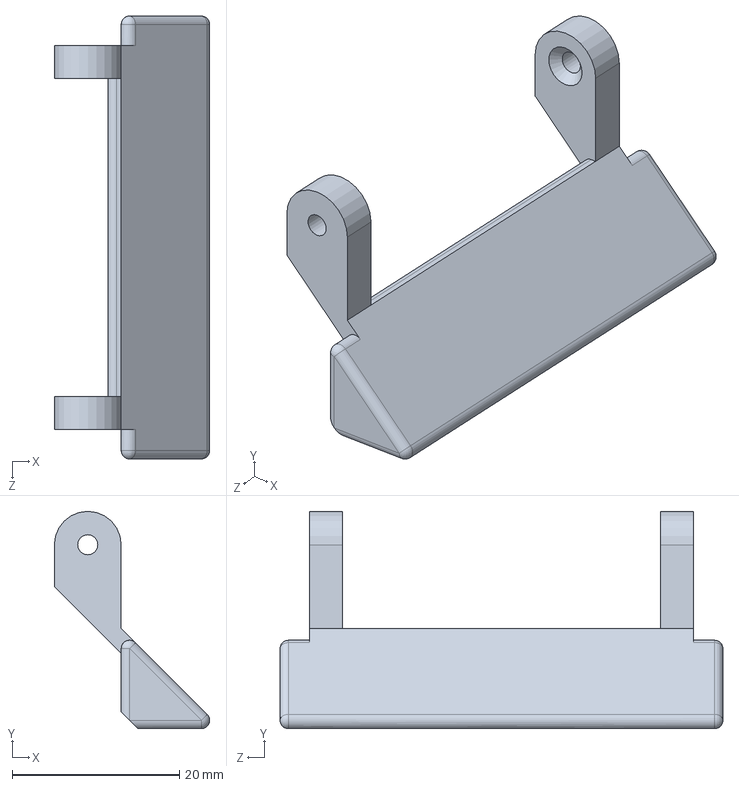
[picture p110: CAD file, 2024-02-03]
Project_2024/Sistema de chute/Chip - Chute Alto.SLDPRT
18.6 x 26.0 x 53.0 mm
