roboime/SSL-Mec/Project_2024/Sistema de chute/Driblador/Rolete Driblador.SLDPRT

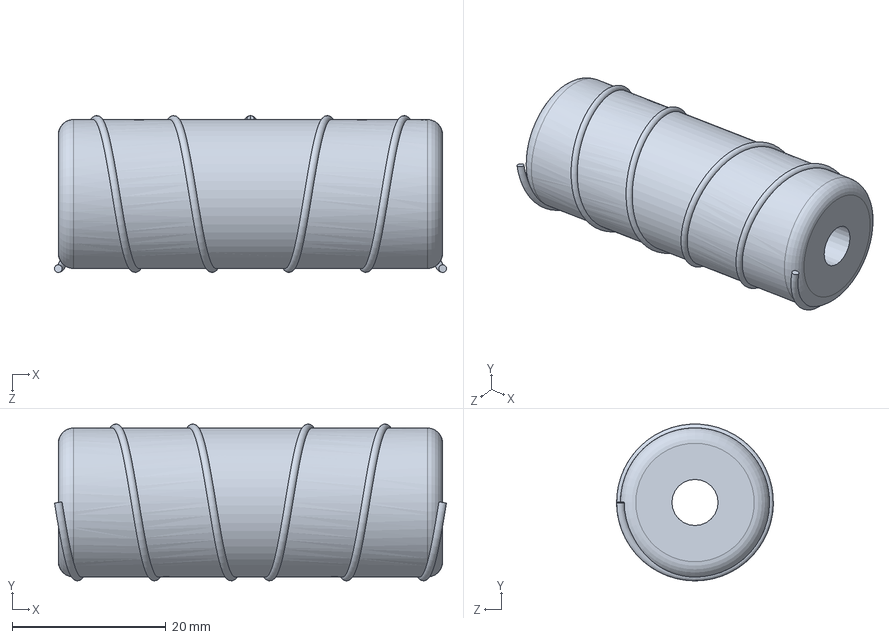
[picture p111: CAD file, 2021-10-04]
Project_2024/Sistema de chute/Driblador/Rolete Driblador.SLDPRT
51.0 x 20.4 x 20.4 mm
