roboime/SSL-Mec/Robo 2021/SSL/Diversos/Sistema de chute Antigo/Base para Chute.sldprt

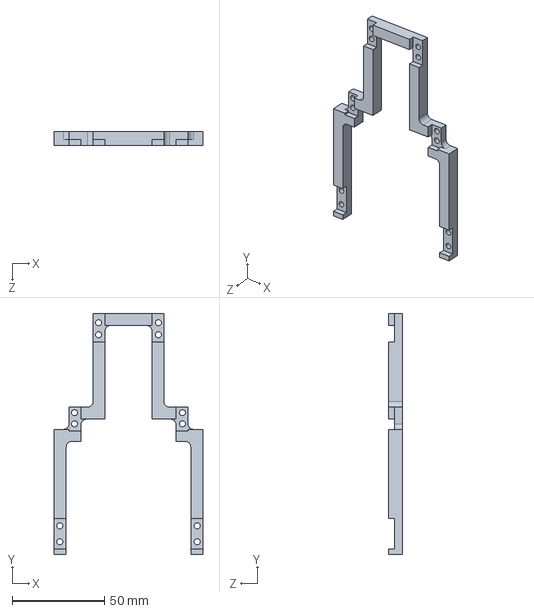
[picture p112: CAD file, 2021-10-04]
Robo 2021/SSL/Diversos/Sistema de chute Antigo/Base para Chute.sldprt
80.4 x 130.4 x 7.60 mm
