roboime/SSL-Mec/Robo 2021/SSL/Robô/Conjunto Motriz/Conjunto Omni/45 mm/Corpo Externo de 30.SLDPRT

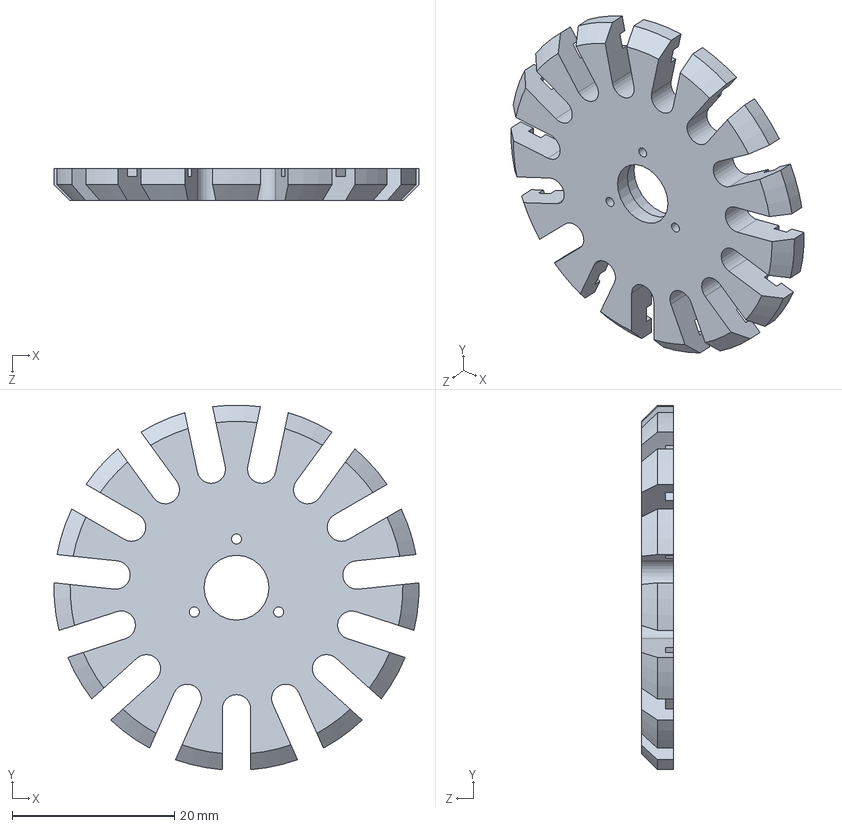
[picture p113: CAD file, 2021-10-04]
Robo 2021/SSL/Robô/Conjunto Motriz/Conjunto Omni/45 mm/Corpo Externo de 30.SLDPRT
45.0 x 44.9 x 4.00 mm
