roboime/SSL-Mec/Robo 2021/SSL/Robô/Elétricos/Suporte Bateria.SLDPRT

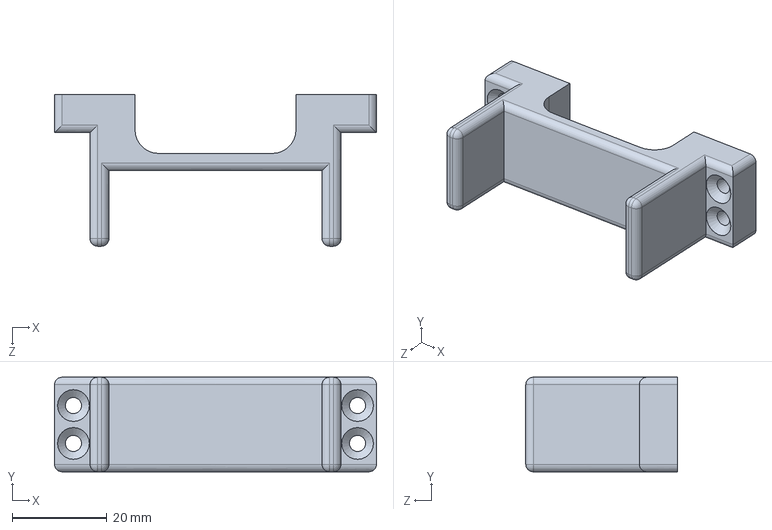
[picture p114: CAD file, 2021-10-04]
Robo 2021/SSL/Robô/Elétricos/Suporte Bateria.SLDPRT
68.0 x 20.0 x 32.0 mm
