roboime/SSL-Mec/Robo 2021/SSL/Robô/Montagens/Chao.SLDPRT

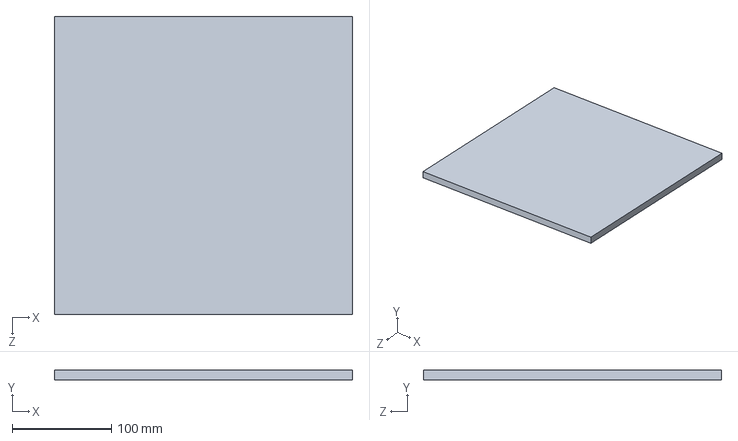
[picture p115: CAD file, 2021-10-04]
Robo 2021/SSL/Robô/Montagens/Chao.SLDPRT
300.0 x 10.0 x 300.0 mm
