roboime/SSL-Mec/Project_2024/Arquivos .STEP para Usinagem/Traseira do acionador rasteiro.SLDPRT

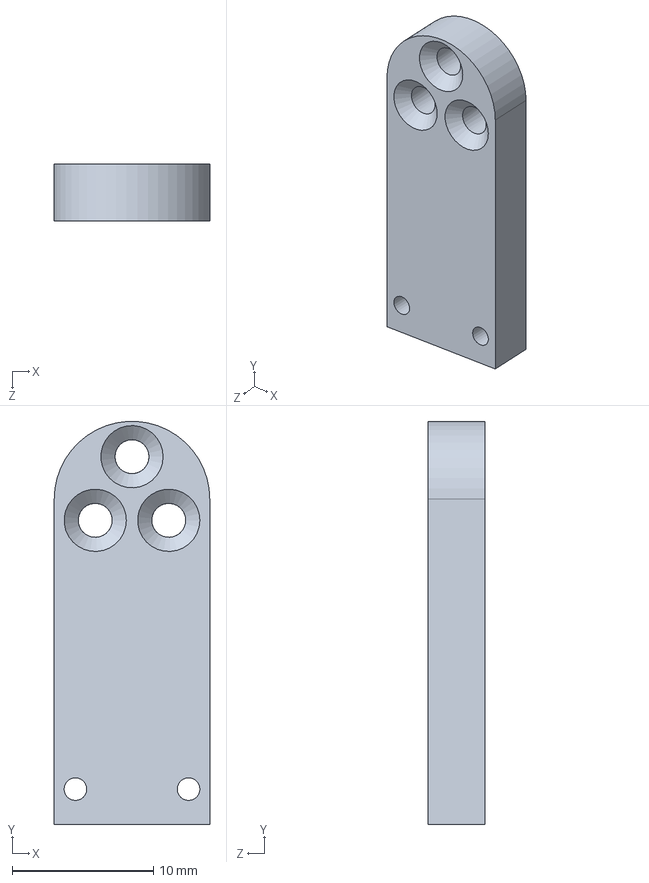
[picture p116: CAD file, 2024-02-03]
Project_2024/Arquivos .STEP para Usinagem/Traseira do acionador rasteiro.SLDPRT
11.0 x 28.5 x 4.00 mm
