roboime/SSL-Mec/Project_2024/Peças .stl/Haste andar de baixo.STL

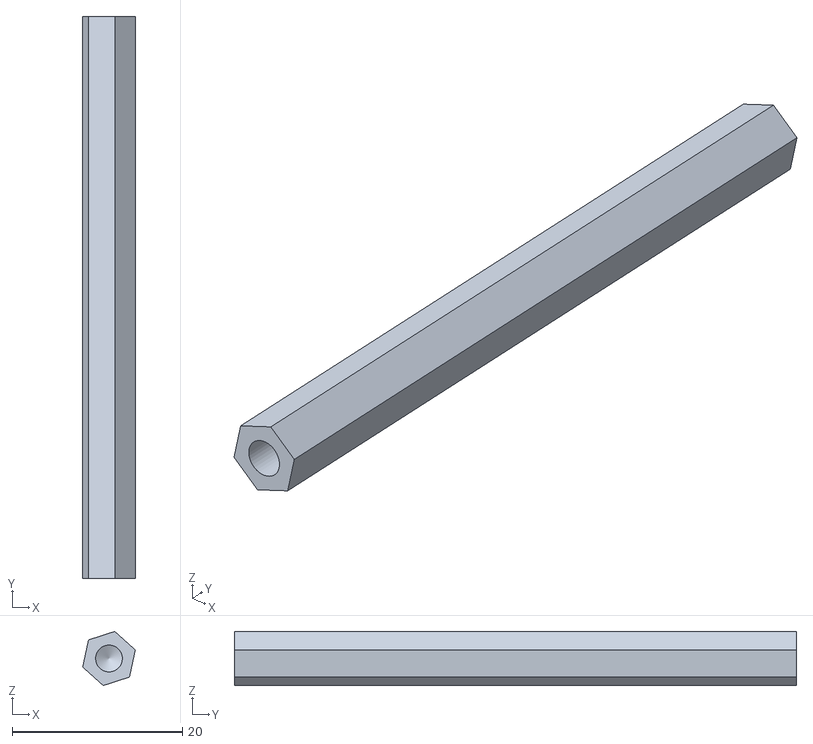
[picture p117: CAD file, 2024-02-03]
Project_2024/Peças .stl/Haste andar de baixo.STL
6.18 x 66.0 x 6.36
