roboime/SSL-Mec/Project_2024/Sistema de chute/Driblador/Estrutura transversal.SLDPRT

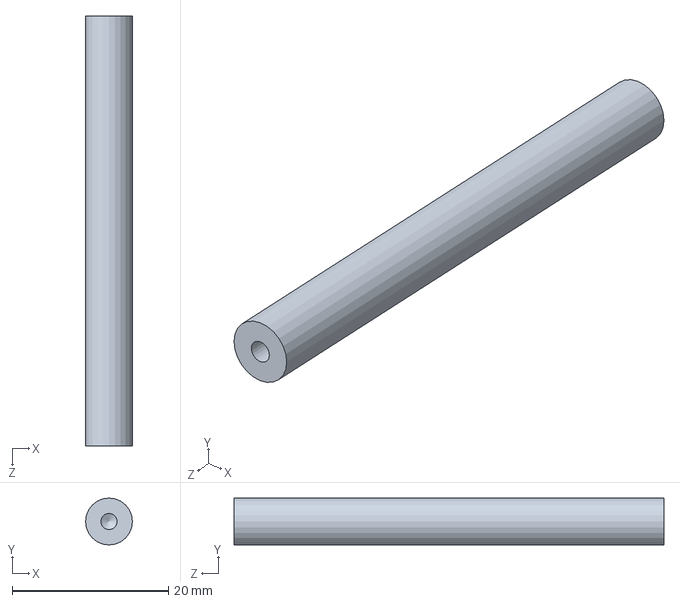
[picture p118: CAD file, 2021-10-04]
Project_2024/Sistema de chute/Driblador/Estrutura transversal.SLDPRT
6.00 x 6.00 x 55.0 mm
