roboime/SSL-Mec/Robo 2021/SSL/Diversos/Sistema de chute Antigo/Guia do chute rasteiro ESQUERDA 2019.STL

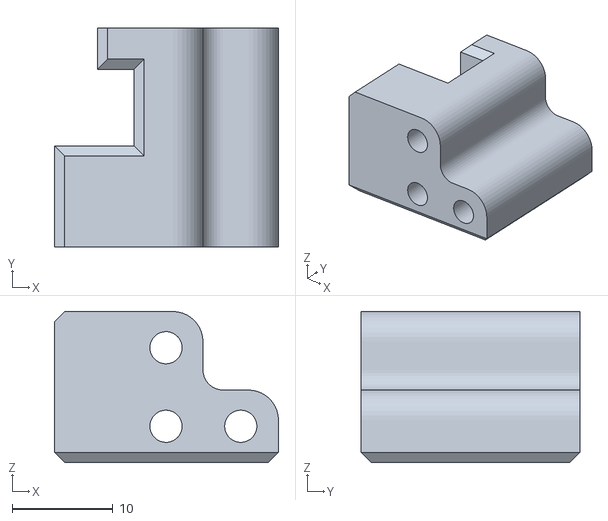
[picture p119: CAD file, 2021-10-04]
Robo 2021/SSL/Diversos/Sistema de chute Antigo/Guia do chute rasteiro ESQUERDA 2019.STL
22.2 x 21.8 x 15.0
