roboime/SSL-Mec/Robo 2021/SSL/Robô/Conjunto Motriz/Conjunto Omni/45 mm/Aro de Rodilha.SLDPRT

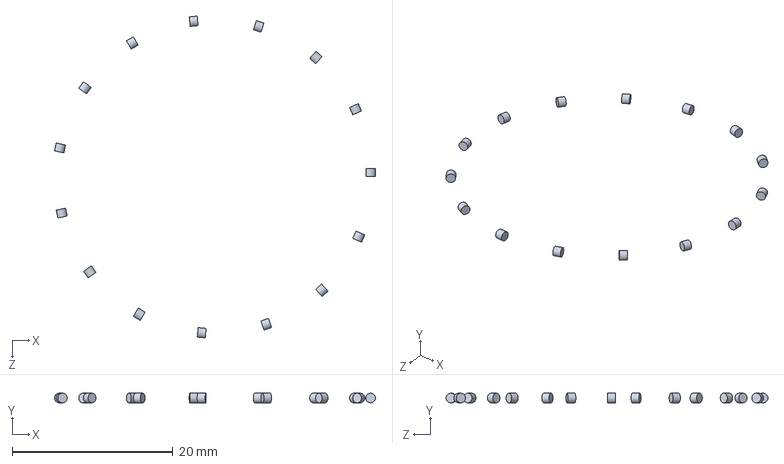
[picture p120: CAD file, 2021-10-04]
Robo 2021/SSL/Robô/Conjunto Motriz/Conjunto Omni/45 mm/Aro de Rodilha.SLDPRT
40.0 x 1.20 x 40.1 mm
