roboime/SSL-Mec/Robo 2021/SSL/Robô/Estrutura Fisica/Suporte Estrutura aço dobrado.SLDPRT

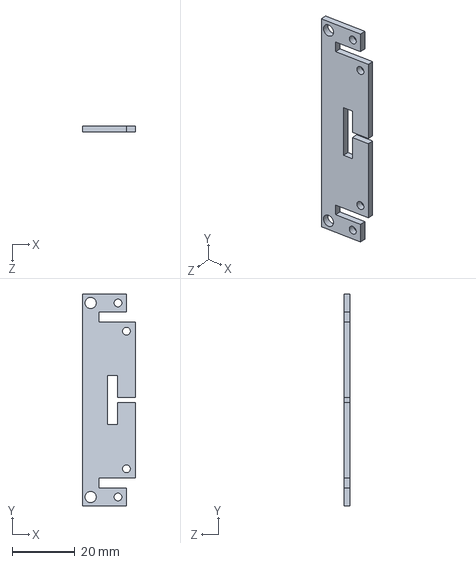
[picture p121: CAD file, 2021-10-04]
Robo 2021/SSL/Robô/Estrutura Fisica/Suporte Estrutura aço dobrado.SLDPRT
16.9 x 67.8 x 2.00 mm
