roboime/SSL-Mec/Project_2024/Arquivos .STEP para Usinagem/Suporte chute alto esquerdo.SLDPRT

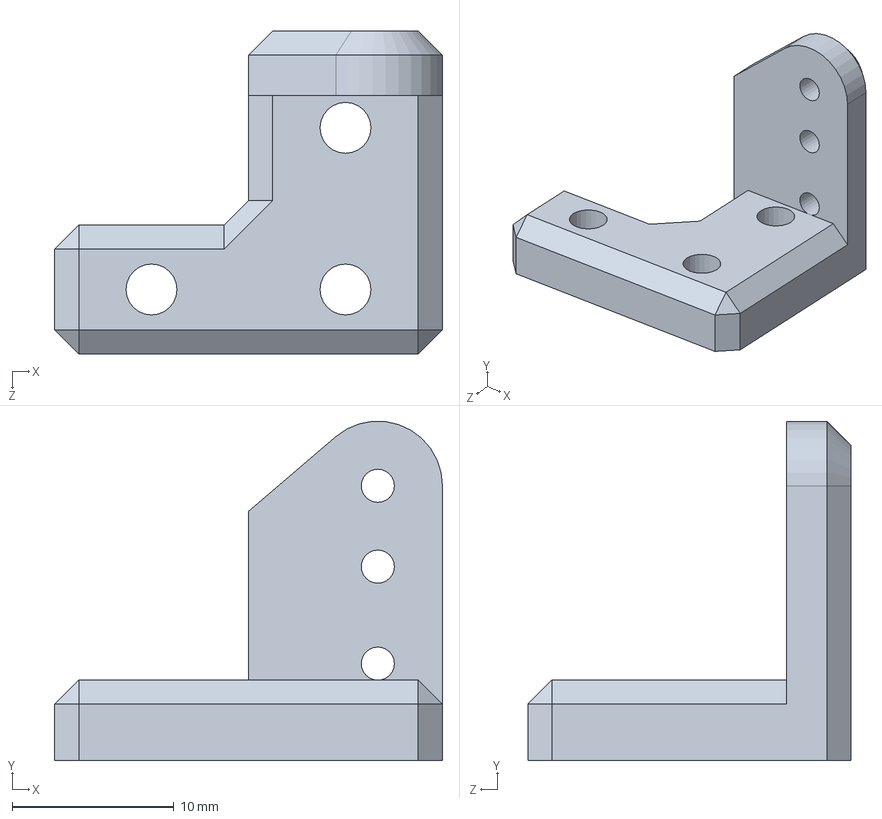
[picture p123: CAD file, 2024-02-03]
Project_2024/Arquivos .STEP para Usinagem/Suporte chute alto esquerdo.SLDPRT
24.0 x 21.0 x 20.0 mm
