roboime/SSL-Mec/Project_2024/Peças e Montagens/Eixo Drible.SLDPRT

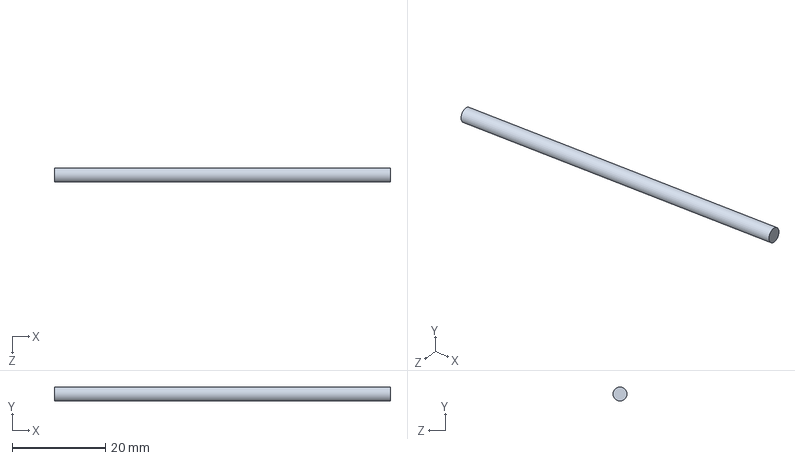
[picture p124: CAD file, 2024-02-03]
Project_2024/Peças e Montagens/Eixo Drible.SLDPRT
72.0 x 3.00 x 3.00 mm
