roboime/SSL-Mec/Project_2024/Sistema de chute/Driblador/Metric - Spur gear 0.4M 43T 20PA 2.5FW ---S43N75H50L8N.SLDPRT

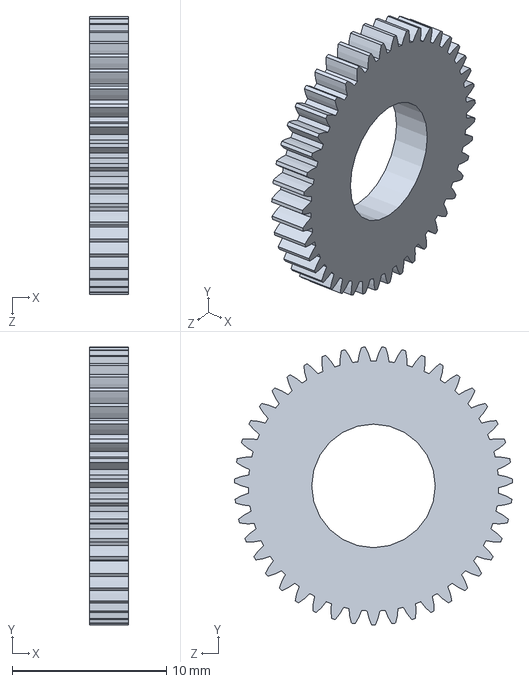
[picture p125: CAD file, 2021-10-04]
Project_2024/Sistema de chute/Driblador/Metric - Spur gear 0.4M 43T 20PA 2.5FW ---S43N75H50L8N.SLDPRT
2.50 x 18.0 x 18.0 mm
