roboime/SSL-Mec/Project_2024/Sistema de chute/Intermediario do Acionador Rasteiro.SLDPRT

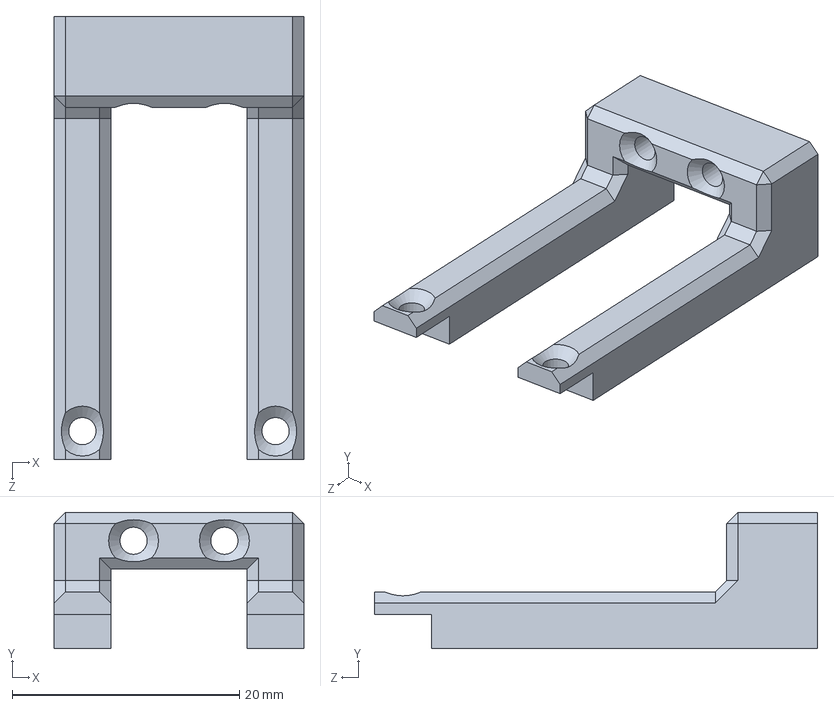
[picture p126: CAD file, 2021-10-04]
Project_2024/Sistema de chute/Intermediario do Acionador Rasteiro.SLDPRT
22.0 x 12.0 x 39.0 mm
