roboime/SSL-Mec/Robo 2021/SSL/Diversos/Sistema de chute Antigo/PLACA_CHUTE_ALTO_met_cap_mirror.SLDPRT

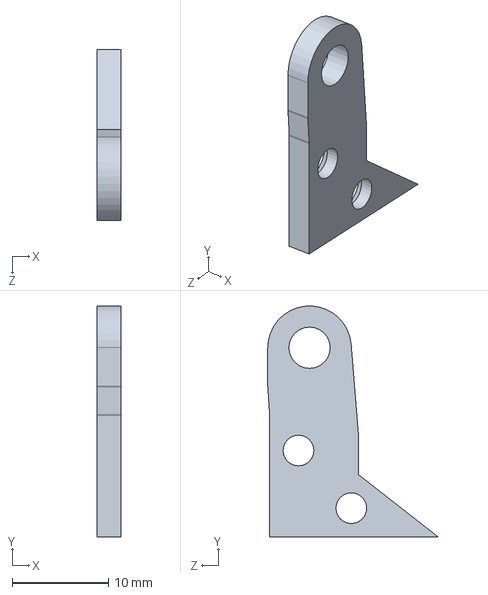
[picture p127: CAD file, 2021-10-04]
Robo 2021/SSL/Diversos/Sistema de chute Antigo/PLACA_CHUTE_ALTO_met_cap_mirror.SLDPRT
2.50 x 24.0 x 17.7 mm
