roboime/SSL-Mec/Robo 2021/SSL/Robô/Conjunto Motriz/Conjunto Omni/45 mm/Arame.SLDPRT

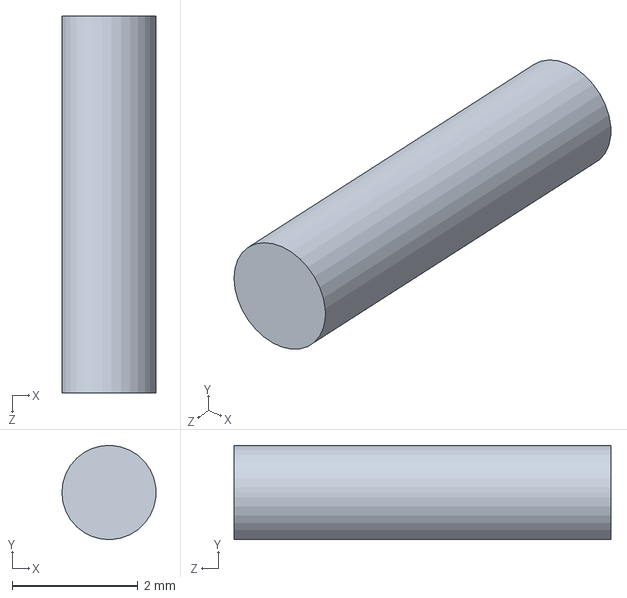
[picture p128: CAD file, 2021-10-04]
Robo 2021/SSL/Robô/Conjunto Motriz/Conjunto Omni/45 mm/Arame.SLDPRT
1.50 x 1.50 x 6.00 mm
