roboime/SSL-Mec/Robo 2021/SSL/Robô/Estrutura Fisica/Assoalho.SLDPRT

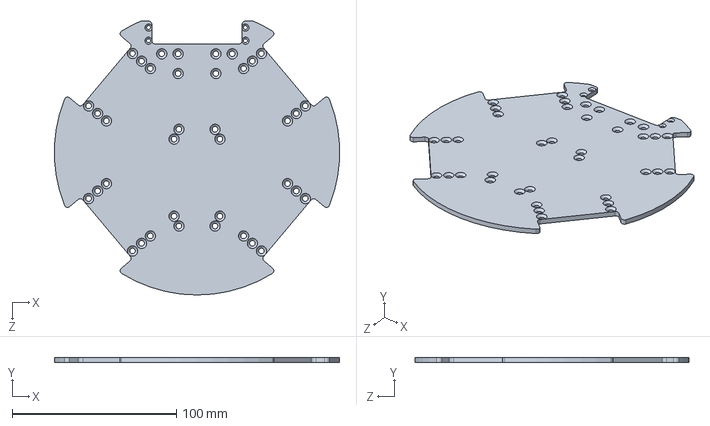
[picture p129: CAD file, 2021-10-04]
Robo 2021/SSL/Robô/Estrutura Fisica/Assoalho.SLDPRT
173.7 x 3.00 x 167.0 mm
