roboime/SSL-Mec/Robo 2021/SSL/Toolbox/B18.3.1M - 3 x 0.5 x 8 Hex SHCS -- 8SHX.SLDPRT

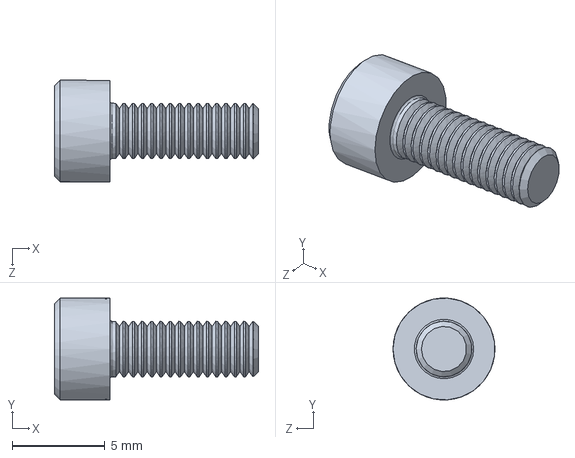
[picture p130: CAD file, 2021-10-04]
Robo 2021/SSL/Toolbox/B18.3.1M - 3 x 0.5 x 8 Hex SHCS -- 8SHX.SLDPRT
11.0 x 5.49 x 5.50 mm
