roboime/SSL-Mec/Project_2024/Arquivos .STEP para Usinagem/Pistão chute alto.SLDPRT

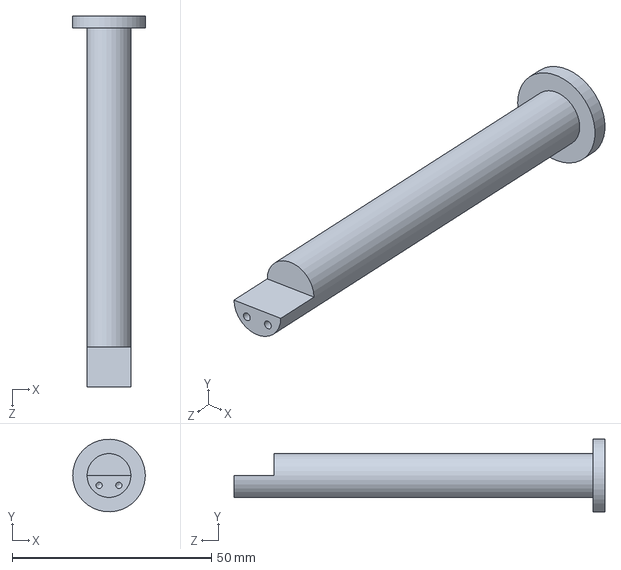
[picture p131: CAD file, 2024-02-03]
Project_2024/Arquivos .STEP para Usinagem/Pistão chute alto.SLDPRT
18.2 x 18.2 x 93.0 mm
