roboime/SSL-Mec/Project_2024/Peças e Montagens/Rodilha com eixo.SLDPRT

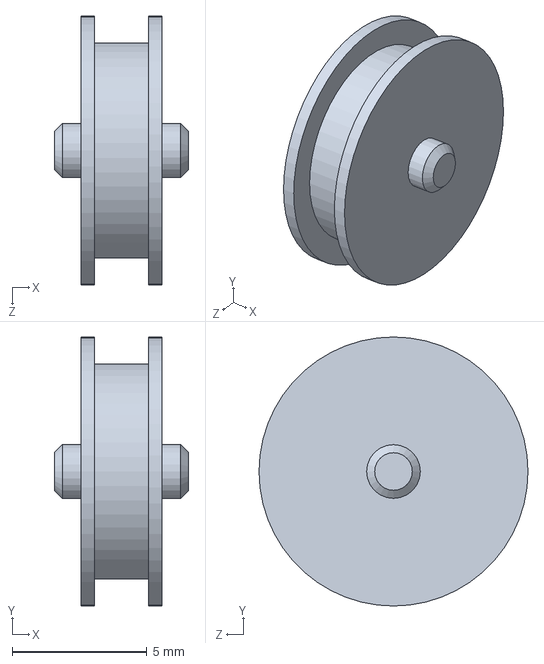
[picture p132: CAD file, 2024-02-03]
Project_2024/Peças e Montagens/Rodilha com eixo.SLDPRT
5.00 x 10.0 x 10.0 mm
