roboime/SSL-Mec/Project_2024/Sistema de chute/Driblador/Eixo Driblador.SLDPRT

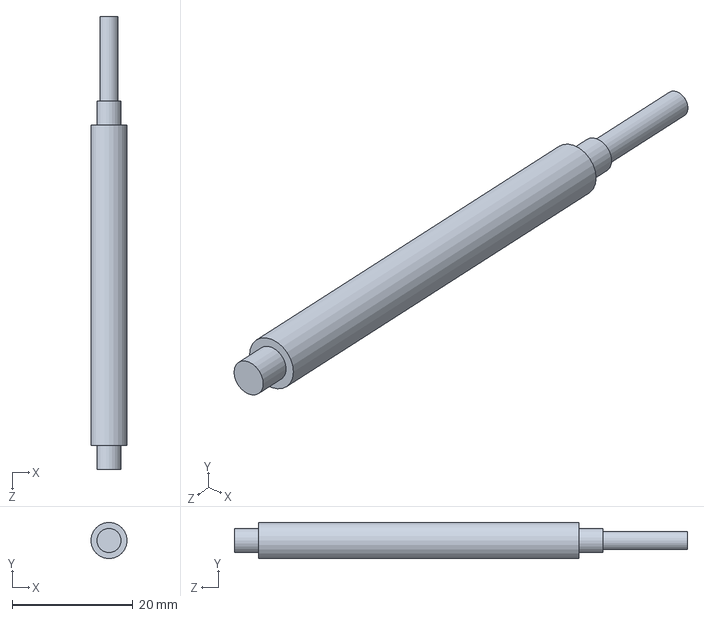
[picture p133: CAD file, 2021-10-04]
Project_2024/Sistema de chute/Driblador/Eixo Driblador.SLDPRT
6.00 x 6.00 x 75.0 mm
