roboime/SSL-Mec/Project_2024/Peças e Montagens/Montagem Sistema Chute.SLDASM

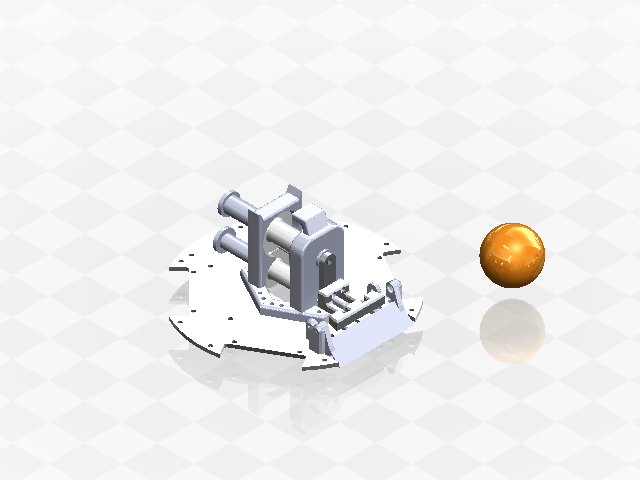
[picture p134: CAD file, 2024-02-03]
Project_2024/Peças e Montagens/Montagem Sistema Chute.SLDASM
Base 2
Suporte frontal chute 2
Suporte traseiro chute 2
Carretel chute alto
Carretel chute rasteiro
Suporte chute alto direito
Suporte chute alto esquerdo
Pistão chute alto
Pistão chute rasteiro
Acionador chute alto
Traseira do acionador rasteiro
Chute rasteiro
Intermediario do acionador rasteiro
Bola
Suporte Chip Chute Alto Direito
Suporte Chip Chute Alto Esquerdo
Prisma Chute Alto
