roboime/SSL-Mec/Project_2024/Peças e Montagens/Montagem 3.SLDASM

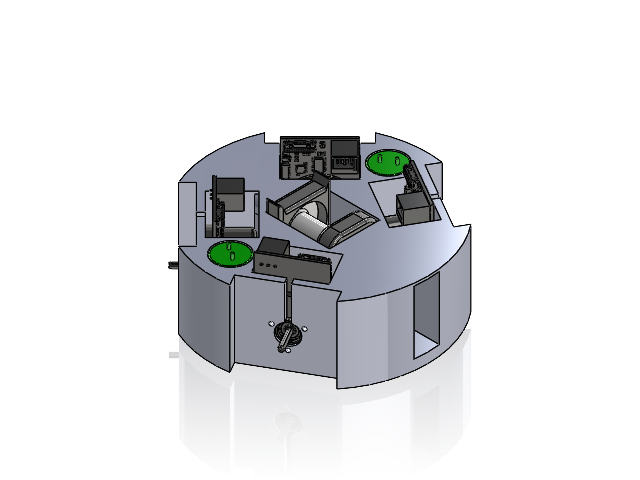
[picture p135: CAD file, 2024-02-03]
Project_2024/Peças e Montagens/Montagem 3.SLDASM
Suporte chute traseiro
Suporte frontal chute
Carretel chute alto
Carretel chute rasteiro
Pistão chute alto
Pistão chute rasteiro
Capacitor x 2
Base 3
Motor DF45L024048-E.stp x 4
