roboime/SSL-Mec/(list of files, cad)

Other CAD files:
Robo 2021/SSL/Robô/Montagens/Montagem Segundo Andar- Direito.SLDASM
Robo 2021/SSL/Robô/Sistema de chute/Driblador/Motor Driblador.SLDASM
Robo 2021/SSL/Robô/Estrutura Fisica/SSL-Motherboarda.step.SLDASM
Robo 2021/SSL/Toolbox/Montagem engrenagem drible.SLDASM
Robo 2021/SSL/Robô/Estrutura Fisica/2 Andar - Esquerdo.SLDPRT
Robo 2021/SSL/Robô/Sistema de chute/Driblador/Metric - Spur gear 0.4M 12T 20PA 2.5FW ---S12N75H50L2N.SLDPRT
Robo 2021/SSL/Robô/Conjunto Motriz/Conjunto Omni/45 mm/Corpo Interno.SLDPRT
Robo 2021/SSL/Robô/Conjunto Motriz/Motor e Suporte/Engrenagem do MotorC LARC.SLDPRT
Project_2024/Peças .stl/Suporte Chip Chute Alto Direito.STL
Project_2024/Sistema de chute/Driblador/Rolamento 4x9x4.SLDPRT
Project_2024/Peças .stl/Base 2.STL
Robo 2021/SSL/Diversos/Motor + Suporte + Caixa Redutora/Mockup Motor.SLDPRT
Robo 2021/SSL/Robô/Sistema de chute/Driblador/Apoio engrenagem.SLDPRT
Project_2024/Peças e Montagens/Carretel chute rasteiro.SLDPRT
Project_2024/Peças .stl/Suporte chute alto direito.STL
Project_2024/Peças .stl/Pistão chute alto.STL
Project_2024/Arquivos .STEP para Usinagem/Acionador chute alto.SLDPRT
Project_2024/Arquivos .STEP para Usinagem/Base 1.SLDPRT
Project_2024/Arquivos .STEP para Usinagem/Rodilha com eixo.SLDPRT
Project_2024/Arquivos .STEP para Usinagem/Rodilha com eixo.STEP
Project_2024/Arquivos .STEP para Usinagem/Suporte chute alto direito.SLDPRT
Project_2024/Arquivos .STEP para Usinagem/Suporte motor.SLDPRT
Project_2024/Desenhos técnicos IMBEL/Haste andar de baixo 2.SLDDRW
Project_2024/Desenhos técnicos IMBEL/Pistão chute alto.SLDDRW
Project_2024/Desenhos técnicos IMBEL/Pistão chute rasteiro.SLDDRW
Project_2024/Desenhos técnicos IMBEL/Suporte motor.SLDDRW
Project_2024/Desenhos técnicos IMBEL/Transmissor de torque da roda.SLDDRW
Project_2024/Desenhos técnicos/Acionador chute alto.SLDDRW
Project_2024/Desenhos técnicos/Chip chute alto.SLDDRW
Project_2024/Desenhos técnicos/Chute rasteiro.SLDDRW
Project_2024/Desenhos técnicos/Haste andar de baixo 2.SLDDRW
Project_2024/Desenhos técnicos/Haste andar de baixo.SLDDRW
Project_2024/Desenhos técnicos/Intermediario do acionador rasteiro.SLDDRW
Project_2024/Desenhos técnicos/Pistão chute alto.SLDDRW
Project_2024/Desenhos técnicos/Pistão chute rasteiro.SLDDRW
Project_2024/Desenhos técnicos/Rodilha com eixo.SLDDRW
Project_2024/Desenhos técnicos/Rodilha.SLDDRW
Project_2024/Desenhos técnicos/Suporte chute alto direito.SLDDRW
Project_2024/Desenhos técnicos/Suporte chute alto esquerdo.SLDDRW
Project_2024/Desenhos técnicos/Suporte motor.SLDDRW
Project_2024/Desenhos técnicos/Transmissor de torque da roda.SLDDRW
Project_2024/Desenhos técnicos/Traseira do acionador rasteiro.SLDDRW
Project_2024/Peças .stl/Carretel chute alto.STL
Project_2024/Peças .stl/Prisma Chute Alto.STL
Project_2024/Peças .stl/Suporte Chip Chute Alto Esquerdo.STL
Project_2024/Peças .stl/Suporte frontal chute 2.STL
Project_2024/Peças .stl/Suporte interno carenagem.STL
Project_2024/Peças .stl/Suporte motor frontal direito.STL
Project_2024/Peças .stl/Suporte motor frontal esquerdo.STL
Project_2024/Peças e Montagens/Acionador chute alto.SLDPRT
Project_2024/Peças e Montagens/Base 1.SLDPRT
Project_2024/Peças e Montagens/Base 3.SLDPRT
Project_2024/Peças e Montagens/Bateria 6s 22.2v 1300mah Cnhl.SLDPRT
Project_2024/Peças e Montagens/Bola.SLDPRT
Project_2024/Peças e Montagens/Borracha da rodilha.SLDPRT
Project_2024/Peças e Montagens/Capacitor.SLDPRT
Project_2024/Peças e Montagens/Carenagem.SLDPRT
Project_2024/Peças e Montagens/Carretel chute alto.SLDPRT
Project_2024/Peças e Montagens/Cilindro drible.SLDPRT
Project_2024/Peças e Montagens/Eixo Engrenagem central Drible.SLDPRT
Project_2024/Peças e Montagens/Haste andar de baixo.SLDPRT
Project_2024/Peças e Montagens/Haste andar de cima.SLDPRT
Project_2024/Peças e Montagens/Intermediario do acionador rasteiro.SLDPRT
Project_2024/Peças e Montagens/Motor DF45L024048-E.stp.SLDPRT
Project_2024/Peças e Montagens/Motor Drible.SLDPRT
Project_2024/Peças e Montagens/NoIR Wide Angle Camera v2.SLDPRT
Project_2024/Peças e Montagens/OLED_0.91_128x32.SLDPRT
Project_2024/Peças e Montagens/Pistão chute alto.SLDPRT
Project_2024/Peças e Montagens/Pistão chute rasteiro.SLDPRT
Project_2024/Peças e Montagens/Placa Inferior Elo.SLDPRT
Project_2024/Peças e Montagens/Placa Superior Elo.SLDPRT
Project_2024/Peças e Montagens/Ponte Drible.SLDPRT
Project_2024/Peças e Montagens/Porca autotravante.SLDPRT
Project_2024/Peças e Montagens/Prisma Chute Alto.SLDPRT
Project_2024/Peças e Montagens/RP 5.SLDPRT
Project_2024/Peças e Montagens/Roda parte 1.SLDPRT
Project_2024/Peças e Montagens/Roda parte 2.SLDPRT
Project_2024/Peças e Montagens/Rodilha.SLDPRT
Project_2024/Peças e Montagens/Suporte Motor Drible.SLDPRT
Project_2024/Peças e Montagens/Suporte chute alto direito.SLDPRT
Project_2024/Peças e Montagens/Suporte chute alto esquerdo.SLDPRT
Project_2024/Peças e Montagens/Suporte chute traseiro.SLDPRT
Project_2024/Peças e Montagens/Suporte da bateria.SLDPRT
Project_2024/Peças e Montagens/Suporte drible direito.SLDPRT
Project_2024/Peças e Montagens/Suporte drible esquerdo.SLDPRT
Project_2024/Peças e Montagens/Suporte frontal chute 2.SLDPRT
Project_2024/Peças e Montagens/Suporte frontal chute.SLDPRT
Project_2024/Peças e Montagens/Suporte interno carenagem.SLDPRT
Project_2024/Peças e Montagens/Suporte motor frontal direito.SLDPRT
Project_2024/Peças e Montagens/Suporte motor frontal esquerdo.SLDPRT
Project_2024/Peças e Montagens/Suporte traseiro chute 2.SLDPRT
Project_2024/Peças e Montagens/Traseira do acionador rasteiro.SLDPRT
Project_2024/Peças e Montagens/quadrado acrilico.SLDPRT
Project_2024/Peças e Montagens/suporte interno cores.SLDPRT
Project_2024/Sistema de chute/5x9x4 do Chute.SLDPRT
Project_2024/Sistema de chute/Acionador Chute Alto.SLDPRT
Project_2024/Sistema de chute/Capa do detector direito.SLDPRT
Project_2024/Sistema de chute/Carretel do Solenoide Alto.SLDPRT
Project_2024/Sistema de chute/Carretel do Solenoide.SLDPRT
Project_2024/Sistema de chute/Chute Rasteiro.SLDPRT
Project_2024/Sistema de chute/Eixo do Chute.SLDPRT
Project_2024/Sistema de chute/EspelharSuporte direito driblador.SLDPRT
Project_2024/Sistema de chute/Intermediario Chute Alto.SLDPRT
Project_2024/Sistema de chute/Intermediário Chute-Alto.SLDPRT
Project_2024/Sistema de chute/Mockup motor do driblador.SLDPRT
Project_2024/Sistema de chute/Pistão Chute Alto.SLDPRT
Project_2024/Sistema de chute/Pistão.SLDPRT
Project_2024/Sistema de chute/Representação Bobina de Cobre.SLDPRT
Project_2024/Sistema de chute/Representação Eixo do Chute.SLDPRT
Project_2024/Sistema de chute/Suporte Chute-Alto Direito.SLDPRT
Project_2024/Sistema de chute/Suporte Chute-Alto Esquerdo.SLDPRT
Project_2024/Sistema de chute/Suporte Frontal.SLDPRT
Project_2024/Sistema de chute/Suporte esquerdo driblador.SLDPRT
Project_2024/Sistema de chute/Suporte traseiro.SLDPRT
Project_2024/Sistema de chute/Traseira do Acionador Alto.SLDPRT
Project_2024/Sistema de chute/plain washer 10669 type nl_iso.sldprt
Project_2024/Sistema de chute/polia.SLDPRT
Project_2024/Sistema de chute/rolete.SLDPRT
Robo 2021/SSL/Diversos/Assoalho - Copia.SLDPRT
Robo 2021/SSL/Diversos/Motor + Suporte + Caixa Redutora/SUPORTE_MOTOR LARC.SLDPRT
Robo 2021/SSL/Diversos/Sistema de chute Antigo/Base Drible Teste chute.STL
Robo 2021/SSL/Diversos/Sistema de chute Antigo/Base Drible Teste chute.sldprt
Robo 2021/SSL/Diversos/Sistema de chute Antigo/Base para Chute.STL
Robo 2021/SSL/Diversos/Sistema de chute Antigo/Batente chute.SLDPRT
Robo 2021/SSL/Diversos/Sistema de chute Antigo/Carrete_solenoide_rasteiro 11mm.SLDPRT
Robo 2021/SSL/Diversos/Sistema de chute Antigo/Carrete_solenoide_rasteiro 11mm.STL
Robo 2021/SSL/Diversos/Sistema de chute Antigo/Eixo CHUTE RASTEIRO 2019.SLDPRT
Robo 2021/SSL/Diversos/Sistema de chute Antigo/Eixo CHUTE RASTEIRO(1).SLDPRT
Robo 2021/SSL/Diversos/Sistema de chute Antigo/Eixo CHUTE RASTEIRO.SLDDRW
Robo 2021/SSL/Diversos/Sistema de chute Antigo/Eixo CHUTE RASTEIRO.SLDPRT
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
