roboime/SSL-Mec/Robo 2021/SSL/Robô/Mockup Mainboard (2).pdf

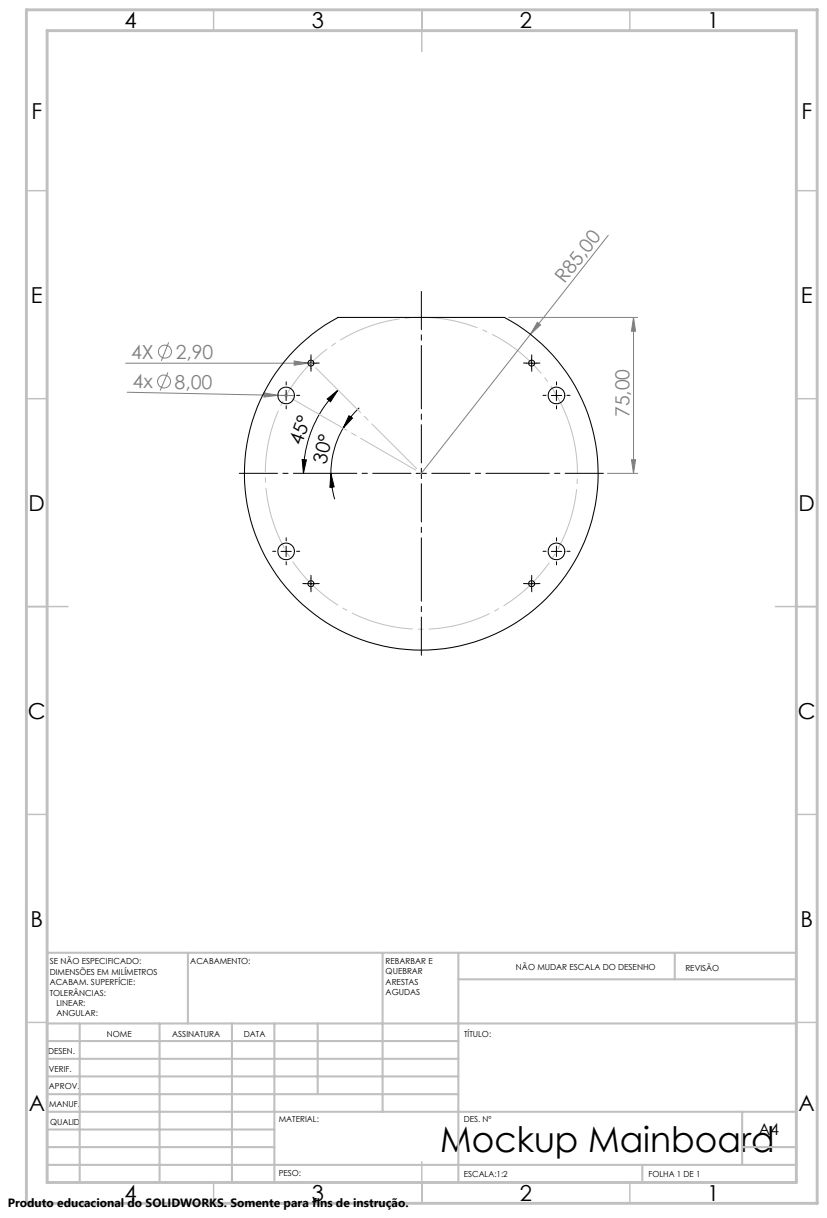
[picture p136: page 1]
ACABAMENTO:; REBARBAR E; NÃO MUDAR ESCALA DO DESENHO; REVISÃO; ESCALA:1:2; FOLHA 1 DE 1

SE NÃO ESPECIFICADO:
DIMENSÕES EM MILÍMETROS
ACABAM. SUPERFÍCIE:
TOLERÂNCIAS:
LINEAR:
ANGULAR:

NOME | ASSINATURA | DATA | | | | TÍTULO:

DESEN.
VERIF.
APROV.
MANUF.
QUALID | | | | MATERIAL: Mockup Mainboard | DES. Nº | A4

Produto educacional do SOLIDWORKS. Somente para fins de instrução.
