roboime/SSL-Mec/Robo 2021/SSL/Diversos/Sistema de chute Antigo/Pistão_Chute_Alto_9mm.PDF

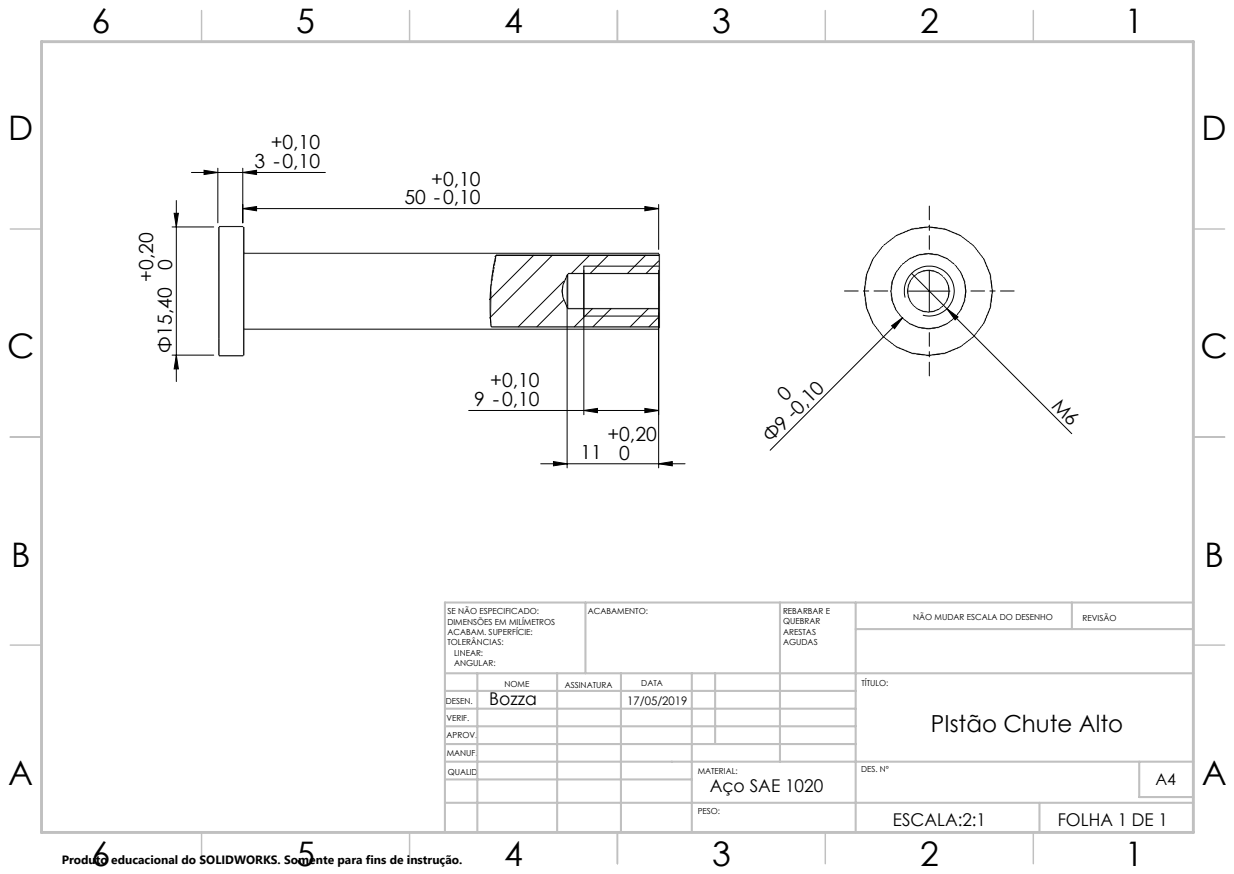
[picture p137: page 1]
ACABAMENTO:; REBARBAR E; NÃO MUDAR ESCALA DO DESENHO; REVISÃO; DES. Nº; ESCALA:2:1; FOLHA 1 DE 1

SE NÃO ESPECIFICADO:
DIMENSÕES EM MILÍMETROS
ACABAM. SUPERFÍCIE:
TOLERÂNCIAS:
LINEAR:
ANGULAR:

DESEN. | Bozza | | 17/05/2019

NOME | ASSINATURA | DATA | | | TÍTULO: PIstão Chute Alto

VERIF.
APROV.
MANUF.
QUALID | | | | MATERIAL: Aço SAE 1020 | A4

Produto educacional do SOLIDWORKS. Somente para fins de instrução.
