roboime/SSL-Mec/Robo 2021/SSL/Diversos/Sistema de chute Antigo/Pistão_Chute_Rasteiro_11mm.PDF

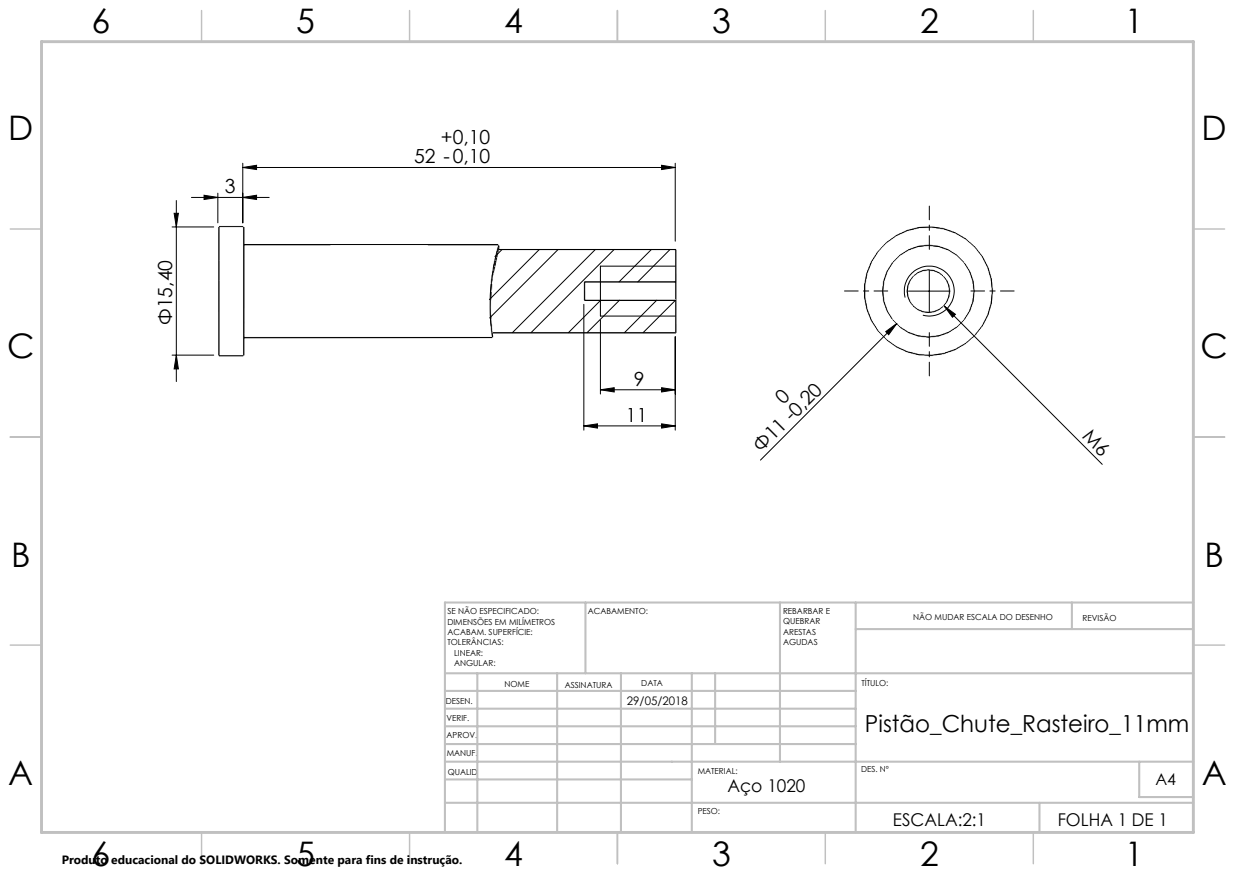
[picture p138: page 1]
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

SE NÃO ESPECIFICADO:
DIMENSÕES EM MILÍMETROS
ACABAM. SUPERFÍCIE:
TOLERÂNCIAS:
LINEAR:
ANGULAR:

NOME | ASSINATURA | DATA | | | TÍTULO: Pistão_Chute_Rasteiro_11mm

DESEN. | | | 29/05/2018
VERIF.
APROV.
MANUF.
QUALID | | | | MATERIAL: Aço 1020 | A4

Produto educacional do SOLIDWORKS. Somente para fins de instrução.
