roboime/SSL-Mec/Robo 2021/SSL/Diversos/Sistema de chute Antigo/Pistão_Chute_Rasteiro_11MM_4320.PDF

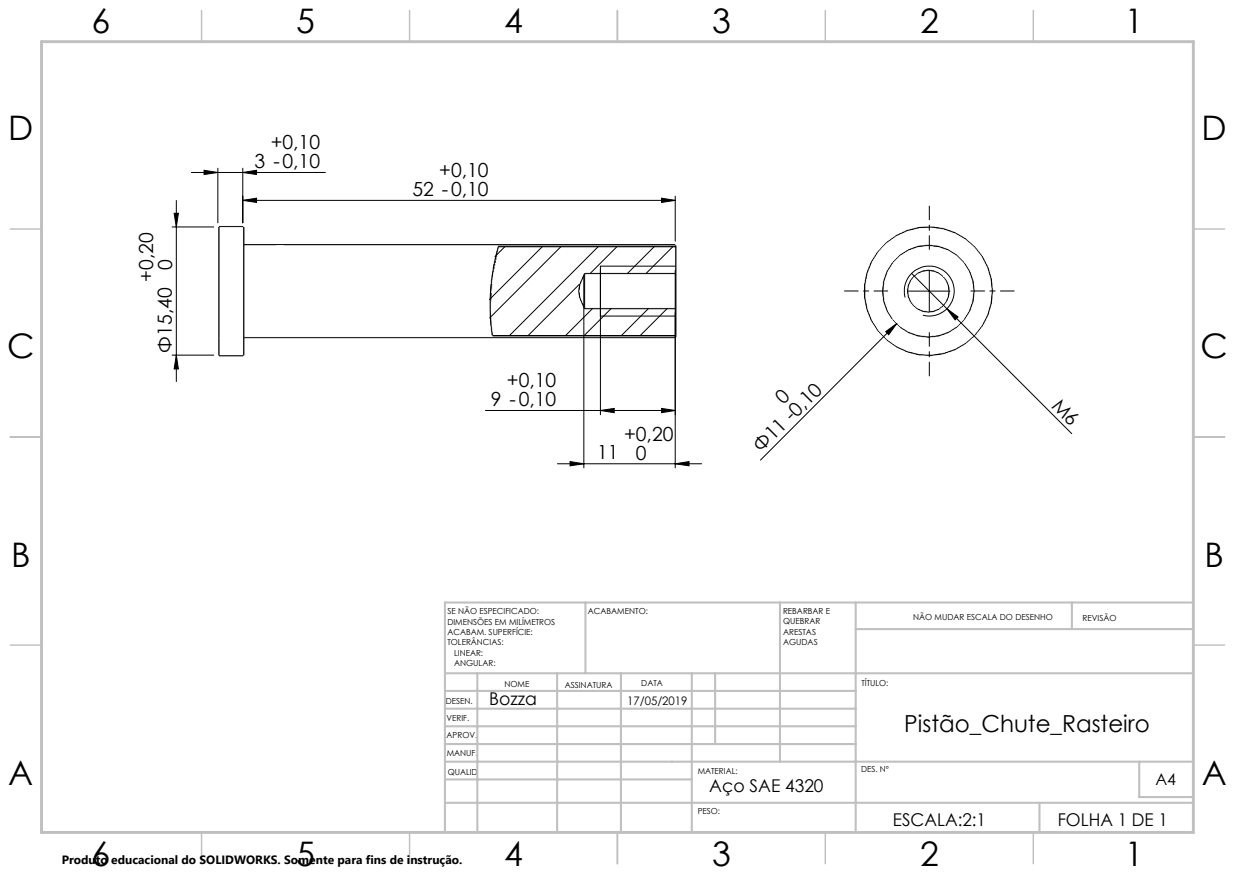
[picture p139: page 1]
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

SE NÃO ESPECIFICADO:
DIMENSÕES EM MILÍMETROS
ACABAM. SUPERFÍCIE:
TOLERÂNCIAS:
LINEAR:
ANGULAR:

DESEN. | Bozza | | 17/05/2019

NOME | ASSINATURA | DATA | | | TÍTULO: Pistão_Chute_Rasteiro

VERIF.
APROV.
MANUF.
QUALID | | | | MATERIAL: Aço SAE 4320 | A4

Produto educacional do SOLIDWORKS. Somente para fins de instrução.
