roboime/SSL-Mec/(commit log)

2021-10-04 Projeto SSL 2021
    Primeiro upload do projeto de 2021
    [022112022.step.SLDASM, 022112062.step.SLDASM, 06x01_Conector_Male_M0.step.SLDASM, 06x01_Conector_Male_M1.step.SLDASM, 06x01_Conector_Male_M2.step.SLDASM, 06x01_Conector_Male_M3.step.SLDASM, 1-15.step.SLDASM, 1.step.SLDPRT]
2021-10-11 Alterado acionador chute alto
    alterao acionador chute alto
    [Acionador Chute Alto 3.SLDPRT, Acionador Chute Rasteiro.SLDASM, Chute rasteiro novo.SLDPRT, Intermediário Chute-Alto.SLDPRT, Metric - Spur gear 0.4M 12T 20PA 2.5FW ---S12N75H50L2N.SLDPRT, Metric - Spur gear 0.5M 10T 20PA 12FW.SLDPRT, Metric - Spur gear 0.5M 10T 20PA 3,5FW.SLDPRT, Metric - Spur gear 0.5M 36T 20PA.SLDPRT]
2021-10-12 Update Suporte direito driblador.SLDPRT
    [Suporte direito driblador.SLDPRT]
2024-02-03 Sistema de Chute
    [5x9x4 do Chute.SLDPRT, Acionador Chute Alto 2.SLDASM, Acionador Chute Alto novo.SLDPRT, Acionador Chute Alto.SLDPRT, Acionador Chute Rasteiro.SLDASM, Apoio engrenagem.SLDPRT, Capa do detector direito.SLDPRT, Carretel do Solenoide Alto.SLDPRT]
